epidimobife96-rgb/shengyu-xinshi/docs/README.md

# 项目文档索引

本目录同时保留课程正式资料和早期调试记录。请先确认资料状态，再将其中参数用于当前板卡。

## 课程与设计资料

| 文件 | 用途 | 状态 |
| --- | --- | --- |
| `电子系统课程设计-声语信使-设计任务书.pdf` | 课程要求和测评依据 | 正式资料 |
| `声语信使前期设计报告.docx` | 方案论证和前期设计 | 阶段资料 |
| 咪头、扬声器规格书 | 器件参数查询 | 参考资料 |

## 调试与检查资料

| 文件 | 用途 | 状态 |
| --- | --- | --- |
| `硬件检查记录.md` | 第二版原理图和网表的早期审查 | 历史记录，部分软件结论已过期 |
| `调试记录汇总.md` | 一位数字原型的接收测试 | 历史记录，不代表当前 48 字符协议 |
| `前导码与同步相关代码问题总结报告.docx` | 早期同步问题分析 | 历史专题报告 |

## 当前入口

- 当前固件与操作说明：[`../software/stm32_second_board/README.md`](../software/stm32_second_board/README.md)
- 第二版硬件资料：[`../hardware/syxs_board/README.md`](../hardware/syxs_board/README.md)
- 7 月 13 日起非代码工作日志：[`../logs/工作日志-9组-范嘉毅-24271097.md`](../logs/工作日志-9组-范嘉毅-24271097.md)
