epidimobife96-rgb/shengyu-xinshi/hardware/syxs_board/README.md

# 声语信使板卡

> **资料状态：当前第二版硬件。** `声波传输test2final.epro2` 是当前最新版嘉立创 EDA 专业版工程；原理图、网表及早期导出包继续保留，便于核对和追溯。

- `声波传输test2final.epro2`：**当前最新版**嘉立创 EDA 专业版完整工程，来自云端项目“声波传输test2final”，云端最后更新时间为 `2026-07-19 11:36:08`，包含 2 套原理图和 2 块 PCB。
- `声语信使.pdf`：第二版整板原理图。
- `声语信使网表.net`：第二版整板网表。
- `声语信使第二版_含PCB.epro2`：较早的第二版 EasyEDA Pro 工程包，保留作历史对照。
- `Altium_声语信使第二版_含PCB.zip`：Altium 导出的第二版工程包，包含 `PCB1.pcbdoc`、`PCB2.pcbdoc` 和对应原理图文件。
- `Schematic1_1核心板.schdoc`：第二版核心板 Altium 原理图文件。

最新版工程包 SHA-256：`4159EFEC7A3336F0FE0CCA2CC18DD9F91F495201BFD0BACFA06A15F3F0631176`

## 实物调试记录（截至 2026-07-20）

- 接收反相放大链路的 `R16` 在距离测试中先调整为 `130 kΩ`，后进一步调整至 `270 kΩ`；测量板上实装值后再计算实际增益。
- 第二版测试板为解决启动瞬间输入掉压，将 `C3` 更换为 `10 µF` 后恢复正常开机。
- `C32` 曾在电源排障中暂时拆除；是否恢复 `47 µF` 应以 `5V_IN/5V_SYS` 启动波形和多次冷启动结果为准。
- 第三块板仍需重点复查 VCAP、R34、运放中点偏置以及接收滤波器电阻电容焊点；这些是待验证项，不是已经确认的设计错误。

详细过程见 [`../../logs/工作日志-9组-范嘉毅-24271097.md`](../../logs/工作日志-9组-范嘉毅-24271097.md)。
