epidimobife96-rgb/shengyu-xinshi/software/stm32_first_board_tx/README.md

# 第一版板卡发送端

> **状态：历史测试工程。** 当前答辩主工程位于 [`../stm32_second_board/`](../stm32_second_board/)。本目录用于保留第一版板卡验证过程。

STM32F411 第一版板卡 4-FSK 发送端测试工程。

- PWM 输出：`PA0 / TIM2_CH1`
- 功放静音控制：`PB12`
- 串口调试：`USART2 115200 8N1`
- 工程来源：`D:\stm32\test1_tx`

Keil 工程复用 `software/stm32_receive/Drivers` 下的 HAL/CMSIS 驱动，避免重复提交驱动库。
