epidimobife96-rgb/shengyu-xinshi/software/stm32_receive/README.md

# STM32 早期接收工程与共享驱动

> **状态：历史接收工程，同时承担共享驱动库。** 当前答辩固件位于 [`../stm32_second_board/`](../stm32_second_board/)。

本目录保留早期分立接收端 CubeMX/HAL/Keil 工程。`Drivers/` 中的 STM32F4 HAL/CMSIS 被第二版工程通过相对路径复用，因此整理历史代码时不要删除或移动 `Drivers/`。
