epidimobife96-rgb/shengyu-xinshi/hardware/speaker_filter/README.md

# 喇叭滤波器

发送端功放前滤波器设计资料。

- `喇叭滤波器设计.ms14`：Multisim 设计文件。
- `喇叭滤波器网表.txt`：对应网表导出。
