epidimobife96-rgb/shengyu-xinshi/software/python_tools/README.md

# PC 端辅助工具

> **状态：早期原型辅助工具。** 当前第二版板卡能够独立收发，不依赖本目录脚本运行。

- `voice test.py`：通过电脑声卡播放 4-FSK 测试音，用于早期接收端验证。
