epidimobife96-rgb/shengyu-xinshi/logs/9组-宋嘉恒-24211218.docx

喇叭发声时间：

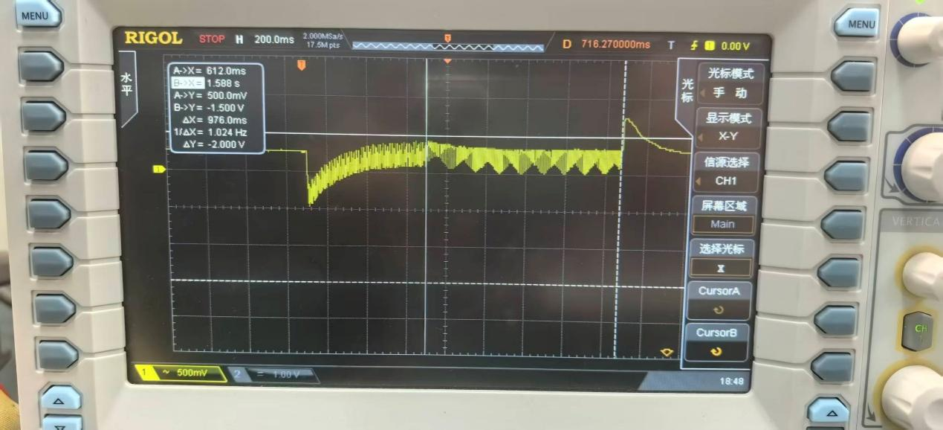
[picture p1: figure]

喇叭放电：

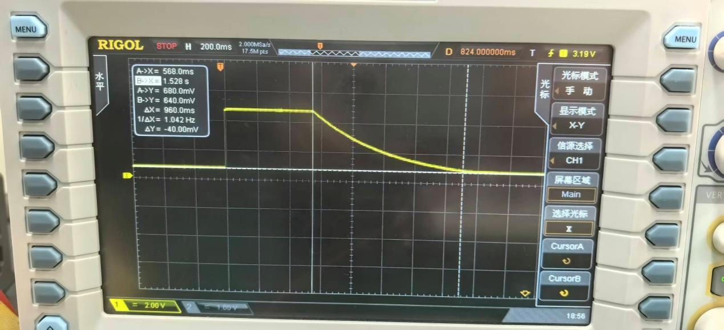
[picture p2: figure]

高频信号频率测量：

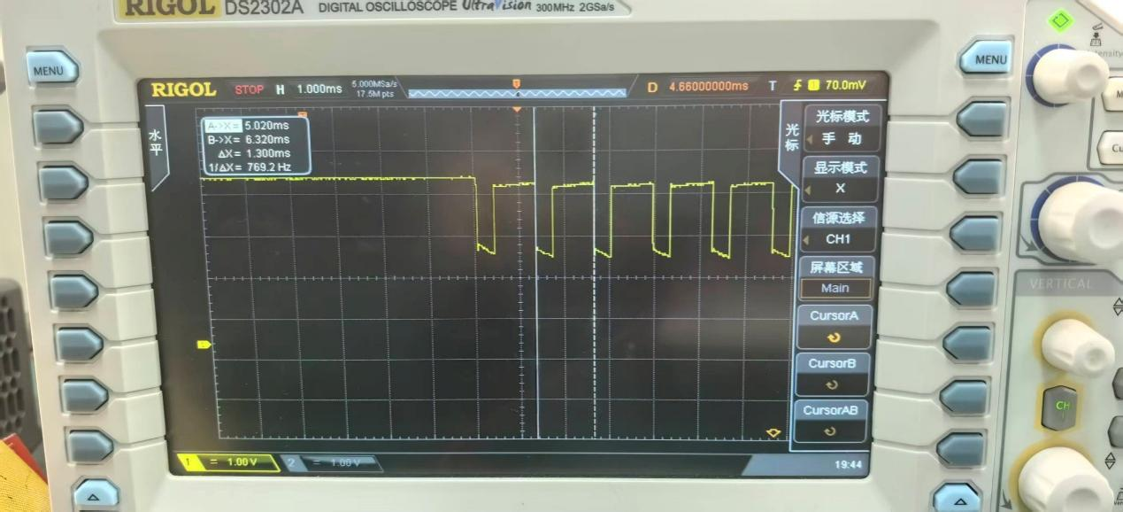
[picture p3: figure]

低频信号频率测量：

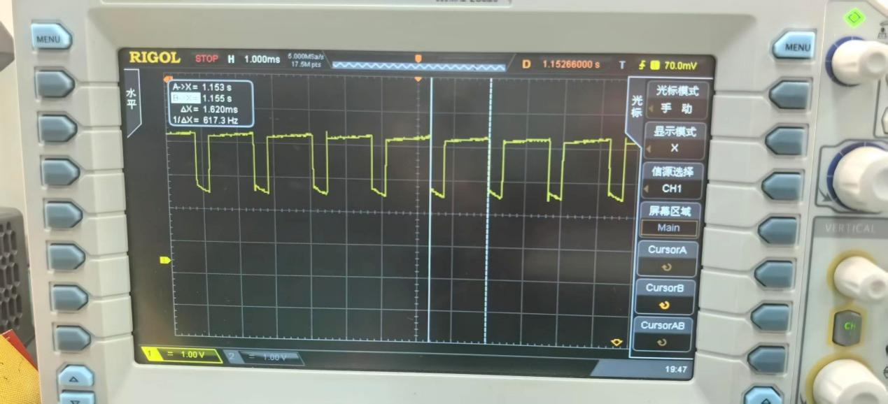
[picture p4: figure]

下降时间：

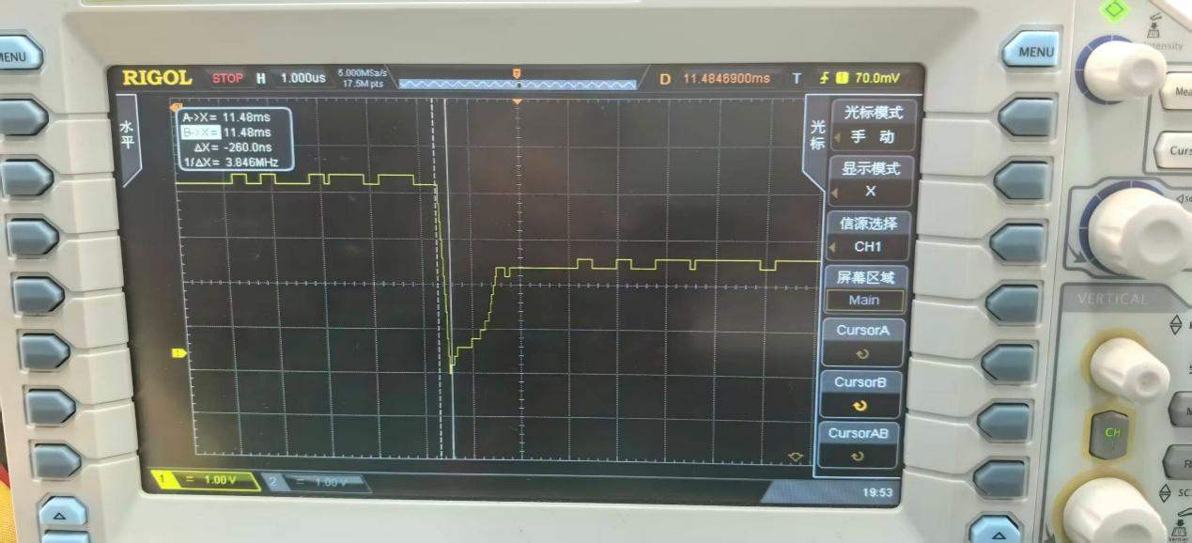
[picture p5: figure]

上升时间：

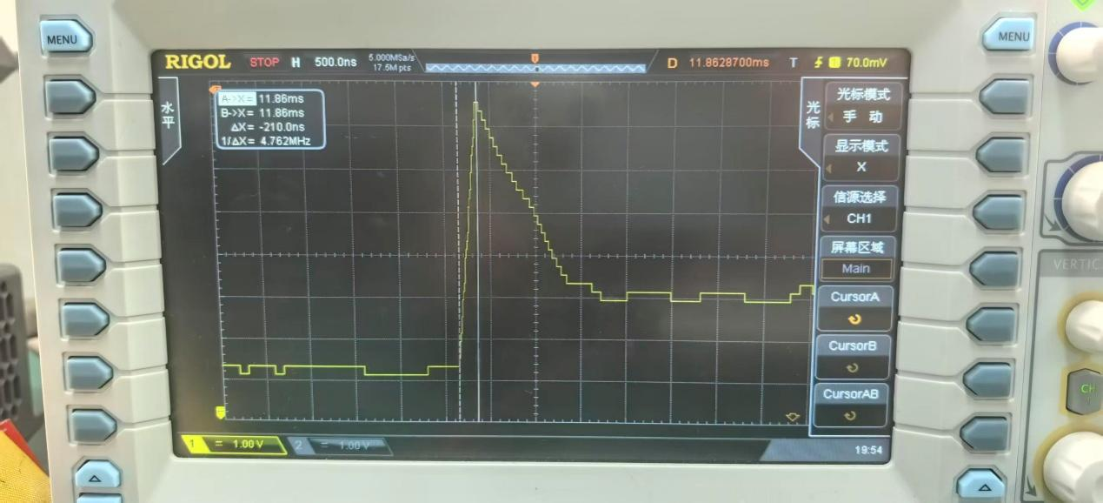
[picture p6: figure]

输出信号频率：

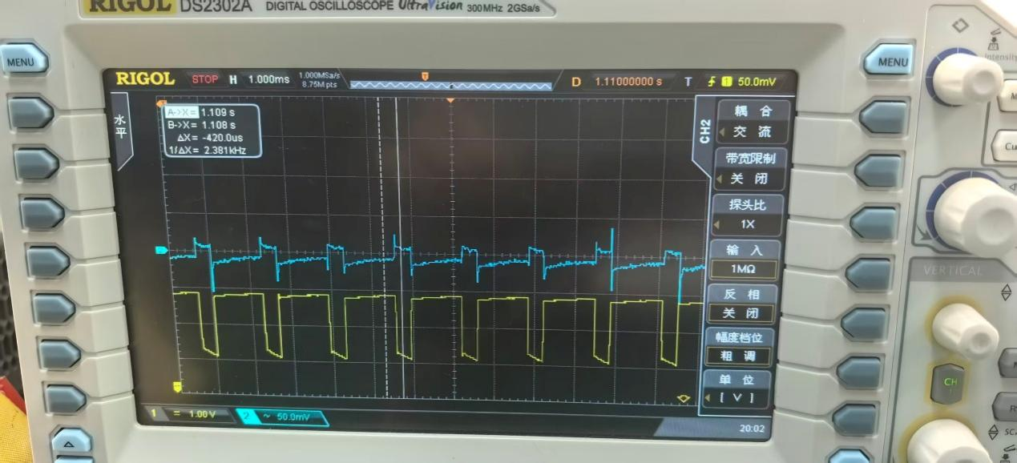
[picture p7: figure]

电源纹波测量：

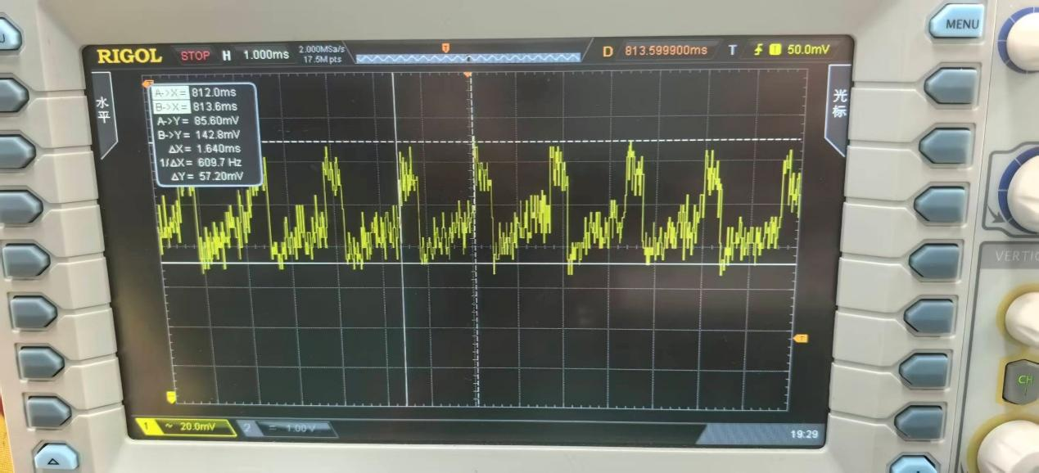
[picture p8: figure]
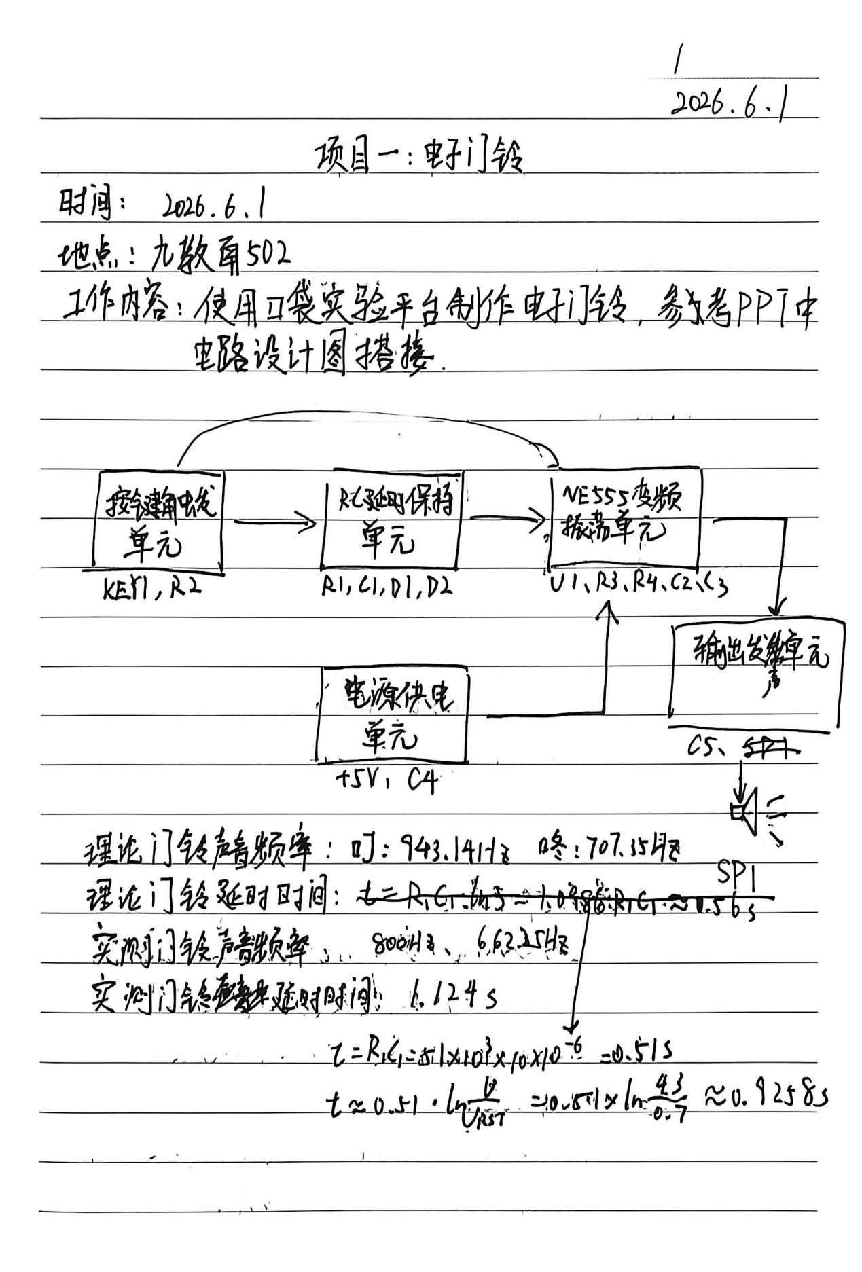
[picture p9: figure]
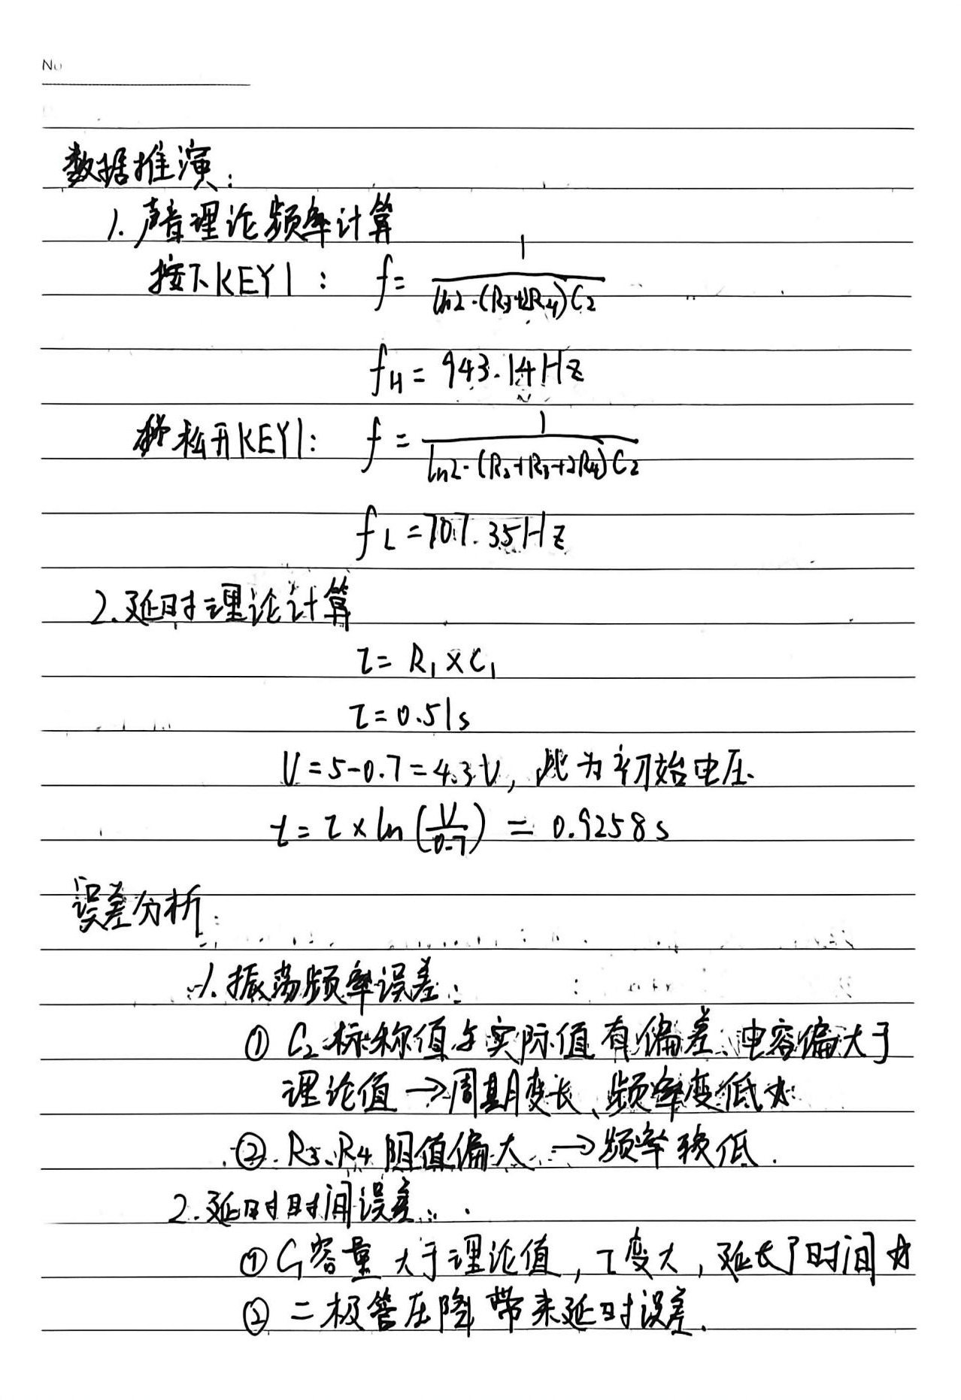
[picture p10: figure]
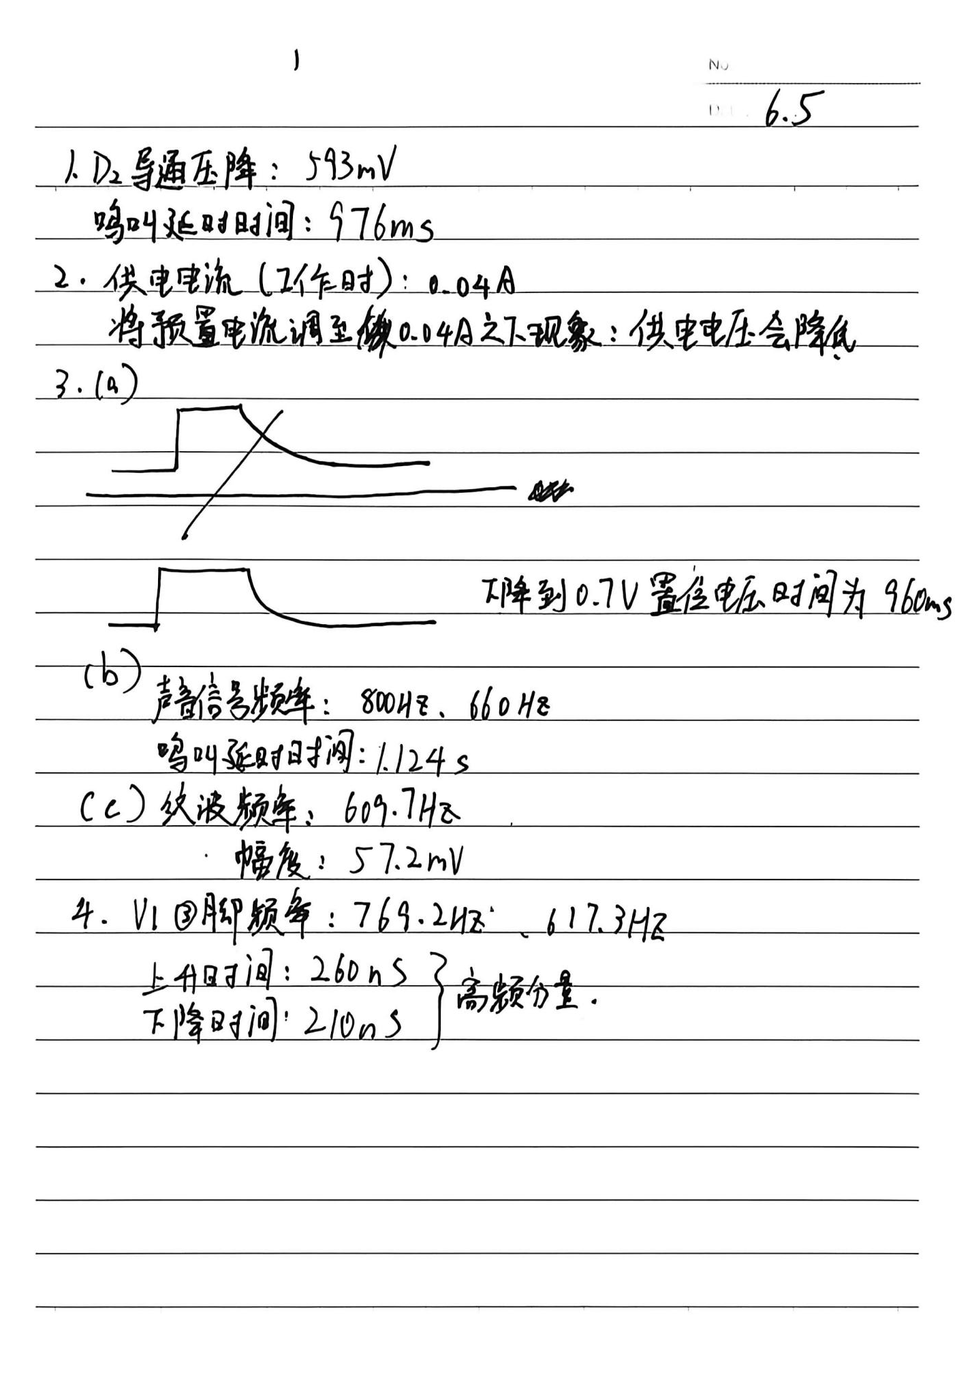
[picture p11: figure]
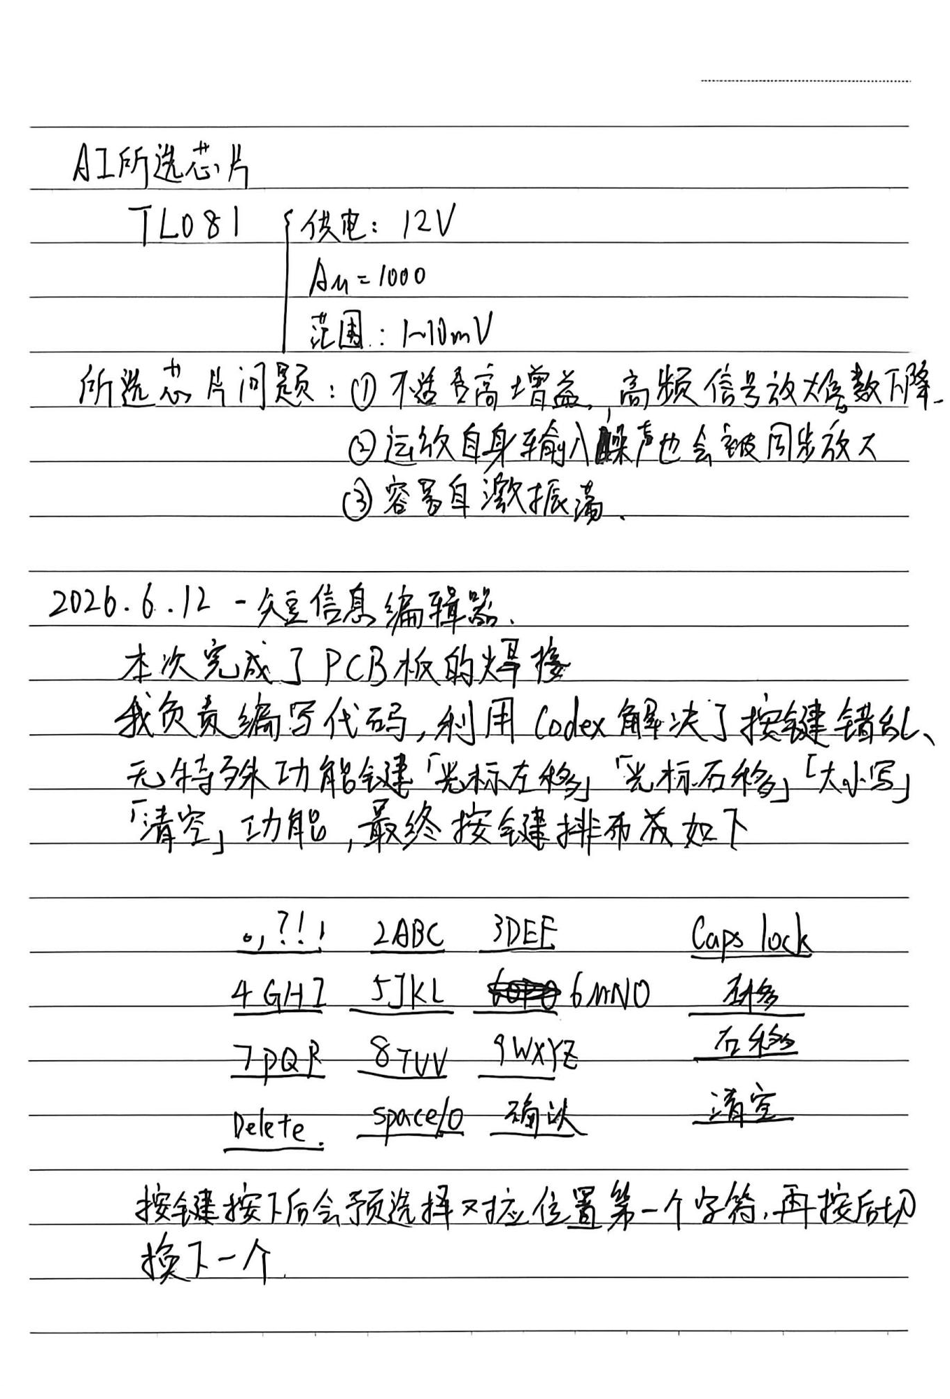
[picture p12: figure]
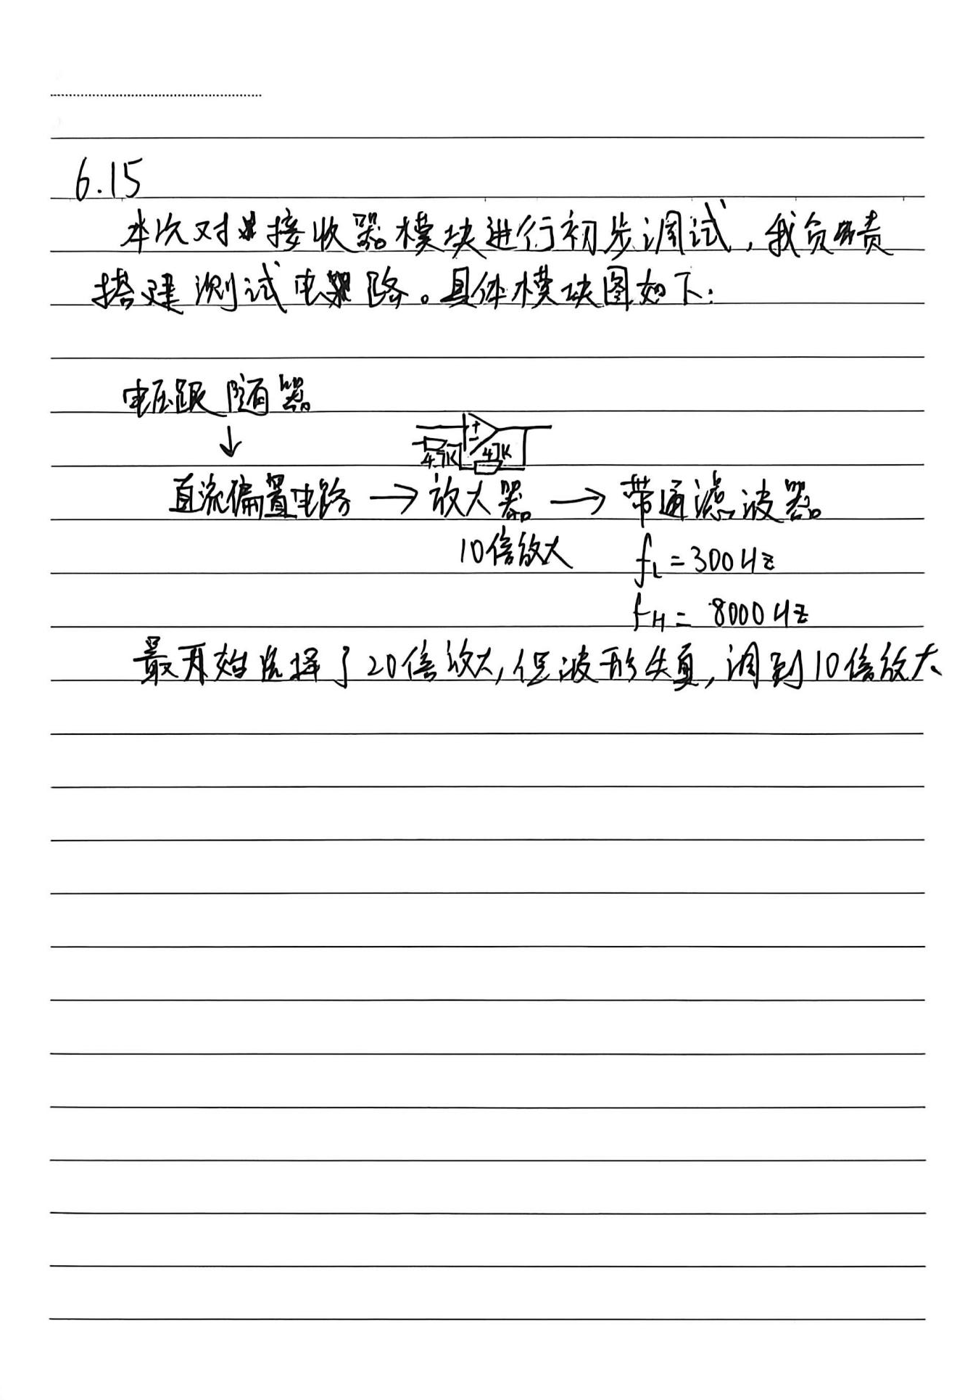
[picture p13: figure]

20260705更新

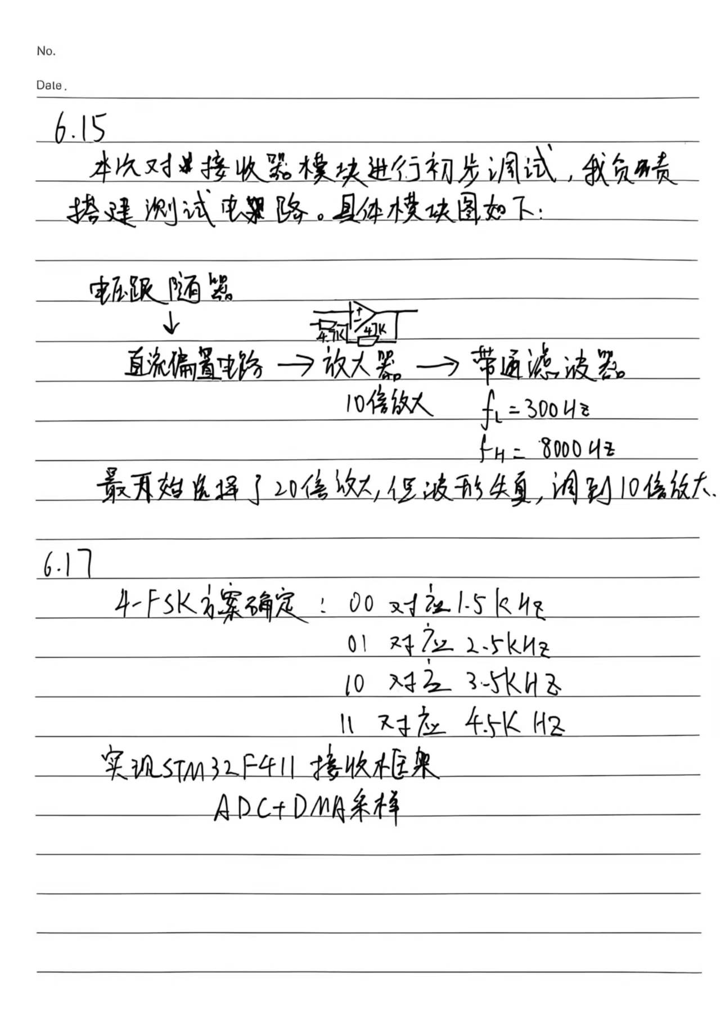
[picture p14: figure]
8bdfec3b620420859883c486c8d4a120
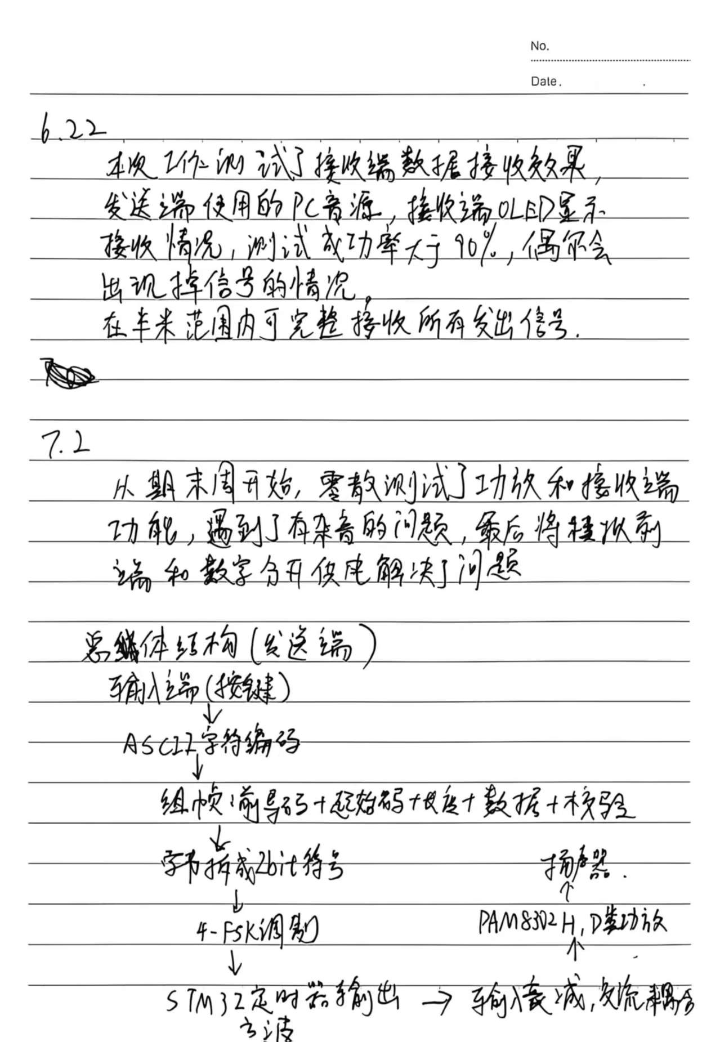
[picture p15: figure]
b882dd6c8d8499bfc34e1299eab81138
