epidimobife96-rgb/shengyu-xinshi/docs/C233956_咪头-麦克风_GMI9745P-32DB_规格书_WJ155228.PDF

GMI9745P 全指向驻积体咪头

详情说明

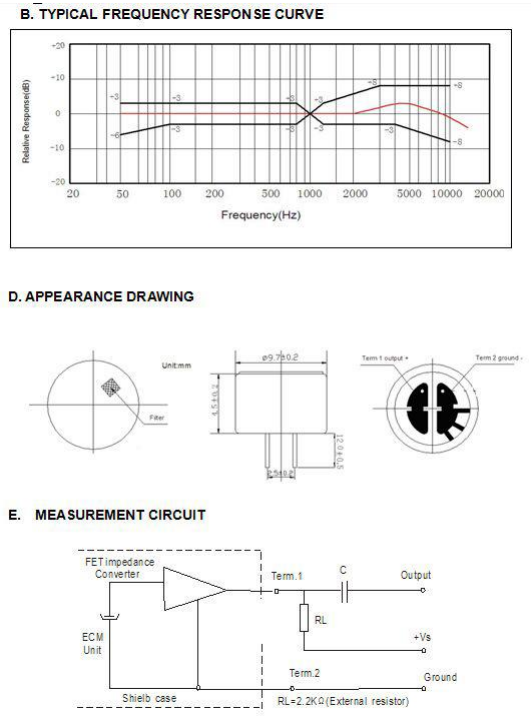
[picture p16: figure]

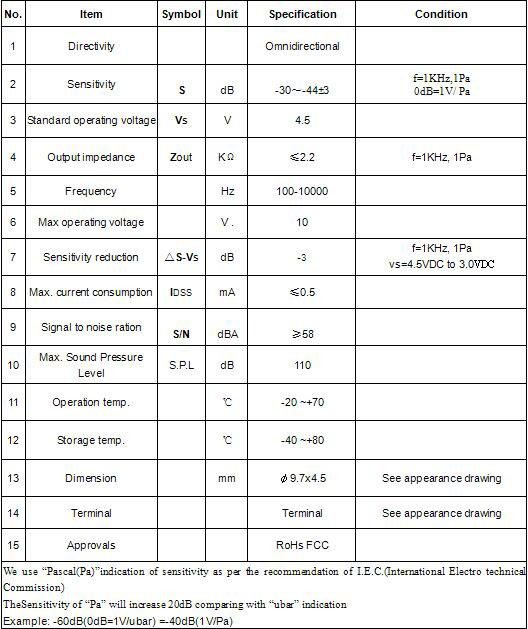
[picture p17: figure]
