epidimobife96-rgb/shengyu-xinshi/CHANGELOG.md

# 版本记录

## v1.0.0-demo - 2026-07-20

答辩演示版本。

- 将第二版板卡三模式收发固件设为当前主工程。
- 提供与源码对应的 `test2.hex`，完整帧时长约 19.941 秒。
- 加入“声语信使”及全体成员姓名、学号的 2 秒开机画面。
- 整理 STANDARD、MULTI-NODE、HIDDEN 三种模式的操作说明。
- 明确第二版硬件资料、实物器件调整和第三块板待复查项。
- 补充嘉立创 EDA 专业版云端项目“声波传输test2final”的最新版完整工程包，并保留早期工程作历史对照。
- 新增 2026 年 7 月 13 日起的非代码工作日志。
- 为 `docs/`、`hardware/`、`logs/`、`software/` 增加目录索引，并标注当前资料与历史资料。

构建结果：`0 Error(s), 3 Warning(s)`；警告均为 STM32 HAL 库未使用参数。

HEX SHA-256：`80D15BDB51B6F944610941480073471BF544B315394B95FF26E95740F8AD2A9D`

## 早期版本

早期提交保留了面包板、黑丸开发板、第一版整板、一位数字协议和 PC 播放测试等过程资料。它们用于说明迭代过程，不作为当前答辩固件入口。
