epidimobife96-rgb/shengyu-xinshi/hardware/syxs_board/声语信使.pdf

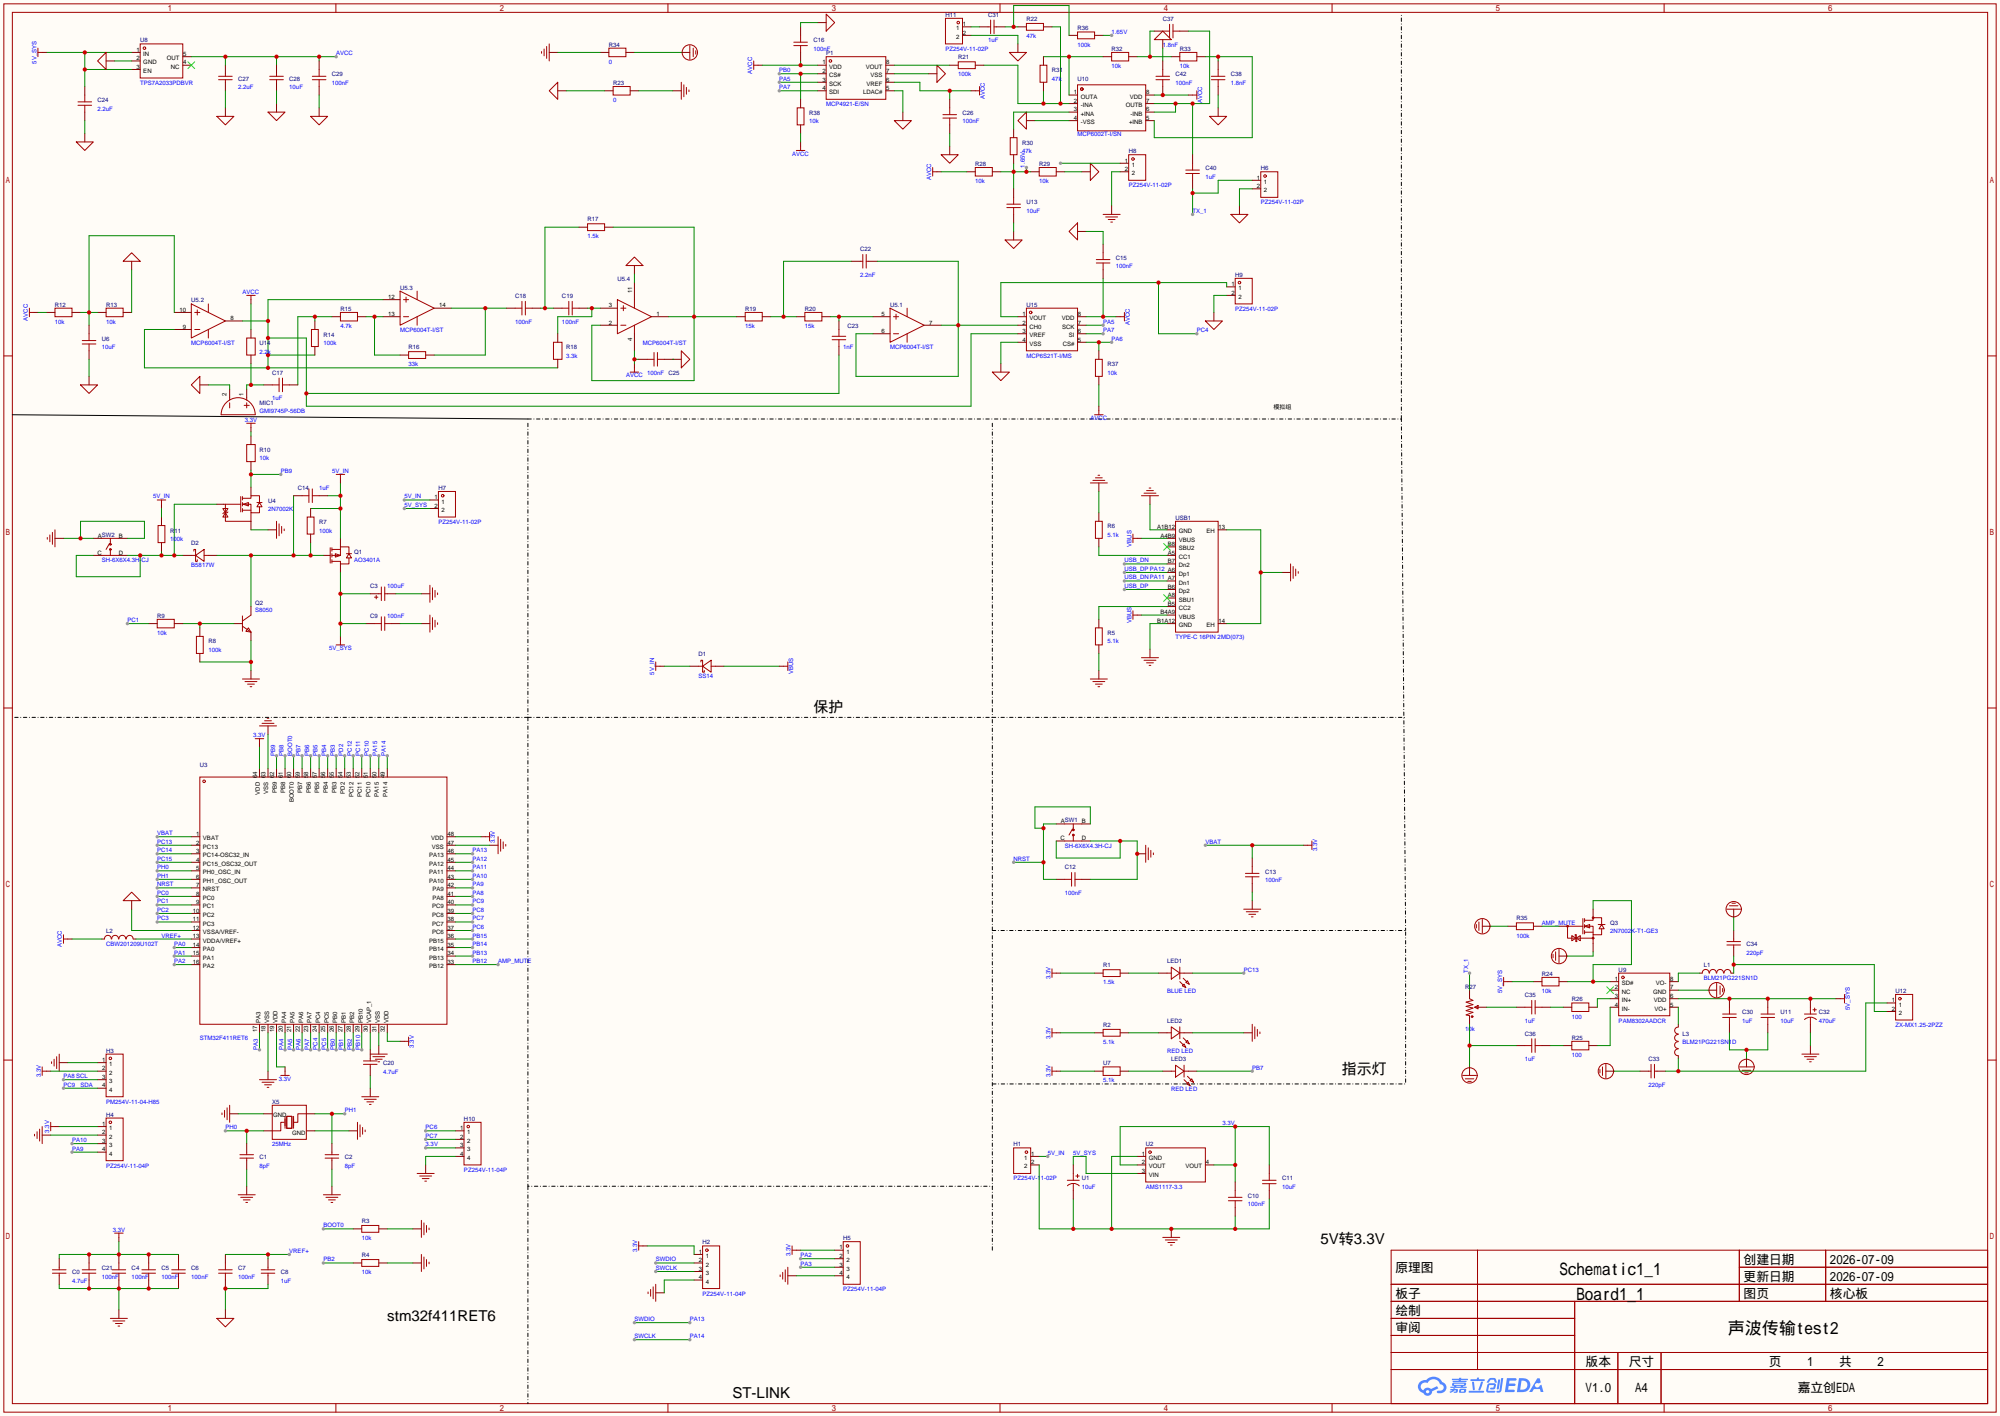
[picture p18: page 1]

原理图 | Schematic1_1 | 创建日期 | 2026-07-09
板子 | Board1_1 | 图页 | 核心板
绘制 | | 声波传输test2
审阅

更新日期 | 2026-07-09

V1.0 | A4 | 嘉立创EDA

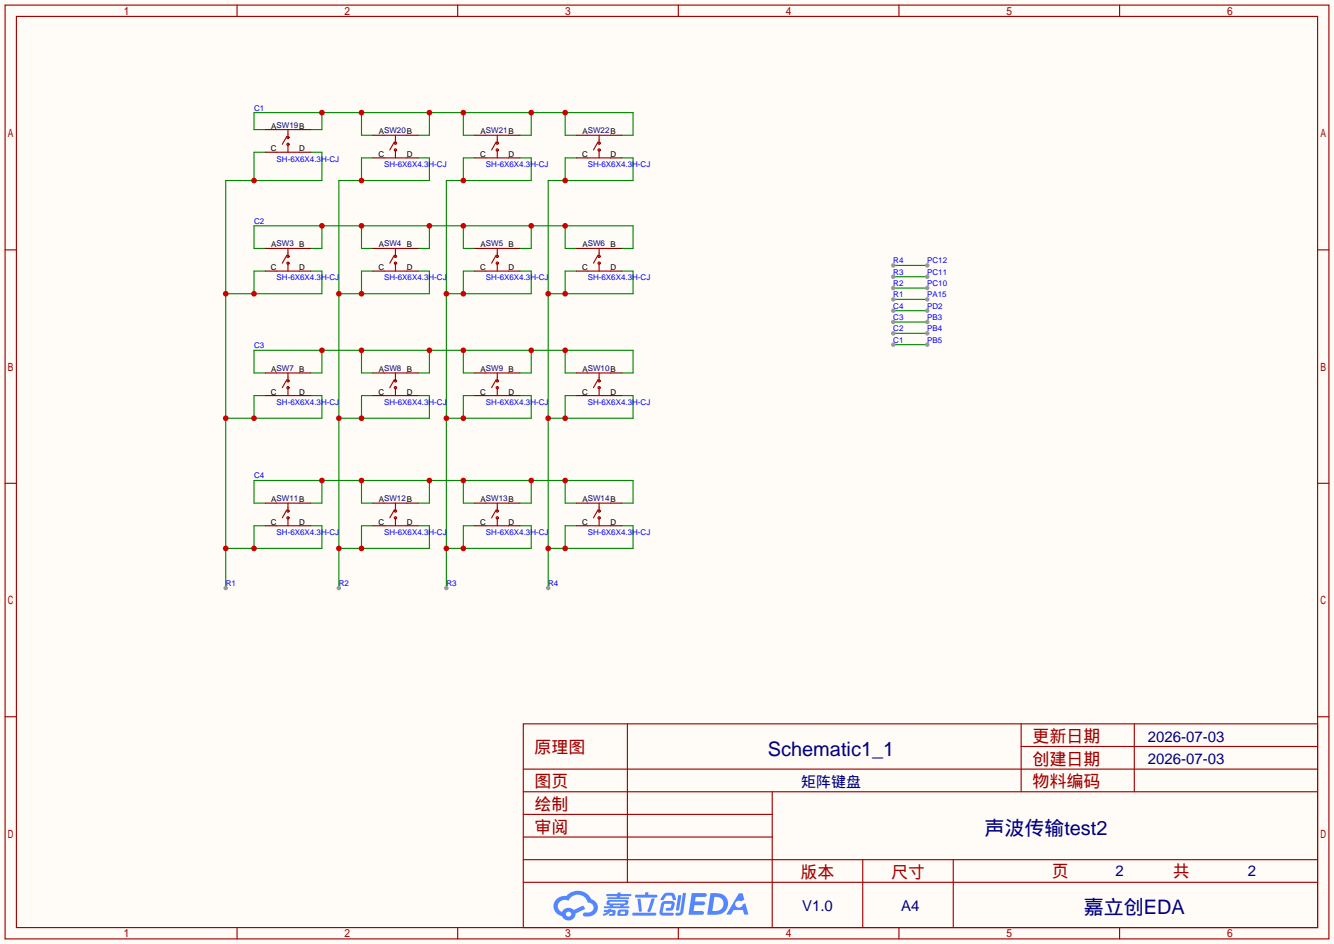
[picture p19: page 2]
