epidimobife96-rgb/shengyu-xinshi/hardware/mcu_board/短信息编辑器.pdf

# 用户按键

保护

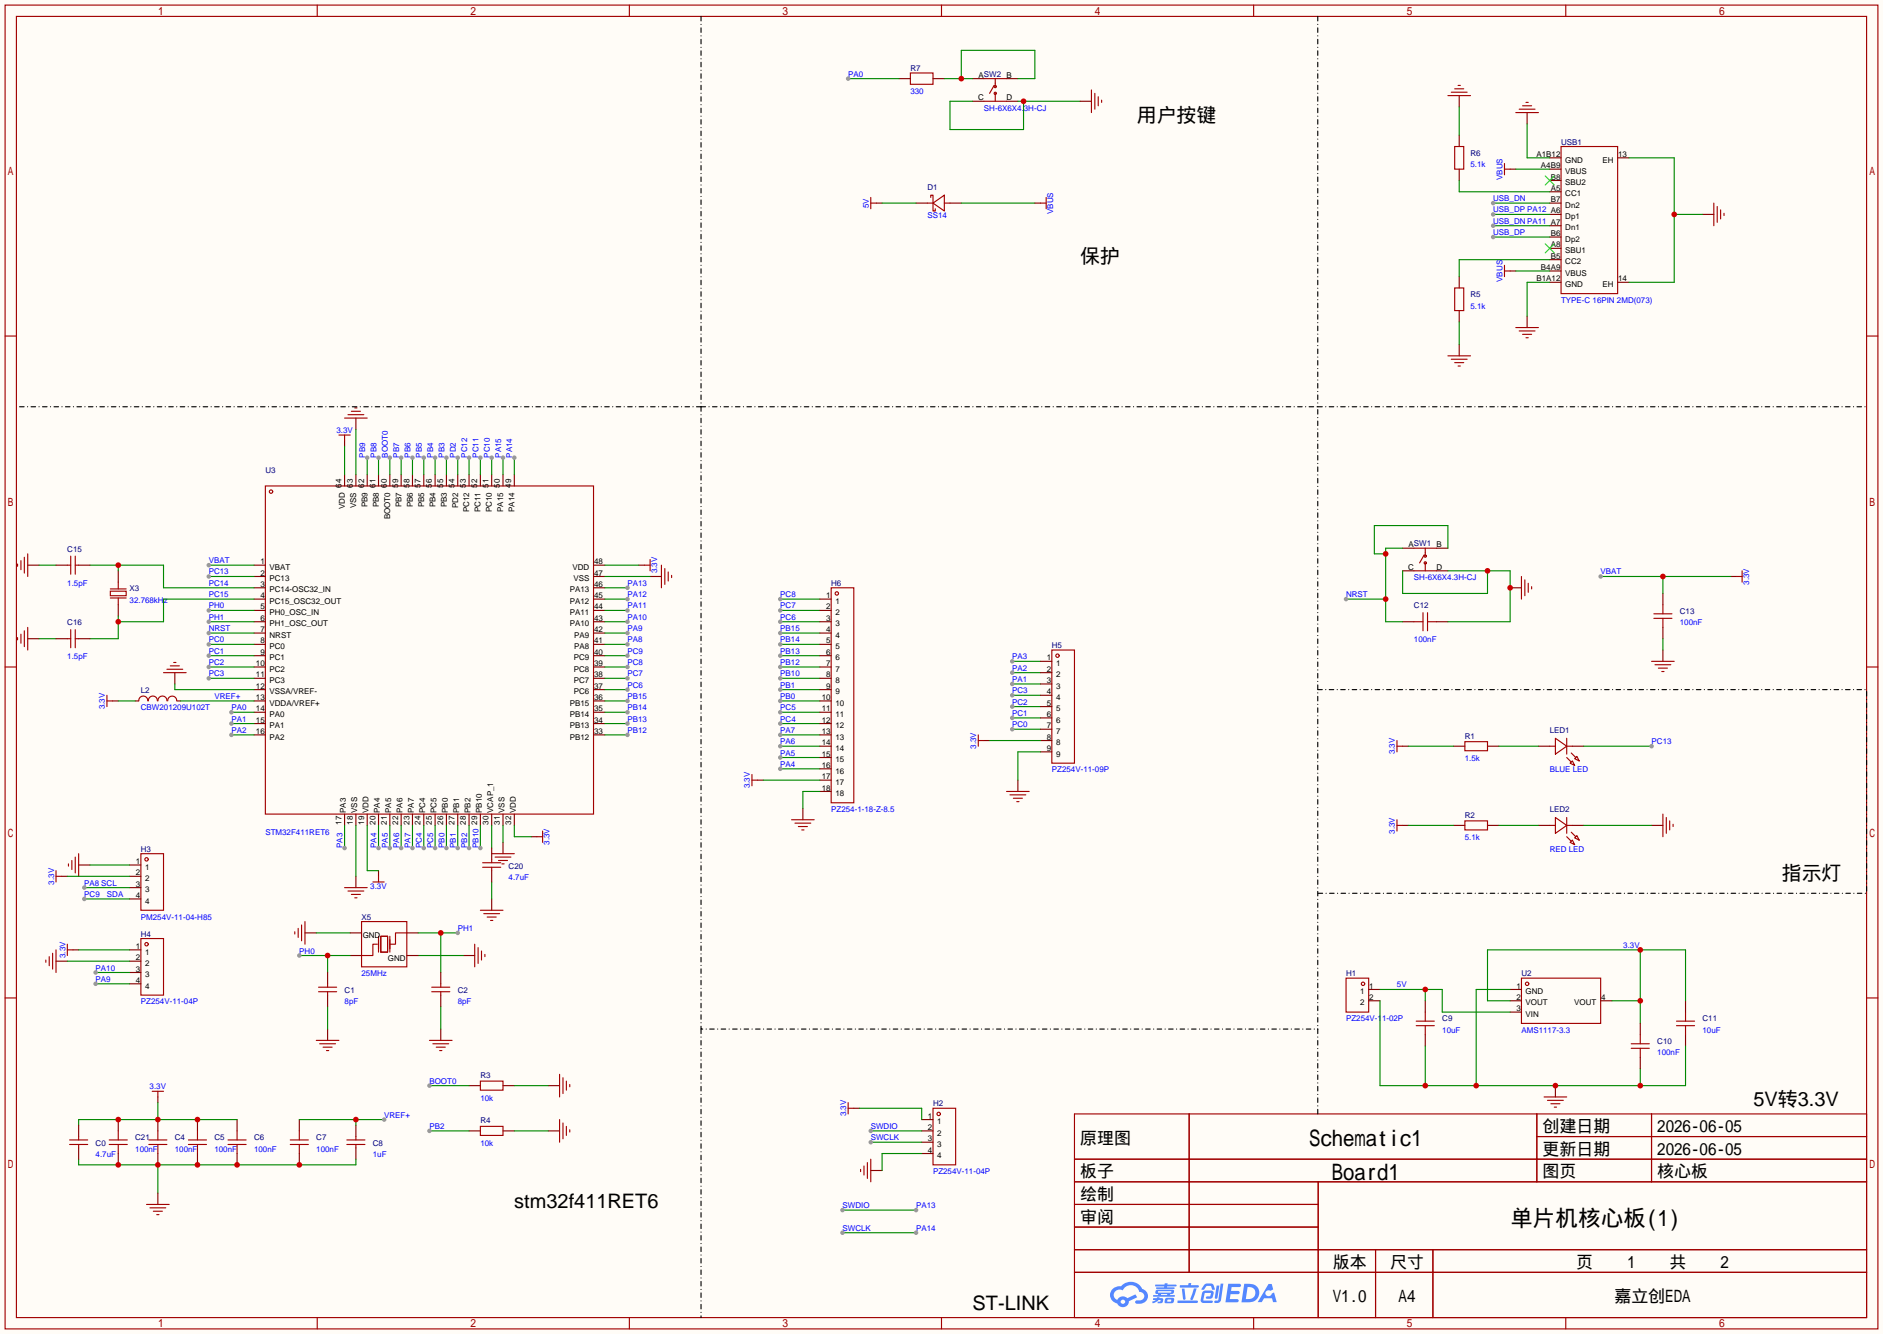
[picture p20: page 1]

原理图 | Schematic1 | 创建日期 | 2026-06-05

更新日期 | 2026-06-05

板子 | Board1 | 图页 | 核心板
绘制 | | 单片机核心板(1)
审阅

V1.0 | A4 | 嘉立创EDA

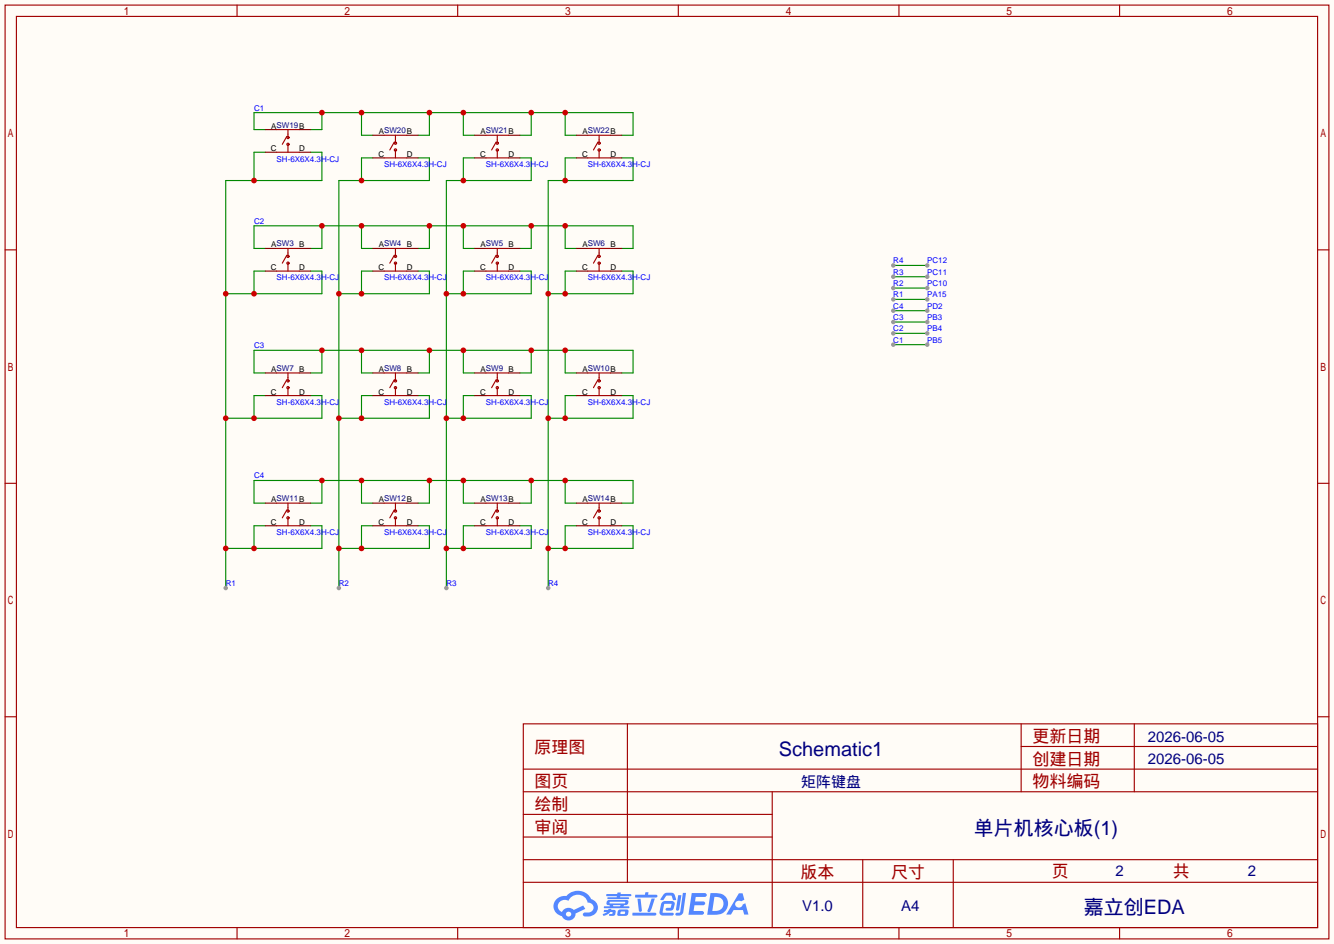
[picture p21: page 2]
