epidimobife96-rgb/shengyu-xinshi/(list of files, drawings)

Other design files:
hardware/filter/滤波器设计.ms14
hardware/speaker_filter/喇叭滤波器设计.ms14
hardware/syxs_board/Schematic1_1核心板.schdoc
