epidimobife96-rgb/shengyu-xinshi/software/stm32_second_board/Core/Src/main.c

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

#include "main.h"

/* USER CODE BEGIN Includes */
#include <stdio.h>
#include <string.h>
#include <math.h>
#if defined(__ARMCC_VERSION)
#include <rt_sys.h>
#endif
/* USER CODE END Includes */

/* USER CODE BEGIN Semihosting */
extern UART_HandleTypeDef huart2;

#if defined(__ARMCC_VERSION) && !defined(__CC_ARM)
__asm(".global __use_no_semihosting\n");
#endif

#if defined(__CC_ARM)
#pragma import(__use_no_semihosting)
#endif

#if defined(__CC_ARM) || defined(__ARMCC_VERSION)
void _ttywrch(int ch)
{
  (void)ch;
}

void _sys_exit(int status)
{
  (void)status;
  while (1)
  {
  }
}

FILEHANDLE _sys_open(const char *name, int openmode)
{
  (void)name;
  (void)openmode;
  return 1;
}

int _sys_close(FILEHANDLE fh)
{
  (void)fh;
  return 0;
}

int _sys_write(FILEHANDLE fh, const unsigned char *buf, unsigned len, int mode)
{
  (void)fh;
  (void)mode;
  HAL_UART_Transmit(&huart2, (uint8_t *)buf, (uint16_t)len, HAL_MAX_DELAY);
  return 0;
}

int _sys_read(FILEHANDLE fh, unsigned char *buf, unsigned len, int mode)
{
  (void)fh;
  (void)buf;
  (void)len;
  (void)mode;
  return 0;
}

int _sys_istty(FILEHANDLE fh)
{
  (void)fh;
  return 1;
}

int _sys_seek(FILEHANDLE fh, long pos)
{
  (void)fh;
  (void)pos;
  return -1;
}

long _sys_flen(FILEHANDLE fh)
{
  (void)fh;
  return -1;
}

int ferror(FILE *f)
{
  (void)f;
  return 0;
}
#endif
/* USER CODE END Semihosting */

/* USER CODE BEGIN PTD */
typedef struct
{
  uint8_t valid;
  uint16_t freq_hz;
  uint8_t bits;
  float max_energy;
  float second_energy;
  float data_energy[4U];
  float adc_mean;
  uint16_t adc_min;
  uint16_t adc_max;
} FSK_DetectResult;

typedef struct
{
  uint16_t fsk_index;
  uint8_t source;
  uint8_t selected_bits;
  float confidence;
  float energy[4U];
} RxDecisionDiagnostic;

typedef enum
{
  MSG_RX_SEARCH = 0,
  MSG_RX_START_0,
  MSG_RX_START_1,
  MSG_RX_RS_SYNC,
  MSG_RX_RS_CODEWORD,
  MSG_RX_END_0,
  MSG_RX_END_1
} MessageRxState;

typedef enum
{
  TX_MODE_IDLE = 0,
  TX_MODE_CALIBRATION,
  TX_MODE_FRAME
} TX_Mode;

typedef enum
{
  APP_MODE_RX = 0,
  APP_MODE_TX
} AppMode;

typedef enum
{
  COMM_MODE_UNSELECTED = 0,
  COMM_MODE_STANDARD,
  COMM_MODE_MULTI_NODE,
  COMM_MODE_HIDDEN
} CommunicationMode;

typedef enum
{
  TX_FRAME_TONE = 0,
  TX_FRAME_GAP
} TX_FramePart;

typedef enum
{
  MESSAGE_PAYLOAD_OK = 0,
  MESSAGE_PAYLOAD_CRC_FAIL,
  MESSAGE_PAYLOAD_DATA_AFTER_PAD,
  MESSAGE_PAYLOAD_INVALID_CODE,
  MESSAGE_PAYLOAD_EMPTY
} MessagePayloadStatus;
/* USER CODE END PTD */

/* USER CODE BEGIN PD */
#define FSK_NORMAL_FS_HZ          16000U
#define FSK_HIDDEN_FS_HZ          20000U
#define FSK_SYMBOL_MS             20U
#define FSK_NORMAL_SYMBOL_SAMPLES ((FSK_NORMAL_FS_HZ * FSK_SYMBOL_MS) / 1000U)
#define FSK_HIDDEN_SYMBOL_SAMPLES ((FSK_HIDDEN_FS_HZ * FSK_SYMBOL_MS) / 1000U)
#define FSK_MAX_SYMBOL_SAMPLES    FSK_HIDDEN_SYMBOL_SAMPLES
#define ADC_DMA_BUFFER_SAMPLES    (FSK_MAX_SYMBOL_SAMPLES * 2U)
#define TIM2_COUNTER_CLOCK_HZ     16000000U

#define FSK_FREQ_COUNT            5U
#define FSK_DATA_FREQ_COUNT       4U
#define FSK_RX_FREQ_00_HZ         1500U
#define FSK_SYNC_FREQ_HZ          2000U
#define FSK_RX_FREQ_01_HZ         2500U
#define FSK_RX_FREQ_10_HZ         3500U
#define FSK_RX_FREQ_11_HZ         4500U
#define FSK_HIGH_FREQ_00_HZ       6400U
#define FSK_HIGH_FREQ_01_HZ       6550U
#define FSK_HIGH_SYNC_FREQ_HZ     6700U
#define FSK_HIGH_FREQ_10_HZ       6850U
#define FSK_HIGH_FREQ_11_HZ       7000U
#define TX_HIGH_PROFILE_AMP       96U
/* Hidden mode uses the restored high-frequency profile. */
#define FSK_HIGH_PROFILE_ENABLE   1U
#define FSK_SYNC_SYMBOL           0x04U
#define FSK_ENERGY_THRESHOLD      5000000.0f
#define FSK_RATIO_THRESHOLD       1.3f
#define FSK_NOISE_MULTIPLIER      3.0f
#define FSK_NOISE_MIN_FLOOR       3000000.0f
#define FSK_SOFT_ENERGY_THRESHOLD 2500000.0f
#define FSK_SOFT_RATIO_THRESHOLD  1.05f
#define FSK_SOFT_NOISE_MULTIPLIER 1.15f
#define END1_SOFT_ACCEPT_MIN_MS    20U
#define END1_SOFT_ACCEPT_MAX_MS    210U

#define UART_IDLE_LOG_MS          1000U
#define OLED_IDLE_UPDATE_MS       1000U
#define OLED_VALID_UPDATE_MS      200U

#define DEBUG_UART_ENABLE         1U
#define FSK_PI                    3.14159265358979323846f
#define PREAMBLE_STABLE_WINDOWS   1U
#define START_STABLE_WINDOWS      2U
#define DIGIT_GAP_INVALID_WINDOWS 1U
#define RX_SAME_SYMBOL_REACCEPT_MS 65U
#define DIGIT_FRAME_TIMEOUT_MS    22000U
#define START_SEQUENCE_TIMEOUT_MS 400U
#define DIGIT_NO_SYMBOL           0xFFU
#define MSG_PREAMBLE_LEN          4U
#define MSG_START_LEN             2U
#define MSG_END_LEN               2U
#define RS_DATA_SYMBOLS           25U
#define RS_PARITY_SYMBOLS         10U
#define RS_CODEWORD_SYMBOLS       (RS_DATA_SYMBOLS + RS_PARITY_SYMBOLS)
#define RS_CORRECTABLE_SYMBOLS    (RS_PARITY_SYMBOLS / 2U)
#define RS_BLOCK_COUNT            2U
#define RS_TOTAL_DATA_SYMBOLS     (RS_DATA_SYMBOLS * RS_BLOCK_COUNT)
#define RS_TOTAL_PARITY_SYMBOLS   (RS_PARITY_SYMBOLS * RS_BLOCK_COUNT)
#define RS_TOTAL_CODEWORD_SYMBOLS (RS_CODEWORD_SYMBOLS * RS_BLOCK_COUNT)
#define RS_TOTAL_CORRECTABLE      (RS_CORRECTABLE_SYMBOLS * RS_BLOCK_COUNT)
#define RS_FSK_SYMBOLS_PER_SYMBOL 3U
#define RS_FIELD_ORDER            63U
#define RS_PRIMITIVE_POLY         0x43U
#define RS_PAD_VALUE              0x3FU
#define MESSAGE_CRC_SYMBOLS       2U
#define MESSAGE_MAX_LEN           (RS_TOTAL_DATA_SYMBOLS - MESSAGE_CRC_SYMBOLS)
#define MESSAGE_CRC12_POLY        0x080FU
#define MESSAGE_CRC12_MASK        0x0FFFU
#define MESSAGE_CODE_INVALID      0xFFU
#define TEXT_TAP_TIMEOUT_MS       800U

#define TX_AUDIO_FS_HZ            32000U
#define TX_PWM_PERIOD             255U
#define TX_PWM_MID                128U
#define TX_SINE_TABLE_SIZE        64U
#define TX_MAX_SINE_AMP           126U
#define TX_DAC_COMMAND_ACTIVE_1X  0x3000U
#define TX_DAC_CODE_SHIFT         4U
#define TX_DAC_MID_CODE           ((uint16_t)TX_PWM_MID << TX_DAC_CODE_SHIFT)
#define RX_PGA_DEFAULT_GAIN_CODE  0x07U  /* MCP6S21 gain code 7 = x32 */
#define RX_PGA_MULTI_GAIN_CODE    0x01U  /* MCP6S21 gain code 1 = x2 */
#define TX_TONE_MS                60U
#define TX_GAP_MS                 9U
#define TX_STEP_MS                (TX_TONE_MS + TX_GAP_MS)
#define TX_REPEAT_COUNT           1U
#define TX_FRAME_SYMBOLS_PER_REPEAT \
  (MSG_PREAMBLE_LEN + MSG_START_LEN + \
   (RS_TOTAL_CODEWORD_SYMBOLS * (RS_FSK_SYMBOLS_PER_SYMBOL + 1U)) + 1U + MSG_END_LEN)
#define TX_FRAME_MAX_SYMBOLS      (TX_FRAME_SYMBOLS_PER_REPEAT * TX_REPEAT_COUNT)
#define TX_FRAME_DURATION_MS      (TX_FRAME_MAX_SYMBOLS * TX_STEP_MS)
#define TX_TONE_SAMPLES           ((TX_AUDIO_FS_HZ * TX_TONE_MS) / 1000U)
#define TX_GAP_SAMPLES            ((TX_AUDIO_FS_HZ * TX_GAP_MS) / 1000U)
#define HALF_DUPLEX_RX_GUARD_MS   120U
#define RS_MARKER_INTERVAL_MS     ((RS_FSK_SYMBOLS_PER_SYMBOL + 1U) * TX_STEP_MS)
#define RS_SLOT_WIDTH_MS          TX_STEP_MS
#define RS_MARKER_ACCEPT_EARLY_MS 40U
#define RS_SLOT_CAPTURE_START_MS  40U
#define RS_SLOT_CAPTURE_END_MS    (RS_MARKER_INTERVAL_MS - 20U)
#define RS_SOFT_CAPTURE_START_MS  60U
#define RS_VOTE_RATIO_CAP         8.0f
#define RX_DIAG_WORST_COUNT       8U
#define RX_DECISION_VOTE          0U
#define RX_DECISION_NEAREST       1U
#define RX_DECISION_SOFT          2U
#define RX_DECISION_ERASURE       3U

#if TX_FRAME_DURATION_MS > 20100U
#error "TX message frame must remain no longer than 20.10 seconds"
#endif

#define CALIBRATION_STAGE_MS             1000U
#define CALIBRATION_PASS_COUNT            2U
#define CALIBRATION_BOUNDARY_MS            300U
#define CALIBRATION_BOUNDARY_STABLE_WINDOWS 5U
#define CALIBRATION_INTERPASS_GAP_MS      2000U
#define CALIBRATION_GAP_DETECT_MS         1200U
#define CALIBRATION_TX_GUARD_MS          300U
#define CALIBRATION_STAGE_SAMPLES        ((TX_AUDIO_FS_HZ * CALIBRATION_STAGE_MS) / 1000U)
#define CALIBRATION_BOUNDARY_SAMPLES     ((TX_AUDIO_FS_HZ * CALIBRATION_BOUNDARY_MS) / 1000U)
#define CALIBRATION_INTERPASS_GAP_SAMPLES ((TX_AUDIO_FS_HZ * CALIBRATION_INTERPASS_GAP_MS) / 1000U)
#define CALIBRATION_TX_GUARD_SAMPLES     ((TX_AUDIO_FS_HZ * CALIBRATION_TX_GUARD_MS) / 1000U)
#define CALIBRATION_STABLE_WINDOWS       5U
#define CALIBRATION_ENERGY_WINDOWS       12U
#define CALIBRATION_LOST_WINDOWS_MAX     3U
#define CALIBRATION_PROGRESS_TIMEOUT_MS  2500U
#define CALIBRATION_SCALE_MIN            0.005f
#define RX_PGA_ADC_LOW_PEAK              350U
#define RX_PGA_ADC_HIGH_PEAK             1650U
#define RX_PGA_ADC_CLIP_MARGIN            128U
#define RX_PGA_AGC_SETTLE_MS               60U
#define RX_PGA_AGC_HIGH_WINDOWS             4U
#define RX_PGA_AGC_CLIP_WINDOWS             3U
#define RX_PGA_AGC_LOW_WINDOWS              5U
#define RX_PGA_AGC_TONE_RATIO              1.8f
#define PREAMBLE_RECOVERY_ENERGY_MIN     5000000.0f
#define PREAMBLE_FRAME_SCALE_MIN_CORR     0.50f
#define PREAMBLE_FRAME_SCALE_MAX_CORR     2.00f
#define PREAMBLE_FRAME_MAX_4500_TO_3500   2.50f
#define PREAMBLE_RECOVERY_01_END_MS       70U
#define PREAMBLE_RECOVERY_10_START_MS     50U
#define PREAMBLE_RECOVERY_10_END_MS      140U
#define PREAMBLE_RECOVERY_11_START_MS    120U
#define PREAMBLE_RECOVERY_11_END_MS      210U
#define PREAMBLE_RECOVERY_START0_START_MS 190U
#define PREAMBLE_RECOVERY_START0_END_MS  255U
#define PREAMBLE_RECOVERY_START1_START_MS 260U
#define PREAMBLE_RECOVERY_START1_END_MS  330U
#define PREAMBLE_RECOVERY_MARKER_MIN_MS  300U
#define PREAMBLE_RECOVERY_MARKER_MAX_MS  400U

#define KEYPAD_ROWS               4U
#define KEYPAD_COLS               4U
#define KEYPAD_SCAN_MS            20U
#define KEYPAD_DEBOUNCE_SCANS     2U
#define KEYPAD_LONG_PRESS_MS      800U
#define KEY_NONE                  0U

#define OLED_I2C_ADDR_3C          (0x3CU << 1)
#define OLED_I2C_ADDR_3D          (0x3DU << 1)
#define OLED_WIDTH                128U
#define OLED_HEIGHT               64U
#define OLED_PAGES                (OLED_HEIGHT / 8U)

#define MESSAGE_STORE_VISIBLE_COUNT 5U
#define MESSAGE_STORE_FLASH_START   0x08060000UL
#define MESSAGE_STORE_FLASH_END     0x08080000UL
#define MESSAGE_STORE_MAGIC         0x3147534DUL
#define MESSAGE_STORE_COMMIT        0xA55AC33CUL
#define MESSAGE_STORE_LENGTH_MASK   0x000000FFUL
#define MESSAGE_STORE_SOURCE_SHIFT  8U
#define MESSAGE_STORE_DEST_SHIFT    10U
#define MESSAGE_STORE_ROUTE_MASK    0x00000F00UL
#define RX_COMPLETE_LED_ON_MS       3000U
/* USER CODE END PD */

ADC_HandleTypeDef hadc1;
DMA_HandleTypeDef hdma_adc1;
I2C_HandleTypeDef hi2c3;
SPI_HandleTypeDef hspi1;
TIM_HandleTypeDef htim2;
TIM_HandleTypeDef htim3;
UART_HandleTypeDef huart2;

/* USER CODE BEGIN PV */
typedef struct
{
  uint32_t magic;
  uint32_t sequence;
  uint32_t length;
  uint8_t text[MESSAGE_MAX_LEN];
  uint32_t hash;
  uint32_t commit;
} MessageStoreRecord;

typedef struct
{
  uint32_t sequence;
  uint8_t len;
  uint8_t source;
  uint8_t destination;
  char text[MESSAGE_MAX_LEN + 1U];
} StoredMessage;

static uint16_t adc_dma_buf[ADC_DMA_BUFFER_SAMPLES];
static volatile uint8_t symbol_ready = 0U;
static volatile uint16_t symbol_start_index = 0U;
static uint32_t fsk_sample_rate_hz = FSK_NORMAL_FS_HZ;
static uint16_t fsk_symbol_samples = FSK_NORMAL_SYMBOL_SAMPLES;

static const uint16_t fsk_normal_freqs_hz[FSK_FREQ_COUNT] = {
  FSK_RX_FREQ_00_HZ,
  FSK_RX_FREQ_01_HZ,
  FSK_RX_FREQ_10_HZ,
  FSK_RX_FREQ_11_HZ,
  FSK_SYNC_FREQ_HZ
};
#if FSK_HIGH_PROFILE_ENABLE != 0U
static const uint16_t fsk_high_freqs_hz[FSK_FREQ_COUNT] = {
  FSK_HIGH_FREQ_00_HZ,
  FSK_HIGH_FREQ_01_HZ,
  FSK_HIGH_FREQ_10_HZ,
  FSK_HIGH_FREQ_11_HZ,
  FSK_HIGH_SYNC_FREQ_HZ
};
#endif
static uint16_t fsk_tx_freqs_hz[FSK_FREQ_COUNT] = {
  FSK_RX_FREQ_00_HZ,
  FSK_RX_FREQ_01_HZ,
  FSK_RX_FREQ_10_HZ,
  FSK_RX_FREQ_11_HZ,
  FSK_SYNC_FREQ_HZ
};
static uint16_t fsk_rx_freqs_hz[FSK_FREQ_COUNT];
#if FSK_HIGH_PROFILE_ENABLE != 0U
static uint8_t fsk_high_profile_enabled = 0U;
#endif
static const uint8_t fsk_bits[FSK_FREQ_COUNT] = {0x00U, 0x01U, 0x02U, 0x03U, FSK_SYNC_SYMBOL};
static const uint8_t msg_preamble[MSG_PREAMBLE_LEN] = {0x00U, 0x01U, 0x02U, 0x03U};
static const uint8_t msg_end[MSG_END_LEN] = {0x02U, 0x03U};
static float fsk_goertzel_coeffs[FSK_FREQ_COUNT];
static float fsk_energy_scale[FSK_FREQ_COUNT];
static float calibration_energy_scale[FSK_DATA_FREQ_COUNT];

static float calibration_energy[FSK_DATA_FREQ_COUNT];
static float calibration_energy_sum = 0.0f;
static uint8_t calibration_energy_windows = 0U;
static uint8_t calibration_lost_windows = 0U;
static uint8_t calibration_stage = 0U;
static uint8_t calibration_stable_windows = 0U;
static uint8_t calibration_capture_active = 0U;
static uint8_t calibration_complete = 0U;
static uint8_t calibration_failed = 0U;
static uint32_t calibration_progress_tick = 0U;
static uint8_t calibration_pass = 0U;
static uint8_t calibration_coarse_activity = 0U;
static uint8_t calibration_boundary_windows = 0U;
static uint32_t calibration_coarse_last_signal_tick = 0U;
static uint16_t calibration_adc_min_seen = 0xFFFFU;
static uint16_t calibration_adc_max_seen = 0U;
static uint16_t calibration_adc_mean_last = 2048U;
static uint32_t rx_pga_agc_last_adjust_tick = 0U;
static uint8_t rx_pga_agc_high_windows = 0U;
static uint8_t rx_pga_agc_clip_windows = 0U;
static uint8_t rx_pga_agc_low_windows = 0U;
static const uint8_t rx_pga_gain_values[8U] = {1U, 2U, 4U, 5U, 8U, 10U, 16U, 32U};
static uint8_t rx_pga_gain_code = RX_PGA_DEFAULT_GAIN_CODE;

static uint16_t oled_i2c_addr = OLED_I2C_ADDR_3C;
static uint8_t oled_ready = 0U;
static float fsk_noise_floor[FSK_FREQ_COUNT] = {
  FSK_NOISE_MIN_FLOOR,
  FSK_NOISE_MIN_FLOOR,
  FSK_NOISE_MIN_FLOOR,
  FSK_NOISE_MIN_FLOOR,
  FSK_NOISE_MIN_FLOOR
};

static uint8_t digit_candidate_bits = DIGIT_NO_SYMBOL;
static uint8_t digit_candidate_count = 0U;
static uint8_t digit_invalid_count = 0U;
static uint8_t digit_run_active = 0U;
static uint8_t digit_run_bits = DIGIT_NO_SYMBOL;
static uint32_t digit_last_accept_ms = 0U;
static MessageRxState msg_rx_state = MSG_RX_SEARCH;
static uint8_t msg_preamble_index = 0U;
static uint32_t msg_start_entry_tick = 0U;
static float msg_preamble_energy[FSK_DATA_FREQ_COUNT];
static float msg_preamble_raw_top1[FSK_DATA_FREQ_COUNT];
static float msg_preamble_raw_top2[FSK_DATA_FREQ_COUNT];
static uint8_t msg_preamble_raw_count[FSK_DATA_FREQ_COUNT];
static uint32_t msg_preamble_raw_last_tick[FSK_DATA_FREQ_COUNT];
static uint8_t msg_preamble_capture_active = 0U;
static uint8_t msg_preamble_capture_stage = 0U;
static uint8_t msg_preamble_recovery_active = 0U;
static uint32_t msg_preamble_recovery_tick = 0U;
static float msg_preamble_recovery_energy[FSK_DATA_FREQ_COUNT];
static float msg_preamble_recovery_start_energy[MSG_START_LEN];
static uint8_t msg_preamble_recovery_start_bits[MSG_START_LEN];
static uint8_t local_node_id = 0U;
static uint8_t tx_destination_id = 0U;
static uint8_t msg_rx_source_id = 0U;
static uint8_t msg_rx_destination_id = 0U;
static uint8_t msg_rs_symbol_index = 0U;
static uint8_t msg_rs_fsk_index = 0U;
static uint8_t msg_rs_symbol = 0U;
static uint8_t msg_rs_codeword[RS_TOTAL_CODEWORD_SYMBOLS];
static uint8_t msg_rs_codeword_erased[RS_TOTAL_CODEWORD_SYMBOLS];
static float msg_rs_codeword_reliability[RS_TOTAL_CODEWORD_SYMBOLS];
static uint8_t msg_rs_current_erased = 0U;
static float msg_rs_current_reliability = RS_VOTE_RATIO_CAP;
static uint8_t msg_rs_erasure_count = 0U;
static uint8_t msg_soft_fallback_count = 0U;
static uint8_t msg_vote_override_count = 0U;
static uint32_t msg_marker_tick = 0U;
static uint8_t msg_capture_bits[RS_FSK_SYMBOLS_PER_SYMBOL];
static uint8_t msg_capture_valid[RS_FSK_SYMBOLS_PER_SYMBOL];
static uint8_t msg_capture_distance[RS_FSK_SYMBOLS_PER_SYMBOL];
static float msg_capture_scores[RS_FSK_SYMBOLS_PER_SYMBOL][4];
static float msg_capture_best_ratio[RS_FSK_SYMBOLS_PER_SYMBOL][FSK_DATA_FREQ_COUNT];
static float msg_capture_best_energy[RS_FSK_SYMBOLS_PER_SYMBOL][FSK_DATA_FREQ_COUNT][FSK_DATA_FREQ_COUNT];
static uint8_t msg_soft_bits[RS_FSK_SYMBOLS_PER_SYMBOL];
static uint8_t msg_soft_valid[RS_FSK_SYMBOLS_PER_SYMBOL];
static float msg_soft_score[RS_FSK_SYMBOLS_PER_SYMBOL];
static float msg_soft_ratio[RS_FSK_SYMBOLS_PER_SYMBOL];
static float msg_soft_energy[RS_FSK_SYMBOLS_PER_SYMBOL][FSK_DATA_FREQ_COUNT];
static RxDecisionDiagnostic msg_worst_decisions[RX_DIAG_WORST_COUNT];
static uint8_t msg_worst_decision_count = 0U;
static uint8_t msg_low_confidence_count = 0U;
static uint32_t msg_frame_tick = 0U;
static char rx_message[MESSAGE_MAX_LEN + 1U];
static uint8_t rx_message_len = 0U;
static uint8_t rx_message_valid = 0U;
static uint8_t rx_rs_corrected = 0U;
static uint8_t rx_message_source_id = 0U;
static uint8_t rx_message_destination_id = 0U;
static uint32_t rx_display_seq = 0U;
static uint32_t uart_symbol_seq = 0U;

static StoredMessage message_store_cache[MESSAGE_STORE_VISIBLE_COUNT];
static uint8_t message_store_count = 0U;
static uint8_t message_store_view_index = 0U;
static uint32_t message_store_next_sequence = 1U;
static uint32_t message_store_write_address = MESSAGE_STORE_FLASH_START;
static uint8_t message_store_pending = 0U;
static uint8_t message_store_pending_len = 0U;
static uint8_t message_store_pending_source = 0U;
static uint8_t message_store_pending_destination = 0U;
static char message_store_pending_text[MESSAGE_MAX_LEN + 1U];
static uint8_t message_store_last_save_failed = 0U;

static uint8_t rx_complete_led_active = 0U;
static uint32_t rx_complete_led_off_tick = 0U;

static uint8_t rs_gf_exp[RS_FIELD_ORDER * 2U];
static uint8_t rs_gf_log[RS_FIELD_ORDER + 1U];
static uint8_t rs_generator[RS_PARITY_SYMBOLS + 1U];

static const uint8_t tx_sine_table[TX_SINE_TABLE_SIZE] = {
  128, 140, 152, 165, 176, 188, 198, 208,
  218, 226, 234, 240, 245, 250, 253, 255,
  255, 255, 253, 250, 245, 240, 234, 226,
  218, 208, 198, 188, 176, 165, 152, 140,
  128, 115, 103,  90,  79,  67,  57,  47,
   37,  29,  21,  15,  10,   5,   2,   0,
    0,   0,   2,   5,  10,  15,  21,  29,
   37,  47,  57,  67,  79,  90, 103, 115
};
#if FSK_HIGH_PROFILE_ENABLE != 0U
static const uint8_t tx_normal_fsk_amp[FSK_FREQ_COUNT] = {
  30U,
  72U,
  TX_MAX_SINE_AMP,
  TX_MAX_SINE_AMP,
  60U
};
static const uint8_t tx_high_fsk_amp[FSK_FREQ_COUNT] = {
  TX_HIGH_PROFILE_AMP,
  TX_HIGH_PROFILE_AMP,
  TX_HIGH_PROFILE_AMP,
  TX_HIGH_PROFILE_AMP,
  TX_HIGH_PROFILE_AMP
};
#endif
static uint8_t tx_fsk_amp[FSK_FREQ_COUNT] = {
  30U,
  72U,
  TX_MAX_SINE_AMP,
  TX_MAX_SINE_AMP,
  60U
};
static const uint8_t tx_preamble_symbols[MSG_PREAMBLE_LEN] = {0x00U, 0x01U, 0x02U, 0x03U};
static const uint8_t tx_end_symbols[MSG_END_LEN] = {0x02U, 0x03U};

static volatile TX_Mode tx_mode = TX_MODE_IDLE;
static AppMode app_mode = APP_MODE_RX;
static CommunicationMode communication_mode = COMM_MODE_UNSELECTED;
static volatile TX_FramePart tx_frame_part = TX_FRAME_TONE;
static volatile uint32_t tx_phase = 0U;
static volatile uint32_t tx_phase_inc = 0U;
static volatile uint32_t tx_part_sample_count = 0U;
static volatile uint8_t tx_current_amp = 50U;
static volatile uint8_t tx_current_bits = 0U;
static volatile uint16_t tx_frame_index = 0U;
static volatile uint16_t tx_frame_len = 0U;
static volatile uint8_t tx_done_pending = 0U;
static volatile uint8_t tx_done_is_calibration = 0U;
static volatile uint8_t tx_calibration_stage = 0U;
static volatile uint8_t tx_calibration_pass = 0U;
static volatile uint8_t tx_calibration_boundary_active = 0U;
static volatile uint32_t tx_calibration_stage_sample_count = 0U;
static volatile uint8_t tx_calibration_sent = 0U;
static uint8_t tx_frame_symbols[TX_FRAME_MAX_SYMBOLS];
static uint8_t tx_last_valid = 0U;
static char tx_last_message[MESSAGE_MAX_LEN + 1U];
static uint8_t tx_last_len = 0U;
static uint8_t tx_display_sending = 0U;
static volatile uint8_t rx_sampling_active = 0U;
static uint8_t rx_resume_pending = 0U;
static uint32_t rx_resume_tick = 0U;

static char tx_text[MESSAGE_MAX_LEN + 1U];
static uint8_t tx_text_len = 0U;
static uint8_t tx_cursor_pos = 0U;
static uint8_t pending_active = 0U;
static char pending_key = 0;
static uint8_t pending_index = 0U;
static uint32_t pending_last_tick = 0U;

static uint8_t keypad_last_raw = KEY_NONE;
static uint8_t keypad_stable_key = KEY_NONE;
static uint8_t keypad_debounce_count = 0U;
static uint32_t keypad_last_scan_ms = 0U;
static uint32_t keypad_press_start_ms = 0U;
static uint8_t keypad_defer_short_press = 0U;
static uint8_t keypad_long_press_handled = 0U;

static GPIO_TypeDef *const keypad_row_ports[KEYPAD_ROWS] = {GPIOB, GPIOB, GPIOB, GPIOD};
static const uint16_t keypad_row_pins[KEYPAD_ROWS] = {GPIO_PIN_5, GPIO_PIN_4, GPIO_PIN_3, GPIO_PIN_2};
static GPIO_TypeDef *const keypad_col_ports[KEYPAD_COLS] = {GPIOA, GPIOC, GPIOC, GPIOC};
static const uint16_t keypad_col_pins[KEYPAD_COLS] = {GPIO_PIN_15, GPIO_PIN_10, GPIO_PIN_11, GPIO_PIN_12};
static const uint8_t keypad_map[KEYPAD_ROWS][KEYPAD_COLS] = {
  {'1', '2', '3', 'A'},
  {'4', '5', '6', 'B'},
  {'7', '8', '9', 'C'},
  {'*', '0', '#', 'D'}
};
/* USER CODE END PV */

void SystemClock_Config(void);
static void MX_GPIO_Init(void);
static void MX_DMA_Init(void);
static void MX_ADC1_Init(void);
static void MX_I2C3_Init(void);
static void MX_SPI1_Init(void);
static void MX_TIM2_Init(void);
static void MX_TIM3_Init(void);
static void MX_USART2_UART_Init(void);
/* USER CODE BEGIN PFP */
static void FSK_Init(void);
#if FSK_HIGH_PROFILE_ENABLE != 0U
static void FSK_ApplyProfile(uint8_t high_profile);
#endif
static void FSK_UpdateGoertzelCoefficient(uint8_t index);
static float FSK_WindowMean(const uint16_t *samples, uint16_t len);
static float Goertzel_EnergyWithMean(const uint16_t *samples, uint16_t len, float coeff, float mean);
static FSK_DetectResult FSK_DetectSymbol(const uint16_t *samples, uint16_t len);
static void FSK_ProcessSymbol(const uint16_t *samples);
static void Calibration_ResetProgress(void);
static void Calibration_StartVerificationPass(uint32_t now);
static void Calibration_Apply(void);
static void Calibration_ProcessBlock(const uint16_t *samples,
                                     const FSK_DetectResult *result,
                                     uint32_t now);
static const char *FSK_BitsToString(uint8_t bits);
static void MessageRx_Process(const FSK_DetectResult *result, uint32_t now);
static void MessageRx_AcceptSymbol(const FSK_DetectResult *result, uint32_t now);
static void MessageRx_ResetPreambleCapture(void);
static void MessageRx_AddPreambleRawWindow(uint8_t index,
                                           const FSK_DetectResult *result,
                                           uint32_t now);
static void MessageRx_CapturePreambleHardWindow(const FSK_DetectResult *result,
                                                 uint32_t now);
static void MessageRx_RestoreCalibrationEnergyScale(void);
static void MessageRx_ApplyPreambleFrameScale(void);
static void MessageRx_CaptureTimedPreamble(const FSK_DetectResult *result, uint32_t now);
static uint8_t MessageRx_TryTimedPreambleRecovery(uint32_t now);
static uint8_t MessageRx_DataWindowPosition(uint32_t now, uint8_t *slot,
                                             uint8_t *distance);
static uint8_t MessageRx_CaptureDataWindow(const FSK_DetectResult *result, uint32_t now);
static uint8_t MessageRx_SelectSoftDataCandidate(const FSK_DetectResult *result,
                                                  uint8_t *bits, float *max_energy,
                                                  float *second_energy, float *confidence);
static void MessageRx_CaptureSoftDataWindow(const FSK_DetectResult *result, uint32_t now);
static uint8_t MessageRx_TrySoftEnd1(const FSK_DetectResult *result, uint32_t now);
static void MessageRx_AppendRsBits(uint8_t decoded_bits, uint8_t erased,
                                   float confidence);
static void MessageRx_RecordDecision(uint16_t fsk_index, uint8_t source,
                                     uint8_t selected_bits, float confidence,
                                     const float *energy);
static void MessageRx_PrintDecisionDiagnostics(void);
static void MessageRx_ClearCapture(void);
static void MessageRx_FinalizeCapture(void);
static void MessageRx_ResetFrame(void);
static const char *MessageRx_StateName(MessageRxState state);
static void MessageRx_PrintSymbol(const FSK_DetectResult *result, uint32_t now);
static uint8_t Message_WhiteningMask(uint16_t fsk_symbol_index);
static uint8_t Node_SourceBitsFromId(uint8_t node_id);
static uint8_t Node_IdFromSourceBits(uint8_t bits);
static const char *Node_DestinationLabel(uint8_t destination);
static void Node_SetLocalId(uint8_t node_id);
static void Node_CycleDestination(void);
static uint8_t Message_CharToCode(char ch);
static char Message_CodeToChar(uint8_t code);
static uint16_t Message_Crc12Symbols(const uint8_t *symbols, uint8_t count);
static uint16_t Message_Crc12Addressed(uint8_t source, uint8_t destination,
                                      const uint8_t *symbols, uint8_t count);
static uint8_t Message_CrcSelfTest(void);
static MessagePayloadStatus Message_ValidateRsPayload(const uint8_t *codewords,
                                                       uint8_t source,
                                                       uint8_t destination,
                                                       char *text,
                                                       uint8_t *text_len,
                                                       uint16_t *received_crc,
                                                       uint16_t *calculated_crc,
                                                       uint8_t *failure_index,
                                                       uint8_t *failure_code);
static uint32_t MessageStore_HashRecord(const MessageStoreRecord *record);
static uint8_t MessageStore_RecordLength(const MessageStoreRecord *record);
static uint8_t MessageStore_RecordSource(const MessageStoreRecord *record);
static uint8_t MessageStore_RecordDestination(const MessageStoreRecord *record);
static uint8_t MessageStore_RecordIsErased(uint32_t address);
static uint8_t MessageStore_RecordValid(const MessageStoreRecord *record);
static void MessageStore_CacheAppend(uint32_t sequence, const char *text, uint8_t len,
                                     uint8_t source, uint8_t destination);
static void MessageStore_BuildRecord(MessageStoreRecord *record, uint32_t sequence,
                                     const char *text, uint8_t len,
                                     uint8_t source, uint8_t destination);
static uint8_t MessageStore_ProgramRecordUnlocked(uint32_t address,
                                                  const MessageStoreRecord *record);
static uint8_t MessageStore_CompactUnlocked(void);
static void MessageStore_Init(void);
static uint8_t MessageStore_Save(const char *text, uint8_t len,
                                 uint8_t source, uint8_t destination);
static void MessageStore_Task(void);
static void MessageStore_HandleRxKey(char key);
static void RS_Init(void);
static uint8_t RS_GfMul(uint8_t a, uint8_t b);
static uint8_t RS_GfDiv(uint8_t a, uint8_t b);
static uint8_t RS_PolyEvalAscending(const uint8_t *poly, uint8_t degree, uint8_t x);
static void RS_CalculateSyndromes(const uint8_t *codeword, uint8_t *syndromes);
static void RS_Encode(const uint8_t *data, uint8_t *codeword);
static int8_t RS_Decode(uint8_t *codeword, const uint8_t *erasure_positions,
                        uint8_t erasure_count, uint8_t *corrected_count);
static int8_t RS_DecodeAdaptive(uint8_t *codeword,
                                const uint8_t *erased_flags,
                                const float *reliability,
                                uint8_t *corrected_count,
                                uint8_t *used_erasure_count,
                                uint8_t *adaptive_erasure_count);
static int8_t RS_DecodeAdaptiveAttempt(const uint8_t *received,
                                       const uint8_t *erased_flags,
                                       const float *reliability,
                                       uint8_t adaptive_erasure_count,
                                       uint8_t *decoded,
                                       uint8_t *corrected_count,
                                       uint8_t *used_erasure_count);
static uint8_t RS_SelfTest(void);
static uint8_t OLED_Init(void);
static void OLED_Clear(void);
static void OLED_ClearLine(uint8_t page);
static void OLED_WriteCommand(uint8_t command);
static void OLED_WriteData(const uint8_t *data, uint16_t len);
static void OLED_SetCursor(uint8_t col, uint8_t page);
static void OLED_PrintAt(uint8_t col, uint8_t page, const char *text);
static void OLED_PrintLine(uint8_t page, const char *text);
static void OLED_PrintChar(char ch);
static const uint8_t *OLED_Font5x7(char ch);
static void OLED_ShowStartupScreen(void);
static void OLED_PrintDetected(const FSK_DetectResult *result);
static void OLED_PrintMode(void);
static void OLED_PrintTextRows(const char *text, uint8_t len);
static void OLED_PrintRxStatus(void);
static void OLED_PrintTxStatus(void);
static void TX_StartCalibration(void);
static void TX_StartMessage(void);
static void TX_Stop(void);
static void TX_AudioTick(void);
static void TX_LoadFrameSymbol(uint16_t index);
static void TX_LoadCalibrationTone(uint8_t stage);
static void TX_LoadCalibrationBoundaryTone(void);
static void TX_BuildMessageFrame(void);
static uint32_t TX_PhaseIncFromFreq(uint16_t freq_hz);
static uint8_t TX_ScaledSineSample(void);
static void SPI1_Write16(GPIO_TypeDef *cs_port, uint16_t cs_pin, uint16_t word);
static void DAC_Write12(uint16_t code);
static void DAC_WriteSample8(uint8_t sample);
static void PGA_SetGain(uint8_t gain_code);
static uint8_t PGA_IsCalibrationToneQualified(const FSK_DetectResult *result);
static uint8_t PGA_AutoGainControl(const FSK_DetectResult *result, uint32_t now);
static uint8_t PGA_ManualAdjust(int8_t direction);
static const char *PGA_AdcQuality(void);
static void TX_UI_Task(void);
static uint8_t RX_StartSampling(void);
static void RX_StopSampling(void);
static void RX_ResetDetector(void);
static void HalfDuplex_Task(void);
static void App_ToggleMode(void);
static void CommunicationMode_Select(CommunicationMode mode);
static void Editor_Task(void);
static void Editor_ProcessKey(char key);
static const char *Editor_KeyGroup(char key);
static uint8_t Editor_KeyGroupLen(const char *group);
static char Editor_PendingChar(void);
static void Editor_ConfirmPending(void);
static void Editor_ClearPending(void);
static void Editor_Insert(char ch);
static void Editor_Delete(void);
static void Keypad_Task(void);
static uint8_t Keypad_ScanRaw(void);
static void Keypad_HandlePress(uint8_t key);
static void Keypad_HandleLongPress(uint8_t key);
static void StatusLed_Update(void);
static void StatusLed_NotifyRxComplete(void);
static void PowerKill_EarlyKeepAlive(void);
static void PowerInt_Task(void);
static void App_PowerOff(void);
static void OLED_RetryInitTask(void);
/* USER CODE END PFP */

/* USER CODE BEGIN 0 */
static void PowerKill_EarlyKeepAlive(void)
{
  /* Keep LTC2950 KILL high as soon as possible, before HAL/system init. */
  RCC->AHB1ENR |= RCC_AHB1ENR_GPIOCEN;
  __DSB();

  GPIOC->BSRR = POWER_KILL_Pin;
  GPIOC->MODER = (GPIOC->MODER & ~(3UL << (1U * 2U))) | (1UL << (1U * 2U));
  GPIOC->OTYPER &= ~POWER_KILL_Pin;
  GPIOC->OSPEEDR &= ~(3UL << (1U * 2U));
  GPIOC->PUPDR &= ~(3UL << (1U * 2U));
  GPIOC->BSRR = POWER_KILL_Pin;
}

static void PowerInt_Task(void)
{
  static uint8_t poweroff_started = 0U;

  if ((poweroff_started == 0U) &&
      (HAL_GPIO_ReadPin(POWER_INT_GPIO_Port, POWER_INT_Pin) == POWER_INT_ASSERTED))
  {
    poweroff_started = 1U;
    App_PowerOff();
  }
}

static void App_PowerOff(void)
{
  printf("power INT# asserted: stopping, PC1/KILL low\r\n");

  TX_Stop();
  HAL_GPIO_WritePin(AMP_MUTE_GPIO_Port, AMP_MUTE_Pin, AMP_MUTE_ON);
  HAL_GPIO_WritePin(BOARD_LED_GPIO_Port, BOARD_LED_Pin, BOARD_LED_OFF);

  OLED_WriteCommand(0xAEU);

  HAL_GPIO_WritePin(POWER_KILL_GPIO_Port, POWER_KILL_Pin, POWER_KILL_POWER_OFF);

  while (1)
  {
    HAL_GPIO_WritePin(POWER_KILL_GPIO_Port, POWER_KILL_Pin, POWER_KILL_POWER_OFF);
  }
}

static void OLED_RetryInitTask(void)
{
  static uint32_t last_try_ms = 0U;
  uint32_t now = HAL_GetTick();

  if (oled_ready != 0U)
  {
    return;
  }

  if ((now - last_try_ms) < 500U)
  {
    return;
  }
  last_try_ms = now;

  if (OLED_Init() != 0U)
  {
    OLED_PrintMode();
  }
}

static void FSK_Init(void)
{
  Calibration_ResetProgress();
}

#if FSK_HIGH_PROFILE_ENABLE != 0U
static void FSK_ApplyProfile(uint8_t high_profile)
{
  const uint16_t *profile_freqs;
  const uint8_t *profile_amps;
  uint32_t tim2_period;

  fsk_high_profile_enabled = (high_profile != 0U) ? 1U : 0U;
  profile_freqs = (fsk_high_profile_enabled != 0U) ? fsk_high_freqs_hz : fsk_normal_freqs_hz;
  profile_amps = (fsk_high_profile_enabled != 0U) ? tx_high_fsk_amp : tx_normal_fsk_amp;
  fsk_sample_rate_hz = (fsk_high_profile_enabled != 0U) ? FSK_HIDDEN_FS_HZ : FSK_NORMAL_FS_HZ;
  fsk_symbol_samples = (fsk_high_profile_enabled != 0U) ?
                       FSK_HIDDEN_SYMBOL_SAMPLES : FSK_NORMAL_SYMBOL_SAMPLES;

  /* Mode selection happens before RX starts, so TIM2 and DMA can be sized as
     one complete 20 ms detector window per half-buffer. */
  tim2_period = TIM2_COUNTER_CLOCK_HZ / fsk_sample_rate_hz;
  htim2.Init.Period = tim2_period - 1U;
  __HAL_TIM_SET_AUTORELOAD(&htim2, htim2.Init.Period);
  __HAL_TIM_SET_COUNTER(&htim2, 0U);
  htim2.Instance->EGR = TIM_EGR_UG;
  __HAL_TIM_CLEAR_FLAG(&htim2, TIM_FLAG_UPDATE);

  for (uint8_t i = 0U; i < FSK_FREQ_COUNT; i++)
  {
    fsk_tx_freqs_hz[i] = profile_freqs[i];
    tx_fsk_amp[i] = profile_amps[i];
  }

  printf("FSK profile selected: %s, data=%u/%u/%u/%uHz sync=%uHz amp=%u/%u/%u/%u/%u ADC=%luHz/%u samples\r\n",
         (fsk_high_profile_enabled != 0U) ? "HIGH" : "NORMAL",
         fsk_tx_freqs_hz[0], fsk_tx_freqs_hz[1], fsk_tx_freqs_hz[2], fsk_tx_freqs_hz[3],
         fsk_tx_freqs_hz[FSK_SYNC_SYMBOL],
         tx_fsk_amp[0], tx_fsk_amp[1], tx_fsk_amp[2], tx_fsk_amp[3],
         tx_fsk_amp[FSK_SYNC_SYMBOL],
         (unsigned long)fsk_sample_rate_hz, fsk_symbol_samples);
}
#endif

static void FSK_UpdateGoertzelCoefficient(uint8_t index)
{
  if (index >= FSK_FREQ_COUNT)
  {
    return;
  }

  fsk_goertzel_coeffs[index] =
      2.0f * cosf((2.0f * FSK_PI * (float)fsk_rx_freqs_hz[index]) /
                  (float)fsk_sample_rate_hz);
}

static void Calibration_ResetProgress(void)
{
  calibration_energy_sum = 0.0f;
  calibration_energy_windows = 0U;
  calibration_lost_windows = 0U;
  calibration_stage = 0U;
  calibration_stable_windows = 0U;
  calibration_capture_active = 0U;
  calibration_complete = (communication_mode == COMM_MODE_MULTI_NODE) ? 1U : 0U;
  calibration_failed = 0U;
  calibration_progress_tick = HAL_GetTick();
  calibration_pass = 0U;
  calibration_coarse_activity = 0U;
  calibration_boundary_windows = 0U;
  calibration_coarse_last_signal_tick = 0U;
  calibration_adc_min_seen = 0xFFFFU;
  calibration_adc_max_seen = 0U;
  calibration_adc_mean_last = 2048U;
  rx_pga_agc_last_adjust_tick = 0U;
  rx_pga_agc_high_windows = 0U;
  rx_pga_agc_clip_windows = 0U;
  rx_pga_agc_low_windows = 0U;
  rx_pga_gain_code = (communication_mode == COMM_MODE_MULTI_NODE) ?
                     RX_PGA_MULTI_GAIN_CODE : RX_PGA_DEFAULT_GAIN_CODE;
  PGA_SetGain(rx_pga_gain_code);
  memset(calibration_energy, 0, sizeof(calibration_energy));
  MessageRx_ResetPreambleCapture();

  for (uint8_t i = 0U; i < FSK_FREQ_COUNT; i++)
  {
    fsk_rx_freqs_hz[i] = fsk_tx_freqs_hz[i];
    fsk_energy_scale[i] = 1.0f;
    if (i < FSK_DATA_FREQ_COUNT)
    {
      calibration_energy_scale[i] = 1.0f;
    }
    fsk_noise_floor[i] = FSK_NOISE_MIN_FLOOR;
    FSK_UpdateGoertzelCoefficient(i);
  }
}

static void Calibration_StartVerificationPass(uint32_t now)
{
  calibration_pass = 1U;
  calibration_energy_sum = 0.0f;
  calibration_energy_windows = 0U;
  calibration_lost_windows = 0U;
  calibration_stage = 0U;
  calibration_stable_windows = 0U;
  calibration_capture_active = 0U;
  calibration_progress_tick = now;
  calibration_coarse_activity = 0U;
  calibration_boundary_windows = 0U;
  calibration_coarse_last_signal_tick = 0U;
  calibration_adc_min_seen = 0xFFFFU;
  calibration_adc_max_seen = 0U;
  calibration_adc_mean_last = 2048U;
  rx_pga_agc_high_windows = 0U;
  rx_pga_agc_clip_windows = 0U;
  rx_pga_agc_low_windows = 0U;
  memset(calibration_energy, 0, sizeof(calibration_energy));
  for (uint8_t i = 0U; i < FSK_FREQ_COUNT; i++)
  {
    fsk_noise_floor[i] = FSK_NOISE_MIN_FLOOR;
  }
  RX_ResetDetector();
  printf("calibration pass 1/2 AGC up/down complete: pass 2/2 verify with automatic down-only, PGA=x%u\r\n",
         rx_pga_gain_values[rx_pga_gain_code]);
  OLED_PrintRxStatus();
}

static float FSK_WindowMean(const uint16_t *samples, uint16_t len)
{
  uint32_t sum = 0U;

  for (uint16_t i = 0U; i < len; i++)
  {
    sum += samples[i];
  }

  return (float)sum / (float)len;
}

static float Goertzel_EnergyWithMean(const uint16_t *samples, uint16_t len, float coeff, float mean)
{
  float s0 = 0.0f;
  float s1 = 0.0f;
  float s2 = 0.0f;

  for (uint16_t i = 0U; i < len; i++)
  {
    float x = (float)samples[i] - mean;
    s0 = x + coeff * s1 - s2;
    s2 = s1;
    s1 = s0;
  }

  return (s1 * s1) + (s2 * s2) - (coeff * s1 * s2);
}

static void Calibration_Apply(void)
{
  float reference_energy = calibration_energy[0];

  if ((calibration_adc_min_seen <= RX_PGA_ADC_CLIP_MARGIN) ||
      (calibration_adc_max_seen >= (4095U - RX_PGA_ADC_CLIP_MARGIN)))
  {
    calibration_capture_active = 0U;
    calibration_complete = 0U;
    calibration_failed = 1U;
    printf("calibration failed: pass 2 ADC CLIP at PGA x%u min=%u max=%u; retry farther away or reduce analog gain\r\n",
           rx_pga_gain_values[rx_pga_gain_code],
           calibration_adc_min_seen, calibration_adc_max_seen);
    OLED_PrintRxStatus();
    return;
  }

  for (uint8_t i = 1U; i < FSK_DATA_FREQ_COUNT; i++)
  {
    if (calibration_energy[i] < reference_energy)
    {
      reference_energy = calibration_energy[i];
    }
  }
  if (reference_energy <= 0.0f)
  {
    printf("calibration apply failed: invalid reference energy\r\n");
    Calibration_ResetProgress();
    return;
  }

  for (uint8_t i = 0U; i < FSK_DATA_FREQ_COUNT; i++)
  {
    float scale = reference_energy / calibration_energy[i];

    if (scale < CALIBRATION_SCALE_MIN)
    {
      scale = CALIBRATION_SCALE_MIN;
    }

    fsk_rx_freqs_hz[i] = fsk_tx_freqs_hz[i];
    fsk_energy_scale[i] = scale;
    calibration_energy_scale[i] = scale;
    fsk_noise_floor[i] = FSK_NOISE_MIN_FLOOR;
    FSK_UpdateGoertzelCoefficient(i);
  }

  fsk_rx_freqs_hz[FSK_DATA_FREQ_COUNT] = fsk_tx_freqs_hz[FSK_DATA_FREQ_COUNT];
  fsk_energy_scale[FSK_DATA_FREQ_COUNT] = 1.0f;
  fsk_noise_floor[FSK_DATA_FREQ_COUNT] = FSK_NOISE_MIN_FLOOR;
  FSK_UpdateGoertzelCoefficient(FSK_DATA_FREQ_COUNT);
  calibration_failed = 0U;
  calibration_complete = 1U;
  RX_ResetDetector();

  printf("calibration complete: pass 2/2 verified, MCP6S21 x%u, fixed-frequency Goertzel reference=min_mean\r\n",
         rx_pga_gain_values[rx_pga_gain_code]);
  for (uint8_t i = 0U; i < FSK_DATA_FREQ_COUNT; i++)
  {
    printf("cal %s: G=%uHz meanE/1e6=%u scale=%lu.%03lu\r\n",
           FSK_BitsToString(i),
           fsk_rx_freqs_hz[i],
           (unsigned int)(calibration_energy[i] / 1000000.0f),
           (unsigned long)((uint32_t)(fsk_energy_scale[i] * 1000.0f) / 1000U),
           (unsigned long)((uint32_t)(fsk_energy_scale[i] * 1000.0f) % 1000U));
  }
  OLED_PrintRxStatus();
}

static void Calibration_ProcessBlock(const uint16_t *samples,
                                     const FSK_DetectResult *result,
                                     uint32_t now)
{
  uint8_t calibration_tone_qualified;

  (void)samples;

  if ((communication_mode != COMM_MODE_STANDARD) &&
      (communication_mode != COMM_MODE_HIDDEN))
  {
    return;
  }

  if ((calibration_complete != 0U) || (calibration_failed != 0U))
  {
    return;
  }

  calibration_tone_qualified = PGA_IsCalibrationToneQualified(result);
  if (PGA_AutoGainControl(result, now) != 0U)
  {
    return;
  }
  if ((calibration_tone_qualified != 0U) &&
      (result->adc_min > RX_PGA_ADC_CLIP_MARGIN) &&
      (result->adc_max < (4095U - RX_PGA_ADC_CLIP_MARGIN)))
  {
    calibration_adc_mean_last = (uint16_t)result->adc_mean;
    if (result->adc_min < calibration_adc_min_seen)
    {
      calibration_adc_min_seen = result->adc_min;
    }
    if (result->adc_max > calibration_adc_max_seen)
    {
      calibration_adc_max_seen = result->adc_max;
    }
  }

  if (calibration_pass == 0U)
  {
    if ((result->valid != 0U) && (result->bits == FSK_SYNC_SYMBOL))
    {
      if (calibration_boundary_windows < CALIBRATION_BOUNDARY_STABLE_WINDOWS)
      {
        calibration_boundary_windows++;
      }
      if (calibration_boundary_windows >= CALIBRATION_BOUNDARY_STABLE_WINDOWS)
      {
        printf("calibration interpass boundary: 2000Hz SYNC accepted after %u windows\r\n",
               CALIBRATION_BOUNDARY_STABLE_WINDOWS);
        Calibration_StartVerificationPass(now);
      }
      return;
    }

    calibration_boundary_windows = 0U;
    if ((result->valid != 0U) && (result->bits < FSK_DATA_FREQ_COUNT))
    {
      calibration_coarse_activity = 1U;
      calibration_coarse_last_signal_tick = now;
    }
    else if ((calibration_coarse_activity != 0U) &&
             ((now - calibration_coarse_last_signal_tick) >= CALIBRATION_GAP_DETECT_MS))
    {
      Calibration_StartVerificationPass(now);
    }
    return;
  }

  if ((calibration_stage > 0U) &&
      ((now - calibration_progress_tick) > CALIBRATION_PROGRESS_TIMEOUT_MS))
  {
    printf("calibration timeout after %u/4 tones, restart at 00\r\n", calibration_stage);
    Calibration_ResetProgress();
  }

  if (calibration_capture_active != 0U)
  {
    if ((result->valid == 0U) || (result->bits != calibration_stage))
    {
      if (calibration_lost_windows < 255U)
      {
        calibration_lost_windows++;
      }
      if (calibration_lost_windows >= CALIBRATION_LOST_WINDOWS_MAX)
      {
        calibration_capture_active = 0U;
        calibration_energy_sum = 0.0f;
        calibration_energy_windows = 0U;
        calibration_lost_windows = 0U;
        calibration_stable_windows = 0U;
        printf("calibration G tone %u lost, retry current tone\r\n",
               calibration_stage + 1U);
      }
      return;
    }

    calibration_lost_windows = 0U;
    calibration_energy_sum += result->data_energy[calibration_stage];
    calibration_energy_windows++;

    if (calibration_energy_windows >= CALIBRATION_ENERGY_WINDOWS)
    {
      calibration_capture_active = 0U;
      calibration_stable_windows = 0U;
      calibration_energy[calibration_stage] =
          calibration_energy_sum / (float)calibration_energy_windows;
      printf("calibration G %s: freq=%uHz windows=%u meanE/1e6=%u\r\n",
             FSK_BitsToString(calibration_stage),
             fsk_tx_freqs_hz[calibration_stage],
             calibration_energy_windows,
             (unsigned int)(calibration_energy[calibration_stage] / 1000000.0f));
      calibration_energy_sum = 0.0f;
      calibration_energy_windows = 0U;
      calibration_lost_windows = 0U;
      calibration_stage++;
      calibration_progress_tick = now;
      if (calibration_stage >= FSK_DATA_FREQ_COUNT)
      {
        Calibration_Apply();
      }
    }
    return;
  }

  if ((result->valid != 0U) && (result->bits == calibration_stage))
  {
    if (calibration_stable_windows < CALIBRATION_STABLE_WINDOWS)
    {
      calibration_stable_windows++;
    }
    if (calibration_stable_windows >= CALIBRATION_STABLE_WINDOWS)
    {
      calibration_capture_active = 1U;
      calibration_energy_sum = 0.0f;
      calibration_energy_windows = 0U;
      calibration_lost_windows = 0U;
      calibration_stable_windows = 0U;
      printf("calibration G capture %s: freq=%uHz windows=%u\r\n",
             FSK_BitsToString(calibration_stage),
             fsk_tx_freqs_hz[calibration_stage], CALIBRATION_ENERGY_WINDOWS);
    }
  }
  else
  {
    calibration_stable_windows = 0U;
  }
}

static FSK_DetectResult FSK_DetectSymbol(const uint16_t *samples, uint16_t len)
{
  FSK_DetectResult result = {0};
  float energies[FSK_FREQ_COUNT];
  float mean = FSK_WindowMean(samples, len);
  uint16_t adc_min = 0xFFFFU;
  uint16_t adc_max = 0U;
  uint8_t max_index = 0U;
  uint8_t second_index = 1U;

  for (uint16_t i = 0U; i < len; i++)
  {
    if (samples[i] < adc_min)
    {
      adc_min = samples[i];
    }
    if (samples[i] > adc_max)
    {
      adc_max = samples[i];
    }
  }

  for (uint8_t i = 0U; i < FSK_FREQ_COUNT; i++)
  {
    energies[i] = Goertzel_EnergyWithMean(samples, len, fsk_goertzel_coeffs[i], mean) *
                  fsk_energy_scale[i];
  }
  for (uint8_t i = 0U; i < FSK_DATA_FREQ_COUNT; i++)
  {
    result.data_energy[i] = energies[i];
  }

  if (energies[second_index] > energies[max_index])
  {
    max_index = 1U;
    second_index = 0U;
  }

  for (uint8_t i = 2U; i < FSK_FREQ_COUNT; i++)
  {
    if (energies[i] > energies[max_index])
    {
      second_index = max_index;
      max_index = i;
    }
    else if (energies[i] > energies[second_index])
    {
      second_index = i;
    }
  }

  result.freq_hz = fsk_rx_freqs_hz[max_index];
  result.bits = fsk_bits[max_index];
  result.max_energy = energies[max_index];
  result.second_energy = energies[second_index];
  result.adc_mean = mean;
  result.adc_min = adc_min;
  result.adc_max = adc_max;

  for (uint8_t i = 0U; i < FSK_FREQ_COUNT; i++)
  {
    float floor = fsk_noise_floor[i];

    if (energies[i] > floor)
    {
      floor = (0.995f * floor) + (0.005f * energies[i]);
    }
    else
    {
      floor = (0.95f * floor) + (0.05f * energies[i]);
    }

    if (floor < FSK_NOISE_MIN_FLOOR)
    {
      floor = FSK_NOISE_MIN_FLOOR;
    }

    fsk_noise_floor[i] = floor;
  }

  if ((result.max_energy > FSK_ENERGY_THRESHOLD) &&
      (result.max_energy > (result.second_energy * FSK_RATIO_THRESHOLD)) &&
      (result.max_energy > (fsk_noise_floor[max_index] * FSK_NOISE_MULTIPLIER)))
  {
    result.valid = 1U;
  }

  return result;
}

static void FSK_ProcessSymbol(const uint16_t *samples)
{
  FSK_DetectResult result = FSK_DetectSymbol(samples, fsk_symbol_samples);
  static uint32_t last_idle_log = 0U;
  static uint32_t last_oled_rx_seq = 0U;
  uint32_t now = HAL_GetTick();

  if (calibration_complete == 0U)
  {
    Calibration_ProcessBlock(samples, &result, now);
  }
  else
  {
    MessageRx_Process(&result, now);
  }

#if DEBUG_UART_ENABLE
  if ((result.valid == 0U) && ((now - last_idle_log) >= UART_IDLE_LOG_MS))
  {
    last_idle_log = now;
    printf("idle: PGA=x%u, Emax=%u, E2=%u, ADC mean=%u min=%u max=%u\r\n",
           rx_pga_gain_values[rx_pga_gain_code],
           (unsigned int)result.max_energy,
           (unsigned int)result.second_energy,
           (unsigned int)result.adc_mean,
           result.adc_min,
           result.adc_max);
  }
#endif

  if (rx_display_seq != last_oled_rx_seq)
  {
    last_oled_rx_seq = rx_display_seq;
    OLED_PrintDetected(&result);
  }
}

static const char *FSK_BitsToString(uint8_t bits)
{
  if (bits == DIGIT_NO_SYMBOL)
  {
    return "--";
  }
  if (bits == FSK_SYNC_SYMBOL)
  {
    return "SYNC";
  }
  if (bits < 4U)
  {
    static const char *bit_text[4] = {"00", "01", "10", "11"};
    return bit_text[bits];
  }
  return "?";
}

static const char *MessageRx_StateName(MessageRxState state)
{
  switch (state)
  {
    case MSG_RX_SEARCH:
      return "SEARCH";
    case MSG_RX_START_0:
      return "START0";
    case MSG_RX_START_1:
      return "START1";
    case MSG_RX_RS_SYNC:
      return "RS_SYNC";
    case MSG_RX_RS_CODEWORD:
      return "RS_DATA";
    case MSG_RX_END_0:
      return "END0";
    case MSG_RX_END_1:
      return "END1";
    default:
      return "UNKNOWN";
  }
}

static void MessageRx_PrintSymbol(const FSK_DetectResult *result, uint32_t now)
{
  uint32_t ratio_x100 = 99999U;

  if (result->second_energy > 1.0f)
  {
    ratio_x100 = (uint32_t)((result->max_energy * 100.0f) / result->second_energy);
  }

  uart_symbol_seq++;
  printf("symbol #%lu: t=%lums state=%s, %uHz -> %s, Emax=%u, E2=%u, R=%lu.%02lu, N=%u, ADC mean=%u min=%u max=%u\r\n",
         (unsigned long)uart_symbol_seq,
         (unsigned long)now,
         MessageRx_StateName(msg_rx_state),
         result->freq_hz,
         FSK_BitsToString(result->bits),
         (unsigned int)result->max_energy,
         (unsigned int)result->second_energy,
         (unsigned long)(ratio_x100 / 100U),
         (unsigned long)(ratio_x100 % 100U),
         (unsigned int)fsk_noise_floor[result->bits],
         (unsigned int)result->adc_mean,
         result->adc_min,
         result->adc_max);
}

static void MessageRx_Process(const FSK_DetectResult *result, uint32_t now)
{
  uint8_t required_windows;

  if (msg_rx_state == MSG_RX_SEARCH)
  {
    MessageRx_CaptureTimedPreamble(result, now);
  }
  MessageRx_CapturePreambleHardWindow(result, now);

  if ((msg_rx_state != MSG_RX_SEARCH) && ((now - msg_frame_tick) > DIGIT_FRAME_TIMEOUT_MS))
  {
    printf("rx timeout\r\n");
    MessageRx_ResetFrame();
  }

  if (((msg_rx_state == MSG_RX_START_0) || (msg_rx_state == MSG_RX_START_1)) &&
      (msg_start_entry_tick != 0U) &&
      ((now - msg_start_entry_tick) > START_SEQUENCE_TIMEOUT_MS))
  {
    printf("rx start sequence timeout\r\n");
    MessageRx_ResetFrame();
  }

  if (msg_rx_state == MSG_RX_RS_CODEWORD)
  {
    if (result->valid == 0U)
    {
      MessageRx_CaptureSoftDataWindow(result, now);
    }
    else if (result->bits == FSK_SYNC_SYMBOL)
    {
      uint32_t marker_delta = now - msg_marker_tick;

      if (marker_delta >= (RS_MARKER_INTERVAL_MS - RS_MARKER_ACCEPT_EARLY_MS))
      {
        MessageRx_AcceptSymbol(result, now);
      }
      else
      {
        MessageRx_CaptureSoftDataWindow(result, now);
      }
    }
    else
    {
      msg_frame_tick = now;
      if (MessageRx_CaptureDataWindow(result, now) != 0U)
      {
        MessageRx_PrintSymbol(result, now);
      }
    }
    return;
  }

  if (result->valid == 0U)
  {
    if ((msg_rx_state == MSG_RX_END_1) && (MessageRx_TrySoftEnd1(result, now) != 0U))
    {
      return;
    }
    if (digit_invalid_count < 255U)
    {
      digit_invalid_count++;
    }

    if (digit_invalid_count >= DIGIT_GAP_INVALID_WINDOWS)
    {
      digit_candidate_bits = DIGIT_NO_SYMBOL;
      digit_candidate_count = 0U;
      digit_run_active = 0U;
    }

    return;
  }

  digit_invalid_count = 0U;

  if (digit_candidate_bits == result->bits)
  {
    if (digit_candidate_count < 255U)
    {
      digit_candidate_count++;
    }
  }
  else
  {
    digit_candidate_bits = result->bits;
    digit_candidate_count = 1U;
  }

  if (msg_rx_state == MSG_RX_SEARCH)
  {
    /* A 60 ms PREAMBLE tone spans only three 20 ms detector windows.  Requiring
       two consecutive hard decisions occasionally drops a whole PREAMBLE tone
       when one of those windows straddles a tone/gap transition.  The complete
       00/01/10/11 order plus the two START tones still validates frame entry. */
    required_windows = PREAMBLE_STABLE_WINDOWS;
  }
  else if ((msg_rx_state == MSG_RX_START_0) ||
           (msg_rx_state == MSG_RX_START_1))
  {
    required_windows = START_STABLE_WINDOWS;
  }
  else
  {
    required_windows = 1U;
  }
  if (digit_candidate_count < required_windows)
  {
    return;
  }

  if ((digit_run_active != 0U) &&
      (digit_run_bits == result->bits) &&
      ((now - digit_last_accept_ms) < RX_SAME_SYMBOL_REACCEPT_MS))
  {
    return;
  }

  digit_run_active = 1U;
  digit_run_bits = result->bits;
  digit_last_accept_ms = now;
  MessageRx_AcceptSymbol(result, now);
}

static void MessageRx_ResetPreambleCapture(void)
{
  memset(msg_preamble_raw_top1, 0, sizeof(msg_preamble_raw_top1));
  memset(msg_preamble_raw_top2, 0, sizeof(msg_preamble_raw_top2));
  memset(msg_preamble_raw_count, 0, sizeof(msg_preamble_raw_count));
  memset(msg_preamble_raw_last_tick, 0, sizeof(msg_preamble_raw_last_tick));
  msg_preamble_capture_active = 0U;
  msg_preamble_capture_stage = 0U;
}

static void MessageRx_AddPreambleRawWindow(uint8_t index,
                                           const FSK_DetectResult *result,
                                           uint32_t now)
{
  float raw_energy;

  if ((index >= FSK_DATA_FREQ_COUNT) || (fsk_energy_scale[index] <= 0.0f))
  {
    return;
  }
  if ((msg_preamble_raw_count[index] != 0U) &&
      (msg_preamble_raw_last_tick[index] == now))
  {
    return;
  }

  raw_energy = result->data_energy[index] / fsk_energy_scale[index];
  if (raw_energy <= 0.0f)
  {
    return;
  }

  if (raw_energy >= msg_preamble_raw_top1[index])
  {
    msg_preamble_raw_top2[index] = msg_preamble_raw_top1[index];
    msg_preamble_raw_top1[index] = raw_energy;
  }
  else if (raw_energy > msg_preamble_raw_top2[index])
  {
    msg_preamble_raw_top2[index] = raw_energy;
  }
  if (msg_preamble_raw_count[index] < 255U)
  {
    msg_preamble_raw_count[index]++;
  }
  msg_preamble_raw_last_tick[index] = now;
}

static void MessageRx_CapturePreambleHardWindow(const FSK_DetectResult *result,
                                                 uint32_t now)
{
  if ((msg_preamble_capture_active != 0U) &&
      (msg_preamble_capture_stage < FSK_DATA_FREQ_COUNT) &&
      (result->valid != 0U) &&
      (result->bits == msg_preamble_capture_stage))
  {
    MessageRx_AddPreambleRawWindow(msg_preamble_capture_stage, result, now);
  }
}

static void MessageRx_RestoreCalibrationEnergyScale(void)
{
  if (calibration_complete == 0U)
  {
    return;
  }

  for (uint8_t i = 0U; i < FSK_DATA_FREQ_COUNT; i++)
  {
    fsk_energy_scale[i] = calibration_energy_scale[i];
    fsk_noise_floor[i] = FSK_NOISE_MIN_FLOOR;
  }
  fsk_energy_scale[FSK_DATA_FREQ_COUNT] = 1.0f;
  fsk_noise_floor[FSK_DATA_FREQ_COUNT] = FSK_NOISE_MIN_FLOOR;
}

static void MessageRx_ApplyPreambleFrameScale(void)
{
  float frame_energy[FSK_DATA_FREQ_COUNT];
  float correction[FSK_DATA_FREQ_COUNT];
  float applied_scale[FSK_DATA_FREQ_COUNT];
  uint8_t energy_windows_used[FSK_DATA_FREQ_COUNT];
  uint8_t single_window_fallbacks = 0U;
  float pair_01;
  float pair_23;
  float reference_energy;
  float max_applied_scale = 0.0f;

  MessageRx_RestoreCalibrationEnergyScale();
  for (uint8_t i = 0U; i < FSK_DATA_FREQ_COUNT; i++)
  {
    if (msg_preamble_raw_count[i] == 0U)
    {
      printf("preamble frame scale skipped: %s has no hard window\r\n",
             FSK_BitsToString(i));
      return;
    }

    /* Capture stores raw (unscaled) Goertzel energy.  Prefer the mean of the
       two strongest windows.  A 60+10 ms PREAMBLE can occasionally provide
       only one hard-valid 20 ms window for 00; using that already-qualified
       window is safer than discarding all four frame measurements and falling
       back to a highly unequal startup calibration.  The existing energy,
       square-root correction and ratio guards still bound this fallback. */
    if (msg_preamble_raw_count[i] >= 2U)
    {
      frame_energy[i] =
          0.5f * (msg_preamble_raw_top1[i] + msg_preamble_raw_top2[i]) *
          calibration_energy_scale[i];
      energy_windows_used[i] = 2U;
    }
    else
    {
      frame_energy[i] = msg_preamble_raw_top1[i] * calibration_energy_scale[i];
      energy_windows_used[i] = 1U;
      single_window_fallbacks++;
    }
    if (frame_energy[i] < PREAMBLE_RECOVERY_ENERGY_MIN)
    {
      printf("preamble frame scale skipped: weak %s E/1e6=%u captured=%u used=%u\r\n",
             FSK_BitsToString(i),
             (unsigned int)(frame_energy[i] / 1000000.0f),
             (unsigned int)msg_preamble_raw_count[i],
             (unsigned int)energy_windows_used[i]);
      return;
    }
  }

  /* Correct only half of the measured imbalance (square root), then clamp
     each bin relative to the startup calibration.  The top-two mean avoids
     making the decision from one 20 ms window that may land on tone attack or
     inter-symbol ringing. */
  pair_01 = sqrtf(frame_energy[0] * frame_energy[1]);
  pair_23 = sqrtf(frame_energy[2] * frame_energy[3]);
  reference_energy = sqrtf(pair_01 * pair_23);
  if (reference_energy <= 0.0f)
  {
    printf("preamble frame scale skipped: invalid reference\r\n");
    return;
  }

  for (uint8_t i = 0U; i < FSK_DATA_FREQ_COUNT; i++)
  {
    correction[i] = sqrtf(reference_energy / frame_energy[i]);
    if (correction[i] < PREAMBLE_FRAME_SCALE_MIN_CORR)
    {
      correction[i] = PREAMBLE_FRAME_SCALE_MIN_CORR;
    }
    else if (correction[i] > PREAMBLE_FRAME_SCALE_MAX_CORR)
    {
      correction[i] = PREAMBLE_FRAME_SCALE_MAX_CORR;
    }

    applied_scale[i] = calibration_energy_scale[i] * correction[i];
  }

  /* This acoustic path can make a weak 4500 Hz PREAMBLE sample boost the
     4500 Hz bin enough to absorb following 3500 Hz symbols.  Successful
     captures stayed below about 1.8x while failed captures were 4x..13x, so
     keep the frame-local 4500/3500 ratio inside a conservative 2.5x guard. */
  if (applied_scale[3] > (applied_scale[2] * PREAMBLE_FRAME_MAX_4500_TO_3500))
  {
    uint32_t ratio_x1000 =
        (uint32_t)((applied_scale[3] * 1000.0f) / applied_scale[2]);

    applied_scale[3] = applied_scale[2] * PREAMBLE_FRAME_MAX_4500_TO_3500;
    printf("preamble 4500/3500 guard: ratio=%lu.%03lu capped=2.500\r\n",
           (unsigned long)(ratio_x1000 / 1000U),
           (unsigned long)(ratio_x1000 % 1000U));
  }

  for (uint8_t i = 0U; i < FSK_DATA_FREQ_COUNT; i++)
  {
    if (applied_scale[i] > max_applied_scale)
    {
      max_applied_scale = applied_scale[i];
    }
  }
  if (max_applied_scale <= 0.0f)
  {
    printf("preamble frame scale skipped: invalid applied scale\r\n");
    return;
  }

  printf("preamble frame scale: top2 mean + qualified top1 fallback, bounded sqrt, current frame only; top1=%u\r\n",
         (unsigned int)single_window_fallbacks);
  for (uint8_t i = 0U; i < FSK_DATA_FREQ_COUNT; i++)
  {
    uint32_t base_x1000 = (uint32_t)(calibration_energy_scale[i] * 1000.0f);
    uint32_t correction_x1000 = (uint32_t)(correction[i] * 1000.0f);
    uint32_t frame_x1000;

    applied_scale[i] /= max_applied_scale;
    if (applied_scale[i] < CALIBRATION_SCALE_MIN)
    {
      applied_scale[i] = CALIBRATION_SCALE_MIN;
    }
    fsk_energy_scale[i] = applied_scale[i];
    fsk_noise_floor[i] = FSK_NOISE_MIN_FLOOR;
    frame_x1000 = (uint32_t)(applied_scale[i] * 1000.0f);
    printf("frame %s: E/1e6=%u captured=%u used=%u base=%lu.%03lu corr=%lu.%03lu scale=%lu.%03lu\r\n",
           FSK_BitsToString(i),
           (unsigned int)(frame_energy[i] / 1000000.0f),
           (unsigned int)msg_preamble_raw_count[i],
           (unsigned int)energy_windows_used[i],
           (unsigned long)(base_x1000 / 1000U),
           (unsigned long)(base_x1000 % 1000U),
           (unsigned long)(correction_x1000 / 1000U),
           (unsigned long)(correction_x1000 % 1000U),
           (unsigned long)(frame_x1000 / 1000U),
           (unsigned long)(frame_x1000 % 1000U));
  }
}

static void MessageRx_CaptureTimedPreamble(const FSK_DetectResult *result, uint32_t now)
{
  uint32_t delta;

  if (msg_preamble_recovery_active == 0U)
  {
    return;
  }

  delta = now - msg_preamble_recovery_tick;
  if (delta > PREAMBLE_RECOVERY_MARKER_MAX_MS)
  {
    msg_preamble_recovery_active = 0U;
    return;
  }

  if (delta <= PREAMBLE_RECOVERY_01_END_MS)
  {
    MessageRx_AddPreambleRawWindow(1U, result, now);
  }

  if ((delta >= PREAMBLE_RECOVERY_10_START_MS) &&
      (delta <= PREAMBLE_RECOVERY_10_END_MS) &&
      (result->data_energy[2] > msg_preamble_recovery_energy[2]))
  {
    msg_preamble_recovery_energy[2] = result->data_energy[2];
  }
  if ((delta >= PREAMBLE_RECOVERY_10_START_MS) &&
      (delta <= PREAMBLE_RECOVERY_10_END_MS))
  {
    MessageRx_AddPreambleRawWindow(2U, result, now);
  }
  if ((delta >= PREAMBLE_RECOVERY_11_START_MS) &&
      (delta <= PREAMBLE_RECOVERY_11_END_MS) &&
      (result->data_energy[3] > msg_preamble_recovery_energy[3]))
  {
    msg_preamble_recovery_energy[3] = result->data_energy[3];
  }
  if ((delta >= PREAMBLE_RECOVERY_11_START_MS) &&
      (delta <= PREAMBLE_RECOVERY_11_END_MS))
  {
    MessageRx_AddPreambleRawWindow(3U, result, now);
  }
  if ((delta >= PREAMBLE_RECOVERY_START0_START_MS) &&
      (delta <= PREAMBLE_RECOVERY_START0_END_MS))
  {
    for (uint8_t bits = 0U; bits < 3U; bits++)
    {
      if (result->data_energy[bits] > msg_preamble_recovery_start_energy[0])
      {
        msg_preamble_recovery_start_energy[0] = result->data_energy[bits];
        msg_preamble_recovery_start_bits[0] = bits;
      }
    }
  }
  if ((delta >= PREAMBLE_RECOVERY_START1_START_MS) &&
      (delta <= PREAMBLE_RECOVERY_START1_END_MS))
  {
    for (uint8_t bits = 0U; bits < FSK_DATA_FREQ_COUNT; bits++)
    {
      if (result->data_energy[bits] > msg_preamble_recovery_start_energy[1])
      {
        msg_preamble_recovery_start_energy[1] = result->data_energy[bits];
        msg_preamble_recovery_start_bits[1] = bits;
      }
    }
  }
}

static uint8_t MessageRx_TryTimedPreambleRecovery(uint32_t now)
{
  uint32_t delta;

  if (msg_preamble_recovery_active == 0U)
  {
    return 0U;
  }

  delta = now - msg_preamble_recovery_tick;
  if ((delta < PREAMBLE_RECOVERY_MARKER_MIN_MS) ||
      (delta > PREAMBLE_RECOVERY_MARKER_MAX_MS))
  {
    return 0U;
  }

  for (uint8_t i = 0U; i < FSK_DATA_FREQ_COUNT; i++)
  {
    if (msg_preamble_recovery_energy[i] < PREAMBLE_RECOVERY_ENERGY_MIN)
    {
      printf("timed preamble recovery rejected: delta=%lums weak=%s E/1e6=%u\r\n",
             (unsigned long)delta, FSK_BitsToString(i),
             (unsigned int)(msg_preamble_recovery_energy[i] / 1000000.0f));
      msg_preamble_recovery_active = 0U;
      return 0U;
    }
  }
  for (uint8_t i = 0U; i < MSG_START_LEN; i++)
  {
    if (msg_preamble_recovery_start_energy[i] < PREAMBLE_RECOVERY_ENERGY_MIN)
    {
      printf("timed preamble recovery rejected: delta=%lums weak=start%u E/1e6=%u\r\n",
             (unsigned long)delta, i,
             (unsigned int)(msg_preamble_recovery_start_energy[i] / 1000000.0f));
      msg_preamble_recovery_active = 0U;
      return 0U;
    }
  }

  msg_rx_source_id = Node_IdFromSourceBits(msg_preamble_recovery_start_bits[0]);
  msg_rx_destination_id = msg_preamble_recovery_start_bits[1];
  if (msg_rx_source_id == 0U)
  {
    printf("timed preamble recovery rejected: invalid source bits=%s\r\n",
           FSK_BitsToString(msg_preamble_recovery_start_bits[0]));
    msg_preamble_recovery_active = 0U;
    return 0U;
  }

  memcpy(msg_preamble_energy, msg_preamble_recovery_energy, sizeof(msg_preamble_energy));
  if (msg_rx_destination_id == 0U)
  {
    printf("rx timed preamble recovery: N%u->ALL, marker delta=%lums\r\n",
           msg_rx_source_id, (unsigned long)delta);
  }
  else
  {
    printf("rx timed preamble recovery: N%u->N%u, marker delta=%lums\r\n",
           msg_rx_source_id, msg_rx_destination_id, (unsigned long)delta);
  }
  msg_preamble_capture_active = 0U;
  MessageRx_ApplyPreambleFrameScale();
  msg_preamble_recovery_active = 0U;
  msg_preamble_index = 0U;
  msg_rs_symbol_index = 0U;
  msg_rs_fsk_index = 0U;
  msg_rs_symbol = 0U;
  msg_rs_current_erased = 0U;
  msg_rs_current_reliability = RS_VOTE_RATIO_CAP;
  msg_rs_erasure_count = 0U;
  msg_soft_fallback_count = 0U;
  msg_low_confidence_count = 0U;
  msg_vote_override_count = 0U;
  msg_worst_decision_count = 0U;
  memset(msg_worst_decisions, 0, sizeof(msg_worst_decisions));
  msg_marker_tick = now;
  MessageRx_ClearCapture();
  memset(msg_rs_codeword, 0, sizeof(msg_rs_codeword));
  memset(msg_rs_codeword_erased, 0, sizeof(msg_rs_codeword_erased));
  memset(msg_rs_codeword_reliability, 0, sizeof(msg_rs_codeword_reliability));
  msg_rx_state = MSG_RX_RS_CODEWORD;
  printf("rx start recovered by timed training; receiving %ux marker-framed RS(%u,%u) blocks\r\n",
         RS_BLOCK_COUNT, RS_CODEWORD_SYMBOLS, RS_DATA_SYMBOLS);
  printf("rx marker open: RS symbol 1/%u\r\n", RS_TOTAL_CODEWORD_SYMBOLS);
  return 1U;
}

static uint8_t MessageRx_DataWindowPosition(uint32_t now, uint8_t *slot,
                                             uint8_t *distance)
{
  uint32_t delta = now - msg_marker_tick;
  uint32_t target;

  if ((slot == NULL) || (distance == NULL) ||
      (delta < RS_SLOT_CAPTURE_START_MS) ||
      (delta >= RS_SLOT_CAPTURE_END_MS))
  {
    return 0U;
  }

  if (delta < (2U * RS_SLOT_WIDTH_MS))
  {
    *slot = 0U;
  }
  else if (delta < ((3U * RS_SLOT_WIDTH_MS) - (FSK_SYMBOL_MS / 2U)))
  {
    *slot = 1U;
  }
  else
  {
    *slot = 2U;
  }

  target = (uint32_t)(*slot + 1U) * RS_SLOT_WIDTH_MS;
  *distance = (uint8_t)((delta > target) ? (delta - target) : (target - delta));
  return 1U;
}

static uint8_t MessageRx_CaptureDataWindow(const FSK_DetectResult *result, uint32_t now)
{
  uint8_t slot;
  uint8_t distance;
  float vote_ratio;
  uint8_t nearest_updated = 0U;

  if ((result->bits >= FSK_DATA_FREQ_COUNT) ||
      (MessageRx_DataWindowPosition(now, &slot, &distance) == 0U))
  {
    return 0U;
  }

  /*
   * msg_marker_tick is the first accepted 20 ms marker window, not the
   * physical marker start.  A 70 ms step shifts by half a detector window
   * on alternate tones, so the capture ranges are 40..139, 140..199 and
   * 200..259 ms.  This keeps the first valid third-tone window out of slot 1.
   */
  vote_ratio = (result->second_energy > 1.0f) ?
               (result->max_energy / result->second_energy) : RS_VOTE_RATIO_CAP;
  if (vote_ratio > RS_VOTE_RATIO_CAP)
  {
    vote_ratio = RS_VOTE_RATIO_CAP;
  }

  msg_capture_scores[slot][result->bits] += vote_ratio;
  if (vote_ratio > msg_capture_best_ratio[slot][result->bits])
  {
    msg_capture_best_ratio[slot][result->bits] = vote_ratio;
    memcpy(msg_capture_best_energy[slot][result->bits], result->data_energy,
           sizeof(msg_capture_best_energy[slot][result->bits]));
  }
  if ((msg_capture_valid[slot] == 0U) || (distance < msg_capture_distance[slot]))
  {
    msg_capture_bits[slot] = result->bits;
    msg_capture_valid[slot] = 1U;
    msg_capture_distance[slot] = distance;
    nearest_updated = 1U;
  }

  return nearest_updated;
}

static uint8_t MessageRx_SelectSoftDataCandidate(const FSK_DetectResult *result,
                                                  uint8_t *bits, float *max_energy,
                                                  float *second_energy, float *confidence)
{
  uint8_t max_index = 0U;
  uint8_t second_index = 1U;
  float ratio;
  float noise_ratio;

  if ((result == NULL) || (bits == NULL) || (max_energy == NULL) ||
      (second_energy == NULL) || (confidence == NULL))
  {
    return 0U;
  }

  if (result->data_energy[second_index] > result->data_energy[max_index])
  {
    max_index = 1U;
    second_index = 0U;
  }
  for (uint8_t i = 2U; i < FSK_DATA_FREQ_COUNT; i++)
  {
    if (result->data_energy[i] > result->data_energy[max_index])
    {
      second_index = max_index;
      max_index = i;
    }
    else if (result->data_energy[i] > result->data_energy[second_index])
    {
      second_index = i;
    }
  }

  *bits = max_index;
  *max_energy = result->data_energy[max_index];
  *second_energy = result->data_energy[second_index];
  if ((*max_energy < FSK_SOFT_ENERGY_THRESHOLD) ||
      (*max_energy < (*second_energy * FSK_SOFT_RATIO_THRESHOLD)) ||
      (*max_energy < (fsk_noise_floor[max_index] * FSK_SOFT_NOISE_MULTIPLIER)))
  {
    return 0U;
  }

  ratio = (*second_energy > 1.0f) ? (*max_energy / *second_energy) : RS_VOTE_RATIO_CAP;
  noise_ratio = *max_energy / fsk_noise_floor[max_index];
  if (ratio > RS_VOTE_RATIO_CAP)
  {
    ratio = RS_VOTE_RATIO_CAP;
  }
  if (noise_ratio > RS_VOTE_RATIO_CAP)
  {
    noise_ratio = RS_VOTE_RATIO_CAP;
  }
  *confidence = ratio * noise_ratio;
  return 1U;
}

static void MessageRx_CaptureSoftDataWindow(const FSK_DetectResult *result, uint32_t now)
{
  uint32_t delta = now - msg_marker_tick;
  uint8_t slot;
  uint8_t distance;
  uint8_t candidate_bits;
  float candidate_energy;
  float second_energy;
  float confidence;
  float time_weight;
  float score;

  if ((delta < RS_SOFT_CAPTURE_START_MS) ||
      (MessageRx_DataWindowPosition(now, &slot, &distance) == 0U))
  {
    return;
  }
  if (MessageRx_SelectSoftDataCandidate(result, &candidate_bits, &candidate_energy,
                                        &second_energy, &confidence) == 0U)
  {
    return;
  }

  time_weight = 1.0f / (1.0f + ((float)distance / (float)FSK_SYMBOL_MS));
  score = confidence * time_weight;

  if ((msg_soft_valid[slot] == 0U) || (score > msg_soft_score[slot]))
  {
    msg_soft_bits[slot] = candidate_bits;
    msg_soft_valid[slot] = 1U;
    msg_soft_score[slot] = score;
    msg_soft_ratio[slot] = (second_energy > 1.0f) ?
                           (candidate_energy / second_energy) : RS_VOTE_RATIO_CAP;
    if (msg_soft_ratio[slot] > RS_VOTE_RATIO_CAP)
    {
      msg_soft_ratio[slot] = RS_VOTE_RATIO_CAP;
    }
    memcpy(msg_soft_energy[slot], result->data_energy,
           sizeof(msg_soft_energy[slot]));
  }
}

static uint8_t MessageRx_TrySoftEnd1(const FSK_DetectResult *result, uint32_t now)
{
  uint32_t delta = now - msg_frame_tick;
  uint8_t candidate_bits;
  float candidate_energy;
  float second_energy;
  float confidence;
  FSK_DetectResult soft_result;

  if ((delta < END1_SOFT_ACCEPT_MIN_MS) || (delta > END1_SOFT_ACCEPT_MAX_MS) ||
      (MessageRx_SelectSoftDataCandidate(result, &candidate_bits, &candidate_energy,
                                         &second_energy, &confidence) == 0U) ||
      (candidate_bits != msg_end[1]))
  {
    return 0U;
  }

  soft_result = *result;
  soft_result.valid = 1U;
  soft_result.bits = candidate_bits;
  soft_result.freq_hz = fsk_rx_freqs_hz[candidate_bits];
  soft_result.max_energy = candidate_energy;
  soft_result.second_energy = second_energy;
  printf("rx end1 soft accept: delta=%lums confidence=%u\r\n",
         (unsigned long)delta, (unsigned int)(confidence * 100.0f));
  MessageRx_AcceptSymbol(&soft_result, now);
  return 1U;
}

static void MessageRx_AppendRsBits(uint8_t decoded_bits, uint8_t erased,
                                   float confidence)
{
  if (msg_rs_fsk_index == 0U)
  {
    msg_rs_current_reliability = RS_VOTE_RATIO_CAP;
  }
  if (erased != 0U)
  {
    msg_rs_current_erased = 1U;
    confidence = 0.0f;
  }
  if (confidence < msg_rs_current_reliability)
  {
    msg_rs_current_reliability = confidence;
  }

  msg_rs_symbol = (uint8_t)((msg_rs_symbol << 2U) | (decoded_bits & 0x03U));
  msg_rs_fsk_index++;
  if (msg_rs_fsk_index < RS_FSK_SYMBOLS_PER_SYMBOL)
  {
    return;
  }

  {
    uint8_t wire_index = msg_rs_symbol_index;
    uint8_t block = (uint8_t)(wire_index % RS_BLOCK_COUNT);
    uint8_t block_index = (uint8_t)(wire_index / RS_BLOCK_COUNT);
    uint16_t codeword_index = (uint16_t)(block * RS_CODEWORD_SYMBOLS) + block_index;

    msg_rs_codeword[codeword_index] = msg_rs_symbol;
    msg_rs_codeword_erased[codeword_index] = msg_rs_current_erased;
    msg_rs_codeword_reliability[codeword_index] = msg_rs_current_reliability;
    msg_rs_symbol_index++;
  }
  if (msg_rs_current_erased != 0U)
  {
    msg_rs_erasure_count++;
    printf("rx rs wire %u/%u B%u S%u: 0x%02X [slot erasure]\r\n",
           msg_rs_symbol_index, RS_TOTAL_CODEWORD_SYMBOLS,
           ((msg_rs_symbol_index - 1U) % RS_BLOCK_COUNT) + 1U,
           ((msg_rs_symbol_index - 1U) / RS_BLOCK_COUNT) + 1U,
           msg_rs_symbol);
  }
  else
  {
    printf("rx rs wire %u/%u B%u S%u: 0x%02X\r\n",
           msg_rs_symbol_index, RS_TOTAL_CODEWORD_SYMBOLS,
           ((msg_rs_symbol_index - 1U) % RS_BLOCK_COUNT) + 1U,
           ((msg_rs_symbol_index - 1U) / RS_BLOCK_COUNT) + 1U,
           msg_rs_symbol);
  }

  msg_rs_symbol = 0U;
  msg_rs_fsk_index = 0U;
  msg_rs_current_erased = 0U;
  msg_rs_current_reliability = RS_VOTE_RATIO_CAP;
}

static void MessageRx_RecordDecision(uint16_t fsk_index, uint8_t source,
                                     uint8_t selected_bits, float confidence,
                                     const float *energy)
{
  uint8_t target;

  if ((source != RX_DECISION_ERASURE) &&
      (confidence < FSK_RATIO_THRESHOLD))
  {
    msg_low_confidence_count++;
  }

  if (msg_worst_decision_count < RX_DIAG_WORST_COUNT)
  {
    target = msg_worst_decision_count;
    msg_worst_decision_count++;
  }
  else
  {
    target = 0U;
    for (uint8_t i = 1U; i < RX_DIAG_WORST_COUNT; i++)
    {
      if (msg_worst_decisions[i].confidence >
          msg_worst_decisions[target].confidence)
      {
        target = i;
      }
    }
    if (confidence >= msg_worst_decisions[target].confidence)
    {
      return;
    }
  }

  msg_worst_decisions[target].fsk_index = fsk_index;
  msg_worst_decisions[target].source = source;
  msg_worst_decisions[target].selected_bits = selected_bits;
  msg_worst_decisions[target].confidence = confidence;
  if (energy != NULL)
  {
    memcpy(msg_worst_decisions[target].energy, energy,
           sizeof(msg_worst_decisions[target].energy));
  }
  else
  {
    memset(msg_worst_decisions[target].energy, 0,
           sizeof(msg_worst_decisions[target].energy));
  }
}

static void MessageRx_PrintDecisionDiagnostics(void)
{
  uint8_t printed[RX_DIAG_WORST_COUNT] = {0};

  printf("rx weak decisions: lowest %u of %u data slots\r\n",
         msg_worst_decision_count,
         RS_TOTAL_CODEWORD_SYMBOLS * RS_FSK_SYMBOLS_PER_SYMBOL);
  for (uint8_t rank = 0U; rank < msg_worst_decision_count; rank++)
  {
    uint8_t selected = 0xFFU;
    const RxDecisionDiagnostic *diag;
    const char *source_name;
    uint16_t wire_index;
    uint8_t decoded_bits;

    for (uint8_t i = 0U; i < msg_worst_decision_count; i++)
    {
      if ((printed[i] == 0U) &&
          ((selected == 0xFFU) ||
           (msg_worst_decisions[i].confidence <
            msg_worst_decisions[selected].confidence)))
      {
        selected = i;
      }
    }
    if (selected == 0xFFU)
    {
      break;
    }
    printed[selected] = 1U;
    diag = &msg_worst_decisions[selected];
    wire_index = (uint16_t)(diag->fsk_index / RS_FSK_SYMBOLS_PER_SYMBOL);
    decoded_bits = (uint8_t)((diag->selected_bits ^
                              Message_WhiteningMask(diag->fsk_index)) & 0x03U);

    switch (diag->source)
    {
      case RX_DECISION_VOTE: source_name = "vote"; break;
      case RX_DECISION_NEAREST: source_name = "nearest"; break;
      case RX_DECISION_SOFT: source_name = "soft"; break;
      default: source_name = "erasure"; break;
    }

    if (diag->source == RX_DECISION_ERASURE)
    {
      printf("rx weak B%u S%u slot%u src=%s ratio=0\r\n",
             (wire_index % RS_BLOCK_COUNT) + 1U,
             (wire_index / RS_BLOCK_COUNT) + 1U,
             (diag->fsk_index % RS_FSK_SYMBOLS_PER_SYMBOL) + 1U,
             source_name);
    }
    else
    {
      printf("rx weak B%u S%u slot%u src=%s tone=%s data=%s ratio_x100=%u E/1e6=%u/%u/%u/%u\r\n",
             (wire_index % RS_BLOCK_COUNT) + 1U,
             (wire_index / RS_BLOCK_COUNT) + 1U,
             (diag->fsk_index % RS_FSK_SYMBOLS_PER_SYMBOL) + 1U,
             source_name, FSK_BitsToString(diag->selected_bits),
             FSK_BitsToString(decoded_bits),
             (unsigned int)(diag->confidence * 100.0f),
             (unsigned int)(diag->energy[0] / 1000000.0f),
             (unsigned int)(diag->energy[1] / 1000000.0f),
             (unsigned int)(diag->energy[2] / 1000000.0f),
             (unsigned int)(diag->energy[3] / 1000000.0f));
    }
  }
}

static void MessageRx_ClearCapture(void)
{
  memset(msg_capture_bits, 0, sizeof(msg_capture_bits));
  memset(msg_capture_valid, 0, sizeof(msg_capture_valid));
  memset(msg_capture_distance, 0xFF, sizeof(msg_capture_distance));
  memset(msg_capture_scores, 0, sizeof(msg_capture_scores));
  memset(msg_capture_best_ratio, 0, sizeof(msg_capture_best_ratio));
  memset(msg_capture_best_energy, 0, sizeof(msg_capture_best_energy));
  memset(msg_soft_bits, 0, sizeof(msg_soft_bits));
  memset(msg_soft_valid, 0, sizeof(msg_soft_valid));
  memset(msg_soft_score, 0, sizeof(msg_soft_score));
  memset(msg_soft_ratio, 0, sizeof(msg_soft_ratio));
  memset(msg_soft_energy, 0, sizeof(msg_soft_energy));
}

static void MessageRx_FinalizeCapture(void)
{
  uint8_t rs_index = msg_rs_symbol_index;

  for (uint8_t slot = 0U; slot < RS_FSK_SYMBOLS_PER_SYMBOL; slot++)
  {
    uint16_t fsk_index = ((uint16_t)rs_index * RS_FSK_SYMBOLS_PER_SYMBOL) + slot;
    uint8_t voted_bits = 0U;
    float voted_score = msg_capture_scores[slot][0];
    float second_score = 0.0f;

    for (uint8_t candidate = 1U; candidate < 4U; candidate++)
    {
      float score = msg_capture_scores[slot][candidate];

      if (score > voted_score)
      {
        second_score = voted_score;
        voted_score = score;
        voted_bits = candidate;
      }
      else if (score > second_score)
      {
        second_score = score;
      }
    }

    if (voted_score > second_score)
    {
      float confidence = (second_score > 0.0f) ?
                         (voted_score / second_score) : RS_VOTE_RATIO_CAP;

      if (confidence > RS_VOTE_RATIO_CAP)
      {
        confidence = RS_VOTE_RATIO_CAP;
      }
      if ((msg_capture_valid[slot] == 0U) || (voted_bits != msg_capture_bits[slot]))
      {
        msg_vote_override_count++;
      }
      uint8_t decoded_bits = (uint8_t)((voted_bits ^
                                        Message_WhiteningMask(fsk_index)) & 0x03U);
      MessageRx_RecordDecision(fsk_index, RX_DECISION_VOTE, voted_bits,
                               confidence,
                               msg_capture_best_energy[slot][voted_bits]);
      MessageRx_AppendRsBits(decoded_bits, 0U, confidence);
    }
    else if (msg_capture_valid[slot] != 0U)
    {
      uint8_t decoded_bits = (uint8_t)((msg_capture_bits[slot] ^
                                        Message_WhiteningMask(fsk_index)) & 0x03U);
      MessageRx_RecordDecision(fsk_index, RX_DECISION_NEAREST,
                               msg_capture_bits[slot],
                               msg_capture_best_ratio[slot][msg_capture_bits[slot]],
                               msg_capture_best_energy[slot][msg_capture_bits[slot]]);
      MessageRx_AppendRsBits(decoded_bits, 0U,
                             msg_capture_best_ratio[slot][msg_capture_bits[slot]]);
    }
    else if (msg_soft_valid[slot] != 0U)
    {
      uint8_t decoded_bits = (uint8_t)((msg_soft_bits[slot] ^
                                        Message_WhiteningMask(fsk_index)) & 0x03U);
      msg_soft_fallback_count++;
      MessageRx_RecordDecision(fsk_index, RX_DECISION_SOFT,
                               msg_soft_bits[slot], msg_soft_ratio[slot],
                               msg_soft_energy[slot]);
      MessageRx_AppendRsBits(decoded_bits, 0U, msg_soft_ratio[slot]);
    }
    else
    {
      MessageRx_RecordDecision(fsk_index, RX_DECISION_ERASURE, 0U, 0.0f, NULL);
      MessageRx_AppendRsBits(0U, 1U, 0.0f);
    }
  }

  MessageRx_ClearCapture();
  if (msg_rs_symbol_index >= RS_TOTAL_CODEWORD_SYMBOLS)
  {
    printf("rx RS codeword complete, slot erasures=%u, soft_fallbacks=%u, low_confidence=%u, vote_overrides=%u\r\n",
           msg_rs_erasure_count, msg_soft_fallback_count,
           msg_low_confidence_count, msg_vote_override_count);
  }
}

static void MessageRx_AcceptSymbol(const FSK_DetectResult *result, uint32_t now)
{
  uint8_t bits = result->bits;

  msg_frame_tick = now;
  MessageRx_PrintSymbol(result, now);

  switch (msg_rx_state)
  {
    case MSG_RX_SEARCH:
      if ((bits == FSK_SYNC_SYMBOL) && (MessageRx_TryTimedPreambleRecovery(now) != 0U))
      {
        break;
      }
      if (bits == msg_preamble[msg_preamble_index])
      {
        if (msg_preamble_index == 0U)
        {
          memset(msg_preamble_energy, 0, sizeof(msg_preamble_energy));
          MessageRx_ResetPreambleCapture();
          msg_preamble_capture_active = 1U;
          msg_preamble_capture_stage = 0U;
        }
        else
        {
          msg_preamble_capture_active = 1U;
          msg_preamble_capture_stage = msg_preamble_index;
        }
        MessageRx_AddPreambleRawWindow(msg_preamble_index, result, now);

        if ((msg_preamble_index == 1U) && (bits == msg_preamble[1]))
        {
          memset(msg_preamble_recovery_energy, 0, sizeof(msg_preamble_recovery_energy));
          memset(msg_preamble_recovery_start_energy, 0,
                 sizeof(msg_preamble_recovery_start_energy));
          memset(msg_preamble_recovery_start_bits, 0,
                 sizeof(msg_preamble_recovery_start_bits));
          msg_preamble_recovery_energy[0] = msg_preamble_energy[0];
          msg_preamble_recovery_energy[1] = result->data_energy[1];
          msg_preamble_recovery_tick = now;
          msg_preamble_recovery_active = 1U;
        }
        msg_preamble_energy[msg_preamble_index] = result->max_energy;
        msg_preamble_index++;

        if (msg_preamble_index >= MSG_PREAMBLE_LEN)
        {
          msg_preamble_index = 0U;
          msg_preamble_recovery_active = 0U;
          /* Multi-node mode has no startup calibration.  Apply the four-tone
             PREAMBLE normalization before decoding source/destination, or a
             weak address frequency can be missed and RS data can be consumed
             as the address.  Keep this scale for the remainder of the frame. */
          msg_preamble_capture_active = 0U;
          MessageRx_ApplyPreambleFrameScale();
          msg_start_entry_tick = now;
          msg_rx_state = MSG_RX_START_0;
          printf("rx preamble ok\r\n");
        }
      }
      else
      {
        memset(msg_preamble_energy, 0, sizeof(msg_preamble_energy));
        if (bits == msg_preamble[0])
        {
          if (msg_preamble_recovery_active == 0U)
          {
            MessageRx_ResetPreambleCapture();
            msg_preamble_capture_active = 1U;
            msg_preamble_capture_stage = 0U;
            MessageRx_AddPreambleRawWindow(0U, result, now);
          }
          msg_preamble_energy[0] = result->max_energy;
          msg_preamble_index = 1U;
        }
        else
        {
          if (msg_preamble_recovery_active == 0U)
          {
            MessageRx_ResetPreambleCapture();
          }
          msg_preamble_index = 0U;
        }
      }
      break;

    case MSG_RX_START_0:
      if (bits < 3U)
      {
        msg_rx_source_id = Node_IdFromSourceBits(bits);
        msg_preamble_capture_active = 0U;
        msg_rx_state = MSG_RX_START_1;
        printf("rx address source: bits=%s -> N%u\r\n",
               FSK_BitsToString(bits), msg_rx_source_id);
      }
      else if ((bits == msg_preamble[MSG_PREAMBLE_LEN - 1U]) ||
               (bits == FSK_SYNC_SYMBOL))
      {
        /* A strong 4500 Hz PREAMBLE tail can survive into the first START
           window.  Source IDs deliberately use only 00/01/10, so 11 remains
           available as an unambiguous transition guard. */
        printf("rx start0 transition ignored: got=%s\r\n",
               FSK_BitsToString(bits));
      }
      else
      {
        printf("rx source address fail: got=%s\r\n", FSK_BitsToString(bits));
        MessageRx_ResetFrame();
      }
      break;

    case MSG_RX_START_1:
      if (bits < 4U)
      {
        msg_rx_destination_id = bits;
        msg_rs_symbol_index = 0U;
        msg_rs_fsk_index = 0U;
        msg_rs_symbol = 0U;
        msg_rs_current_erased = 0U;
        msg_rs_current_reliability = RS_VOTE_RATIO_CAP;
        msg_rs_erasure_count = 0U;
        msg_soft_fallback_count = 0U;
        msg_low_confidence_count = 0U;
        msg_vote_override_count = 0U;
        msg_worst_decision_count = 0U;
        memset(msg_worst_decisions, 0, sizeof(msg_worst_decisions));
        msg_marker_tick = 0U;
        msg_start_entry_tick = 0U;
        MessageRx_ClearCapture();
        memset(msg_rs_codeword, 0, sizeof(msg_rs_codeword));
        memset(msg_rs_codeword_erased, 0, sizeof(msg_rs_codeword_erased));
        memset(msg_rs_codeword_reliability, 0, sizeof(msg_rs_codeword_reliability));
        msg_rx_state = MSG_RX_RS_SYNC;
        if (msg_rx_destination_id == 0U)
        {
          printf("rx route: N%u->ALL, receiving %ux marker-framed RS(%u,%u) blocks\r\n",
                 msg_rx_source_id, RS_BLOCK_COUNT, RS_CODEWORD_SYMBOLS,
                 RS_DATA_SYMBOLS);
        }
        else
        {
          printf("rx route: N%u->N%u, receiving %ux marker-framed RS(%u,%u) blocks\r\n",
                 msg_rx_source_id, msg_rx_destination_id, RS_BLOCK_COUNT,
                 RS_CODEWORD_SYMBOLS, RS_DATA_SYMBOLS);
        }
      }
      else if (bits == FSK_SYNC_SYMBOL)
      {
        printf("rx destination transition marker ignored\r\n");
      }
      else
      {
        printf("rx destination address fail: got=%s\r\n", FSK_BitsToString(bits));
        MessageRx_ResetFrame();
      }
      break;

    case MSG_RX_RS_SYNC:
      if (bits == FSK_SYNC_SYMBOL)
      {
        msg_marker_tick = now;
        MessageRx_ClearCapture();
        msg_rx_state = MSG_RX_RS_CODEWORD;
        printf("rx marker open: RS symbol %u/%u\r\n",
               msg_rs_symbol_index + 1U, RS_TOTAL_CODEWORD_SYMBOLS);
      }
      break;

    case MSG_RX_RS_CODEWORD:
      if (bits == FSK_SYNC_SYMBOL)
      {
        uint32_t marker_delta = now - msg_marker_tick;
        uint32_t marker_intervals = (marker_delta + (RS_MARKER_INTERVAL_MS / 2U)) /
                                    RS_MARKER_INTERVAL_MS;
        uint32_t missing_markers;

        if (marker_delta < (RS_MARKER_INTERVAL_MS - RS_MARKER_ACCEPT_EARLY_MS))
        {
          printf("rx early marker ignored: delta=%lums\r\n", (unsigned long)marker_delta);
          break;
        }

        if (marker_intervals == 0U)
        {
          marker_intervals = 1U;
        }
        missing_markers = marker_intervals - 1U;

        MessageRx_FinalizeCapture();
        while ((missing_markers > 0U) && (msg_rs_symbol_index < RS_TOTAL_CODEWORD_SYMBOLS))
        {
          printf("rx marker missing: erase RS symbol %u\r\n", msg_rs_symbol_index + 1U);
          MessageRx_ClearCapture();
          MessageRx_FinalizeCapture();
          missing_markers--;
        }

        if (msg_rs_symbol_index >= RS_TOTAL_CODEWORD_SYMBOLS)
        {
          msg_rx_state = MSG_RX_END_0;
          printf("rx closing marker ok\r\n");
        }
        else
        {
          msg_marker_tick = now;
          MessageRx_ClearCapture();
          msg_rx_state = MSG_RX_RS_CODEWORD;
          printf("rx marker open: RS symbol %u/%u\r\n",
                 msg_rs_symbol_index + 1U, RS_TOTAL_CODEWORD_SYMBOLS);
        }
      }
      else
      {
        (void)MessageRx_CaptureDataWindow(result, now);
      }
      break;

    case MSG_RX_END_0:
      if (bits == FSK_SYNC_SYMBOL)
      {
        printf("rx closing marker ok\r\n");
      }
      else if (bits == msg_end[0])
      {
        msg_rx_state = MSG_RX_END_1;
      }
      else
      {
        printf("rx end0 fail\r\n");
        MessageRx_ResetFrame();
      }
      break;

    case MSG_RX_END_1:
      if (bits == FSK_SYNC_SYMBOL)
      {
        printf("rx end1 transition marker ignored\r\n");
        break;
      }
      else if (bits == msg_end[1])
      {
        uint8_t received_codewords[RS_TOTAL_CODEWORD_SYMBOLS];
        uint8_t candidate0[RS_CODEWORD_SYMBOLS];
        uint8_t candidate1[RS_CODEWORD_SYMBOLS];
        uint8_t selected_corrected[RS_BLOCK_COUNT] = {0};
        uint8_t selected_erasures[RS_BLOCK_COUNT] = {0};
        uint8_t selected_adaptive[RS_BLOCK_COUNT] = {0};
        uint8_t selected = 0U;
        uint8_t rs_pair_seen = 0U;
        uint8_t crc_failure_seen = 0U;
        uint8_t format_failure_seen = 0U;
        uint8_t failure_index = 0U;
        uint8_t failure_code = 0U;
        uint8_t saved_failure_index = 0U;
        uint8_t saved_failure_code = 0U;
        uint16_t received_crc = 0U;
        uint16_t calculated_crc = 0U;
        uint16_t saved_received_crc = 0U;
        uint16_t saved_calculated_crc = 0U;
        MessagePayloadStatus payload_status = MESSAGE_PAYLOAD_CRC_FAIL;
        MessagePayloadStatus saved_format_status = MESSAGE_PAYLOAD_OK;

        printf("rx end ok\r\n");
        memcpy(received_codewords, msg_rs_codeword,
               sizeof(received_codewords));

        /* Search in increasing total added erasures.  A syndrome-valid pair
           is accepted only if its CRC and payload structure both pass. */
        for (uint8_t total_add = 0U;
             (total_add <= (RS_PARITY_SYMBOLS * RS_BLOCK_COUNT)) &&
             (selected == 0U);
             total_add++)
        {
          for (uint8_t add0 = 0U;
               (add0 <= RS_PARITY_SYMBOLS) && (add0 <= total_add);
               add0++)
          {
            uint8_t add1 = (uint8_t)(total_add - add0);
            uint8_t corrected0 = 0U;
            uint8_t corrected1 = 0U;
            uint8_t erasures0 = 0U;
            uint8_t erasures1 = 0U;

            if (add1 > RS_PARITY_SYMBOLS)
            {
              continue;
            }
            if (RS_DecodeAdaptiveAttempt(&received_codewords[0],
                                         &msg_rs_codeword_erased[0],
                                         &msg_rs_codeword_reliability[0],
                                         add0, candidate0, &corrected0,
                                         &erasures0) < 0)
            {
              continue;
            }
            if (RS_DecodeAdaptiveAttempt(
                    &received_codewords[RS_CODEWORD_SYMBOLS],
                    &msg_rs_codeword_erased[RS_CODEWORD_SYMBOLS],
                    &msg_rs_codeword_reliability[RS_CODEWORD_SYMBOLS],
                    add1, candidate1, &corrected1, &erasures1) < 0)
            {
              continue;
            }

            rs_pair_seen = 1U;
            memcpy(&msg_rs_codeword[0], candidate0, RS_CODEWORD_SYMBOLS);
            memcpy(&msg_rs_codeword[RS_CODEWORD_SYMBOLS], candidate1,
                   RS_CODEWORD_SYMBOLS);
            payload_status = Message_ValidateRsPayload(
                msg_rs_codeword, msg_rx_source_id, msg_rx_destination_id,
                rx_message, &rx_message_len,
                &received_crc, &calculated_crc, &failure_index,
                &failure_code);
            if (payload_status == MESSAGE_PAYLOAD_OK)
            {
              selected_corrected[0] = corrected0;
              selected_corrected[1] = corrected1;
              selected_erasures[0] = erasures0;
              selected_erasures[1] = erasures1;
              selected_adaptive[0] = add0;
              selected_adaptive[1] = add1;
              selected = 1U;
              break;
            }
            if (payload_status == MESSAGE_PAYLOAD_CRC_FAIL)
            {
              crc_failure_seen = 1U;
              saved_received_crc = received_crc;
              saved_calculated_crc = calculated_crc;
            }
            else
            {
              format_failure_seen = 1U;
              saved_format_status = payload_status;
              saved_failure_index = failure_index;
              saved_failure_code = failure_code;
            }
          }
        }

        if (selected != 0U)
        {
          uint8_t total_corrected =
              (uint8_t)(selected_corrected[0] + selected_corrected[1]);
          uint8_t total_decode_erasures =
              (uint8_t)(selected_erasures[0] + selected_erasures[1]);
          uint8_t total_adaptive_erasures =
              (uint8_t)(selected_adaptive[0] + selected_adaptive[1]);

          for (uint8_t block = 0U; block < RS_BLOCK_COUNT; block++)
          {
            printf("rs block %u/%u ok: erasures=%u (GMD +%u) corrected_total=%u capacity=2e+s<=%u\r\n",
                   block + 1U, RS_BLOCK_COUNT, selected_erasures[block],
                   selected_adaptive[block], selected_corrected[block],
                   RS_PARITY_SYMBOLS);
          }
          printf("CRC12 ok: route=N%u->%s received=calculated=0x%03X\r\n",
                 msg_rx_source_id,
                 Node_DestinationLabel(msg_rx_destination_id), received_crc);
          printf("rs decode ok: corrected_locations=%u, slot_erasures=%u, decode_erasures=%u (GMD +%u), rule=2e+s<=%u/block\r\n",
                 total_corrected, msg_rs_erasure_count, total_decode_erasures,
                 total_adaptive_erasures, RS_PARITY_SYMBOLS);
          if (local_node_id == 0U)
          {
            printf("message ignored: local node ID unset; press RX key 1/2/3\r\n");
          }
          else if ((msg_rx_destination_id != 0U) &&
                   (msg_rx_destination_id != local_node_id))
          {
            printf("message ignored: addressed to N%u, local=N%u\r\n",
                   msg_rx_destination_id, local_node_id);
          }
          else
          {
            rx_message_valid = 1U;
            rx_message_source_id = msg_rx_source_id;
            rx_message_destination_id = msg_rx_destination_id;
            rx_rs_corrected = total_corrected;
            memcpy(message_store_pending_text, rx_message, rx_message_len + 1U);
            message_store_pending_len = rx_message_len;
            message_store_pending_source = msg_rx_source_id;
            message_store_pending_destination = msg_rx_destination_id;
            message_store_pending = 1U;
            message_store_last_save_failed = 0U;
            StatusLed_NotifyRxComplete();
            printf("message_ok: N%u->%s len=%u text=\"%s\"\r\n",
                   msg_rx_source_id,
                   Node_DestinationLabel(msg_rx_destination_id),
                   rx_message_len, rx_message);
          }
        }
        else if (rs_pair_seen == 0U)
        {
          printf("rs decode fail: no block pair satisfied 2e+s<=%u\r\n",
                 RS_PARITY_SYMBOLS);
          MessageRx_PrintDecisionDiagnostics();
        }
        else
        {
          if (crc_failure_seen != 0U)
          {
            printf("message CRC12 fail: no GMD candidate matched, last received=0x%03X calculated=0x%03X\r\n",
                   saved_received_crc, saved_calculated_crc);
          }
          if (format_failure_seen != 0U)
          {
            if (saved_format_status == MESSAGE_PAYLOAD_DATA_AFTER_PAD)
            {
              printf("rx payload format fail: data 0x%02X after padding at %u\r\n",
                     saved_failure_code, saved_failure_index);
            }
            else if (saved_format_status == MESSAGE_PAYLOAD_INVALID_CODE)
            {
              printf("rx payload format fail: invalid code %u at %u\r\n",
                     saved_failure_code, saved_failure_index);
            }
            else
            {
              printf("rx payload format fail: empty message\r\n");
            }
          }
          printf("message fail: all syndrome-valid GMD candidates rejected by CRC/payload\r\n");
          MessageRx_PrintDecisionDiagnostics();
        }
      }
      else if (bits == msg_end[0])
      {
        printf("rx end1 repeated end0 ignored\r\n");
        break;
      }
      else
      {
        printf("rx end1 fail\r\n");
      }
      MessageRx_ResetFrame();
      break;

    default:
      MessageRx_ResetFrame();
      break;
  }
}

static void MessageRx_ResetFrame(void)
{
  MessageRx_RestoreCalibrationEnergyScale();
  msg_rx_state = MSG_RX_SEARCH;
  msg_preamble_index = 0U;
  msg_start_entry_tick = 0U;
  memset(msg_preamble_energy, 0, sizeof(msg_preamble_energy));
  MessageRx_ResetPreambleCapture();
  msg_preamble_recovery_active = 0U;
  msg_preamble_recovery_tick = 0U;
  memset(msg_preamble_recovery_energy, 0, sizeof(msg_preamble_recovery_energy));
  memset(msg_preamble_recovery_start_energy, 0,
         sizeof(msg_preamble_recovery_start_energy));
  memset(msg_preamble_recovery_start_bits, 0,
         sizeof(msg_preamble_recovery_start_bits));
  msg_rx_source_id = 0U;
  msg_rx_destination_id = 0U;
  msg_rs_symbol_index = 0U;
  msg_rs_fsk_index = 0U;
  msg_rs_symbol = 0U;
  msg_rs_current_erased = 0U;
  msg_rs_current_reliability = RS_VOTE_RATIO_CAP;
  msg_rs_erasure_count = 0U;
  msg_soft_fallback_count = 0U;
  msg_low_confidence_count = 0U;
  msg_vote_override_count = 0U;
  msg_worst_decision_count = 0U;
  memset(msg_worst_decisions, 0, sizeof(msg_worst_decisions));
  msg_marker_tick = 0U;
  MessageRx_ClearCapture();
  memset(msg_rs_codeword, 0, sizeof(msg_rs_codeword));
  memset(msg_rs_codeword_erased, 0, sizeof(msg_rs_codeword_erased));
  memset(msg_rs_codeword_reliability, 0, sizeof(msg_rs_codeword_reliability));
  msg_frame_tick = 0U;
}

static uint8_t Message_WhiteningMask(uint16_t fsk_symbol_index)
{
  static const uint8_t mask_cycle[4] = {0x00U, 0x01U, 0x02U, 0x03U};
  return mask_cycle[fsk_symbol_index & 0x03U];
}

static uint8_t Node_SourceBitsFromId(uint8_t node_id)
{
  return ((node_id >= 1U) && (node_id <= 3U)) ?
         (uint8_t)(node_id - 1U) : 0x03U;
}

static uint8_t Node_IdFromSourceBits(uint8_t bits)
{
  return (bits < 3U) ? (uint8_t)(bits + 1U) : 0U;
}

static const char *Node_DestinationLabel(uint8_t destination)
{
  static const char *labels[4U] = {"ALL", "N1", "N2", "N3"};
  return (destination < 4U) ? labels[destination] : "?";
}

static void Node_SetLocalId(uint8_t node_id)
{
  if ((node_id < 1U) || (node_id > 3U))
  {
    return;
  }
  local_node_id = node_id;
  if (tx_destination_id == local_node_id)
  {
    tx_destination_id = 0U;
  }
  printf("node configured: local=N%u, destination=%s; RX keys 1/2/3=set local, D=cycle destination\r\n",
         local_node_id, Node_DestinationLabel(tx_destination_id));
  OLED_PrintRxStatus();
}

static void Node_CycleDestination(void)
{
  do
  {
    tx_destination_id = (uint8_t)((tx_destination_id + 1U) & 0x03U);
  }
  while ((local_node_id != 0U) && (tx_destination_id == local_node_id));

  if (tx_destination_id == 0U)
  {
    printf("destination: ALL (broadcast)\r\n");
  }
  else
  {
    printf("destination: N%u\r\n", tx_destination_id);
  }
  OLED_PrintRxStatus();
}

static uint8_t Message_CharToCode(char ch)
{
  if ((ch >= '0') && (ch <= '9'))
  {
    return (uint8_t)(ch - '0');
  }
  if ((ch >= 'A') && (ch <= 'Z'))
  {
    return (uint8_t)(10U + (uint8_t)(ch - 'A'));
  }

  switch (ch)
  {
    case ' ': return 36U;
    case '.': return 37U;
    case ',': return 38U;
    case '?': return 39U;
    case '!': return 40U;
    default: return MESSAGE_CODE_INVALID;
  }
}

static char Message_CodeToChar(uint8_t code)
{
  if (code <= 9U)
  {
    return (char)('0' + code);
  }
  if (code <= 35U)
  {
    return (char)('A' + (code - 10U));
  }

  switch (code)
  {
    case 36U: return ' ';
    case 37U: return '.';
    case 38U: return ',';
    case 39U: return '?';
    case 40U: return '!';
    default: return 0;
  }
}

/* CRC-12/3GPP polynomial x^12+x^11+x^3+x^2+x+1 (0x80F),
   initialized to zero and fed MSB-first over each 6-bit payload symbol. */
static uint16_t Message_Crc12Symbols(const uint8_t *symbols, uint8_t count)
{
  uint16_t crc = 0U;

  for (uint8_t i = 0U; i < count; i++)
  {
    uint8_t symbol = (uint8_t)(symbols[i] & RS_FIELD_ORDER);

    for (uint8_t mask = 0x20U; mask != 0U; mask >>= 1U)
    {
      uint8_t feedback = (uint8_t)(((crc >> 11U) ^
                                    ((symbol & mask) != 0U ? 1U : 0U)) & 1U);
      crc = (uint16_t)((crc << 1U) & MESSAGE_CRC12_MASK);
      if (feedback != 0U)
      {
        crc ^= MESSAGE_CRC12_POLY;
      }
    }
  }
  return (uint16_t)(crc & MESSAGE_CRC12_MASK);
}

static uint16_t Message_Crc12Addressed(uint8_t source, uint8_t destination,
                                      const uint8_t *symbols, uint8_t count)
{
  uint8_t addressed_symbols[MESSAGE_MAX_LEN + 2U];

  addressed_symbols[0] = (uint8_t)(source & 0x03U);
  addressed_symbols[1] = (uint8_t)(destination & 0x03U);
  memcpy(&addressed_symbols[2], symbols, count);
  return Message_Crc12Symbols(addressed_symbols, (uint8_t)(count + 2U));
}

static uint8_t Message_CrcSelfTest(void)
{
  uint8_t symbols[MESSAGE_MAX_LEN];

  for (uint8_t i = 0U; i < MESSAGE_MAX_LEN; i++)
  {
    symbols[i] = i;
  }
  return ((Message_Crc12Symbols(symbols, MESSAGE_MAX_LEN) == 0x0708U) &&
          (Message_Crc12Addressed(1U, 2U, symbols, MESSAGE_MAX_LEN) == 0x0780U)) ?
         1U : 0U;
}

static MessagePayloadStatus Message_ValidateRsPayload(const uint8_t *codewords,
                                                       uint8_t source,
                                                       uint8_t destination,
                                                       char *text,
                                                       uint8_t *text_len,
                                                       uint16_t *received_crc,
                                                       uint16_t *calculated_crc,
                                                       uint8_t *failure_index,
                                                       uint8_t *failure_code)
{
  uint8_t data[RS_TOTAL_DATA_SYMBOLS];
  uint8_t pad_seen = 0U;

  *text_len = 0U;
  *failure_index = 0U;
  *failure_code = 0U;
  for (uint8_t i = 0U; i < RS_TOTAL_DATA_SYMBOLS; i++)
  {
    uint8_t block = (uint8_t)(i / RS_DATA_SYMBOLS);
    uint8_t block_index = (uint8_t)(i % RS_DATA_SYMBOLS);
    data[i] = codewords[(block * RS_CODEWORD_SYMBOLS) + block_index];
  }

  *calculated_crc = Message_Crc12Addressed(source, destination,
                                           data, MESSAGE_MAX_LEN);
  *received_crc = (uint16_t)(((uint16_t)data[MESSAGE_MAX_LEN] << 6U) |
                             data[MESSAGE_MAX_LEN + 1U]);
  if (*received_crc != *calculated_crc)
  {
    text[0] = '\0';
    return MESSAGE_PAYLOAD_CRC_FAIL;
  }

  for (uint8_t i = 0U; i < MESSAGE_MAX_LEN; i++)
  {
    uint8_t code = data[i];

    if (code == RS_PAD_VALUE)
    {
      pad_seen = 1U;
      continue;
    }
    if (pad_seen != 0U)
    {
      *failure_index = i;
      *failure_code = code;
      text[0] = '\0';
      return MESSAGE_PAYLOAD_DATA_AFTER_PAD;
    }

    {
      char ch = Message_CodeToChar(code);
      if (ch == 0)
      {
        *failure_index = i;
        *failure_code = code;
        text[0] = '\0';
        return MESSAGE_PAYLOAD_INVALID_CODE;
      }
      text[(*text_len)++] = ch;
    }
  }
  text[*text_len] = '\0';
  if (*text_len == 0U)
  {
    return MESSAGE_PAYLOAD_EMPTY;
  }
  return MESSAGE_PAYLOAD_OK;
}

static uint32_t MessageStore_HashRecord(const MessageStoreRecord *record)
{
  const uint8_t *data = (const uint8_t *)&record->sequence;
  const uint16_t data_len = (uint16_t)((2U * sizeof(uint32_t)) + MESSAGE_MAX_LEN);
  uint32_t hash = 2166136261UL;

  for (uint16_t i = 0U; i < data_len; i++)
  {
    hash ^= data[i];
    hash *= 16777619UL;
  }
  return hash;
}

static uint8_t MessageStore_RecordLength(const MessageStoreRecord *record)
{
  return (uint8_t)(record->length & MESSAGE_STORE_LENGTH_MASK);
}

static uint8_t MessageStore_RecordSource(const MessageStoreRecord *record)
{
  return (uint8_t)((record->length >> MESSAGE_STORE_SOURCE_SHIFT) & 0x03U);
}

static uint8_t MessageStore_RecordDestination(const MessageStoreRecord *record)
{
  return (uint8_t)((record->length >> MESSAGE_STORE_DEST_SHIFT) & 0x03U);
}

static uint8_t MessageStore_RecordIsErased(uint32_t address)
{
  const uint32_t *words = (const uint32_t *)address;
  const uint16_t word_count = (uint16_t)(sizeof(MessageStoreRecord) / sizeof(uint32_t));

  for (uint16_t i = 0U; i < word_count; i++)
  {
    if (words[i] != 0xFFFFFFFFUL)
    {
      return 0U;
    }
  }
  return 1U;
}

static uint8_t MessageStore_RecordValid(const MessageStoreRecord *record)
{
  uint8_t len = MessageStore_RecordLength(record);
  uint8_t source = MessageStore_RecordSource(record);

  if ((record->magic != MESSAGE_STORE_MAGIC) ||
      (record->commit != MESSAGE_STORE_COMMIT) ||
      (len == 0U) || (len > MESSAGE_MAX_LEN) ||
      (source > 3U) ||
      ((record->length & ~(MESSAGE_STORE_LENGTH_MASK |
                           MESSAGE_STORE_ROUTE_MASK)) != 0U) ||
      (record->hash != MessageStore_HashRecord(record)))
  {
    return 0U;
  }

  for (uint8_t i = 0U; i < len; i++)
  {
    if (Message_CharToCode((char)record->text[i]) == MESSAGE_CODE_INVALID)
    {
      return 0U;
    }
  }
  return 1U;
}

static void MessageStore_CacheAppend(uint32_t sequence, const char *text, uint8_t len,
                                     uint8_t source, uint8_t destination)
{
  uint8_t index;

  if (message_store_count < MESSAGE_STORE_VISIBLE_COUNT)
  {
    index = message_store_count;
    message_store_count++;
  }
  else
  {
    for (uint8_t i = 1U; i < MESSAGE_STORE_VISIBLE_COUNT; i++)
    {
      message_store_cache[i - 1U] = message_store_cache[i];
    }
    index = MESSAGE_STORE_VISIBLE_COUNT - 1U;
  }

  message_store_cache[index].sequence = sequence;
  message_store_cache[index].len = len;
  message_store_cache[index].source = source;
  message_store_cache[index].destination = destination;
  memcpy(message_store_cache[index].text, text, len);
  message_store_cache[index].text[len] = '\0';
  message_store_view_index = message_store_count - 1U;
}

static void MessageStore_BuildRecord(MessageStoreRecord *record, uint32_t sequence,
                                     const char *text, uint8_t len,
                                     uint8_t source, uint8_t destination)
{
  memset(record, 0, sizeof(*record));
  record->magic = MESSAGE_STORE_MAGIC;
  record->sequence = sequence;
  record->length = (uint32_t)len |
                   ((uint32_t)(source & 0x03U) << MESSAGE_STORE_SOURCE_SHIFT) |
                   ((uint32_t)(destination & 0x03U) << MESSAGE_STORE_DEST_SHIFT);
  memcpy(record->text, text, len);
  record->hash = MessageStore_HashRecord(record);
  record->commit = MESSAGE_STORE_COMMIT;
}
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
int main(void)
{
  PowerKill_EarlyKeepAlive();

  HAL_Init();
  SystemClock_Config();

  MX_GPIO_Init();
  MX_DMA_Init();
  MX_ADC1_Init();
  MX_I2C3_Init();
  MX_SPI1_Init();
  MX_TIM2_Init();
  MX_TIM3_Init();
  MX_USART2_UART_Init();

  DAC_Write12(TX_DAC_MID_CODE);
  rx_pga_gain_code = RX_PGA_DEFAULT_GAIN_CODE;
  PGA_SetGain(rx_pga_gain_code);

  FSK_Init();
  RS_Init();
  MessageStore_Init();
  HAL_Delay(300U);
  if (OLED_Init() != 0U)
  {
    OLED_ShowStartupScreen();
    HAL_Delay(2000U);
  }
  OLED_PrintMode();

  printf("\r\nThree-mode 4-FSK RX/TX start\r\n");
  printf("SELECT MODE: A=STANDARD, B=MULTI-NODE (no calibration + PGA x2), C=HIDDEN (high-frequency + calibration)\r\n");
  printf("HALF DUPLEX: RX PC4 via MCP6S21, TX MCP4921 DAC; select mode first, then *=RX/TX\r\n");
  printf("CLOCK: 25MHz HSE -> 96MHz PLL, TIM2 ADC=16kHz NORMAL/20kHz HIDDEN, TIM3 DAC=32kHz\r\n");
  printf("SPI1 MODE0 6MHz: SCK PA5, MOSI PA7, DAC_CS PB0, PGA_CS PA6\r\n");
  printf("POWER: LTC2950 PB9=INT# active low, PC1=KILL; AMP_MUTE PB12 active high\r\n");
  printf("KEYPAD: 1 2 3 A / 4 5 6 B / 7 8 9 C / * 0 # D\r\n");
  printf("TX EDITOR: phone multi-tap, A=LEFT B=RIGHT C=DELETE D=CLEAR *=RX/TX; STANDARD/HIDDEN first #=CAL, MULTI #=SEND\r\n");
  printf("MULTI-NODE: no calibration, PGA fixed x2; in RX press 1/2/3=set local ID, D=cycle destination ALL/N1/N2/N3\r\n");
  printf("ROUTING: START0=source ID encoded as 00/01/10, START1=destination 00=ALL 01/10/11=N1/N2/N3\r\n");
  printf("RX PROFILES: STANDARD/MULTI=NORMAL, HIDDEN=HIGH; both communicating boards must select the same mode\r\n");
  printf("STANDARD/HIDDEN CAL PGA: automatic plus RX keys A=down/B=up manual override; auto down requires valid tone (HIGH %u, CLIP %u windows); pass1 auto up/down, pass2 auto down-only\r\n",
         RX_PGA_AGC_HIGH_WINDOWS, RX_PGA_AGC_CLIP_WINDOWS);
  printf("LED3 PB7 active low: on for calibration/message TX, off when idle\r\n");
  printf("RX MEMORY: A=OLDER B=NEWER C=LATEST, saved=%u/5; BLUE LED=RX COMPLETE\r\n",
         message_store_count);
  printf("ADC windows: NORMAL=%uHz/%u samples, HIDDEN=%uHz/%u samples, symbol=%ums\r\n",
         FSK_NORMAL_FS_HZ, FSK_NORMAL_SYMBOL_SAMPLES,
         FSK_HIDDEN_FS_HZ, FSK_HIDDEN_SYMBOL_SAMPLES, FSK_SYMBOL_MS);
  printf("FEC: %ux RS(%u,%u) GF(64), payload=%u chars + CRC12/%u symbols, parity=%u, t=%u per block/%u total\r\n",
         RS_BLOCK_COUNT, RS_CODEWORD_SYMBOLS, RS_DATA_SYMBOLS, MESSAGE_MAX_LEN,
         MESSAGE_CRC_SYMBOLS,
         RS_TOTAL_PARITY_SYMBOLS, RS_CORRECTABLE_SYMBOLS, RS_TOTAL_CORRECTABLE);
  printf("FEC erasures: known codeword positions retained; each block decodes 2*errors+erasures<=%u\r\n",
         RS_PARITY_SYMBOLS);
  printf("FEC GMD: failed blocks retry with least-reliable RS symbols, up to %u total erasures/block\r\n",
         RS_PARITY_SYMBOLS);
  printf("CRC12: 0x80F over source+destination+all %u padded text symbols; CRC guides GMD candidate selection\r\n",
         MESSAGE_MAX_LEN);
  printf("FSK whitening: ON, mask cycle=00/01/10/11\r\n");
  printf("FSK NORMAL: data=%u/%u/%u/%uHz sync=%uHz\r\n",
         fsk_normal_freqs_hz[0], fsk_normal_freqs_hz[1], fsk_normal_freqs_hz[2], fsk_normal_freqs_hz[3],
         fsk_normal_freqs_hz[FSK_SYNC_SYMBOL]);
  printf("FSK HIDDEN: data=%u/%u/%u/%uHz sync=%uHz\r\n",
         fsk_high_freqs_hz[0], fsk_high_freqs_hz[1], fsk_high_freqs_hz[2], fsk_high_freqs_hz[3],
         fsk_high_freqs_hz[FSK_SYNC_SYMBOL]);
  printf("RS framing marker: %uHz before every 6-bit RS symbol\r\n",
         fsk_tx_freqs_hz[FSK_SYNC_SYMBOL]);
  printf("TX timing: %u tones, %u+%u=%ums each, frame=%ums\r\n",
         TX_FRAME_MAX_SYMBOLS, TX_TONE_MS, TX_GAP_MS, TX_STEP_MS, TX_FRAME_DURATION_MS);
  printf("RS capture: all valid 20ms windows; slots=40..139/140..199/200..259ms\r\n");
  printf("RX adapt: timed PREAMBLE recovery + per-data-bin soft fallback + END soft/repeat guard\r\n");
  printf("RX scale: PREAMBLE top2 mean / qualified top1 fallback + bounded frame sqrt correction (0.5x..2.0x)\r\n");
  printf("STANDARD/HIDDEN CAL: first # sends 00/01/10/11 as %u+%ums bursts for %ums each\r\n",
         TX_TONE_MS, TX_GAP_MS, CALIBRATION_STAGE_MS);
  printf("CAL RX: profile-fixed %u/%u/%u/%uHz Goertzel, %u-window mean energy\r\n",
         fsk_tx_freqs_hz[0], fsk_tx_freqs_hz[1], fsk_tx_freqs_hz[2], fsk_tx_freqs_hz[3],
         CALIBRATION_ENERGY_WINDOWS);
  printf("RS errors+erasures+GMD self-test (5e, 10s, 3e+4s, 6e->2s): %s\r\n",
         (RS_SelfTest() != 0U) ? "PASS" : "FAIL");
  printf("CRC12 self-test (text=0x708, N1->N2 addressed=0x780): %s\r\n",
         (Message_CrcSelfTest() != 0U) ? "PASS" : "FAIL");

  if (HAL_TIM_Base_Start_IT(&htim3) != HAL_OK)
  {
    Error_Handler();
  }

  HAL_GPIO_WritePin(AMP_MUTE_GPIO_Port, AMP_MUTE_Pin, AMP_MUTE_ON);

  printf("receiver paused until mode selection\r\n");
  OLED_PrintMode();

  while (1)
  {
    StatusLed_Update();
    Keypad_Task();
    Editor_Task();
    PowerInt_Task();
    OLED_RetryInitTask();

    if ((symbol_ready != 0U) && (rx_sampling_active != 0U))
    {
      uint16_t start;

      __disable_irq();
      start = symbol_start_index;
      symbol_ready = 0U;
      __enable_irq();

      FSK_ProcessSymbol(&adc_dma_buf[start]);
    }

    MessageStore_Task();
    TX_UI_Task();
    HalfDuplex_Task();
  }
}

void SystemClock_Config(void)
{
  RCC_OscInitTypeDef RCC_OscInitStruct = {0};
  RCC_ClkInitTypeDef RCC_ClkInitStruct = {0};

  __HAL_RCC_PWR_CLK_ENABLE();
  __HAL_PWR_VOLTAGESCALING_CONFIG(PWR_REGULATOR_VOLTAGE_SCALE1);

  /* X5 is a 25 MHz crystal.  Run the core and both audio timers from the
     crystal-derived 96 MHz PLL so separate boards share a ppm-class timebase. */
  RCC_OscInitStruct.OscillatorType = RCC_OSCILLATORTYPE_HSE;
  RCC_OscInitStruct.HSEState = RCC_HSE_ON;
  RCC_OscInitStruct.PLL.PLLState = RCC_PLL_ON;
  RCC_OscInitStruct.PLL.PLLSource = RCC_PLLSOURCE_HSE;
  RCC_OscInitStruct.PLL.PLLM = 25U;
  RCC_OscInitStruct.PLL.PLLN = 192U;
  RCC_OscInitStruct.PLL.PLLP = RCC_PLLP_DIV2;
  RCC_OscInitStruct.PLL.PLLQ = 4U;
  if (HAL_RCC_OscConfig(&RCC_OscInitStruct) != HAL_OK)
  {
    Error_Handler();
  }

  RCC_ClkInitStruct.ClockType = RCC_CLOCKTYPE_HCLK | RCC_CLOCKTYPE_SYSCLK |
                                RCC_CLOCKTYPE_PCLK1 | RCC_CLOCKTYPE_PCLK2;
  RCC_ClkInitStruct.SYSCLKSource = RCC_SYSCLKSOURCE_PLLCLK;
  RCC_ClkInitStruct.AHBCLKDivider = RCC_SYSCLK_DIV1;
  RCC_ClkInitStruct.APB1CLKDivider = RCC_HCLK_DIV2;
  RCC_ClkInitStruct.APB2CLKDivider = RCC_HCLK_DIV1;

  if (HAL_RCC_ClockConfig(&RCC_ClkInitStruct, FLASH_LATENCY_3) != HAL_OK)
  {
    Error_Handler();
  }
}

static void MX_ADC1_Init(void)
{
  ADC_ChannelConfTypeDef sConfig = {0};

  hadc1.Instance = ADC1;
  hadc1.Init.ClockPrescaler = ADC_CLOCK_SYNC_PCLK_DIV4;
  hadc1.Init.Resolution = ADC_RESOLUTION_12B;
  hadc1.Init.ScanConvMode = DISABLE;
  hadc1.Init.ContinuousConvMode = DISABLE;
  hadc1.Init.DiscontinuousConvMode = DISABLE;
  hadc1.Init.ExternalTrigConvEdge = ADC_EXTERNALTRIGCONVEDGE_RISING;
  hadc1.Init.ExternalTrigConv = ADC_EXTERNALTRIGCONV_T2_TRGO;
  hadc1.Init.DataAlign = ADC_DATAALIGN_RIGHT;
  hadc1.Init.NbrOfConversion = 1;
  hadc1.Init.DMAContinuousRequests = ENABLE;
  hadc1.Init.EOCSelection = ADC_EOC_SINGLE_CONV;
  if (HAL_ADC_Init(&hadc1) != HAL_OK)
  {
    Error_Handler();
  }

  sConfig.Channel = ADC_CHANNEL_14; /* PC4 */
  sConfig.Rank = 1;
  sConfig.SamplingTime = ADC_SAMPLETIME_84CYCLES;
  if (HAL_ADC_ConfigChannel(&hadc1, &sConfig) != HAL_OK)
  {
    Error_Handler();
  }
}

static void MX_I2C3_Init(void)
{
  hi2c3.Instance = I2C3;
  hi2c3.Init.ClockSpeed = 100000;
  hi2c3.Init.DutyCycle = I2C_DUTYCYCLE_2;
  hi2c3.Init.OwnAddress1 = 0;
  hi2c3.Init.AddressingMode = I2C_ADDRESSINGMODE_7BIT;
  hi2c3.Init.DualAddressMode = I2C_DUALADDRESS_DISABLE;
  hi2c3.Init.OwnAddress2 = 0;
  hi2c3.Init.GeneralCallMode = I2C_GENERALCALL_DISABLE;
  hi2c3.Init.NoStretchMode = I2C_NOSTRETCH_DISABLE;
  if (HAL_I2C_Init(&hi2c3) != HAL_OK)
  {
    Error_Handler();
  }
}

static void MX_SPI1_Init(void)
{
  hspi1.Instance = SPI1;
  hspi1.Init.Mode = SPI_MODE_MASTER;
  hspi1.Init.Direction = SPI_DIRECTION_1LINE;
  hspi1.Init.DataSize = SPI_DATASIZE_8BIT;
  hspi1.Init.CLKPolarity = SPI_POLARITY_LOW;
  hspi1.Init.CLKPhase = SPI_PHASE_1EDGE;
  hspi1.Init.NSS = SPI_NSS_SOFT;
  hspi1.Init.BaudRatePrescaler = SPI_BAUDRATEPRESCALER_16;
  hspi1.Init.FirstBit = SPI_FIRSTBIT_MSB;
  hspi1.Init.TIMode = SPI_TIMODE_DISABLE;
  hspi1.Init.CRCCalculation = SPI_CRCCALCULATION_DISABLE;
  hspi1.Init.CRCPolynomial = 10U;
  if (HAL_SPI_Init(&hspi1) != HAL_OK)
  {
    Error_Handler();
  }
  SPI_1LINE_TX(&hspi1);
  __HAL_SPI_ENABLE(&hspi1);
}

static void MX_TIM2_Init(void)
{
  TIM_ClockConfigTypeDef sClockSourceConfig = {0};
  TIM_MasterConfigTypeDef sMasterConfig = {0};

  htim2.Instance = TIM2;
  htim2.Init.Prescaler = 5U;
  htim2.Init.CounterMode = TIM_COUNTERMODE_UP;
  htim2.Init.Period = 999;
  htim2.Init.ClockDivision = TIM_CLOCKDIVISION_DIV1;
  htim2.Init.AutoReloadPreload = TIM_AUTORELOAD_PRELOAD_DISABLE;
  if (HAL_TIM_Base_Init(&htim2) != HAL_OK)
  {
    Error_Handler();
  }

  sClockSourceConfig.ClockSource = TIM_CLOCKSOURCE_INTERNAL;
  if (HAL_TIM_ConfigClockSource(&htim2, &sClockSourceConfig) != HAL_OK)
  {
    Error_Handler();
  }

  sMasterConfig.MasterOutputTrigger = TIM_TRGO_UPDATE;
  sMasterConfig.MasterSlaveMode = TIM_MASTERSLAVEMODE_DISABLE;
  if (HAL_TIMEx_MasterConfigSynchronization(&htim2, &sMasterConfig) != HAL_OK)
  {
    Error_Handler();
  }
}

static void MX_TIM3_Init(void)
{
  htim3.Instance = TIM3;
  htim3.Init.Prescaler = 5U;
  htim3.Init.CounterMode = TIM_COUNTERMODE_UP;
  htim3.Init.Period = 499U;
  htim3.Init.ClockDivision = TIM_CLOCKDIVISION_DIV1;
  htim3.Init.AutoReloadPreload = TIM_AUTORELOAD_PRELOAD_DISABLE;
  if (HAL_TIM_Base_Init(&htim3) != HAL_OK)
  {
    Error_Handler();
  }
}

static void MX_USART2_UART_Init(void)
{
  huart2.Instance = USART2;
  huart2.Init.BaudRate = 115200;
  huart2.Init.WordLength = UART_WORDLENGTH_8B;
  huart2.Init.StopBits = UART_STOPBITS_1;
  huart2.Init.Parity = UART_PARITY_NONE;
  huart2.Init.Mode = UART_MODE_TX_RX;
  huart2.Init.HwFlowCtl = UART_HWCONTROL_NONE;
  huart2.Init.OverSampling = UART_OVERSAMPLING_16;
  if (HAL_UART_Init(&huart2) != HAL_OK)
  {
    Error_Handler();
  }
}

static void MX_DMA_Init(void)
{
  __HAL_RCC_DMA2_CLK_ENABLE();

  HAL_NVIC_SetPriority(DMA2_Stream0_IRQn, 0, 0);
  HAL_NVIC_EnableIRQ(DMA2_Stream0_IRQn);
}

static void MX_GPIO_Init(void)
{
  GPIO_InitTypeDef GPIO_InitStruct = {0};

  __HAL_RCC_GPIOH_CLK_ENABLE();
  __HAL_RCC_GPIOA_CLK_ENABLE();
  __HAL_RCC_GPIOB_CLK_ENABLE();
  __HAL_RCC_GPIOC_CLK_ENABLE();
  __HAL_RCC_GPIOD_CLK_ENABLE();

  HAL_GPIO_WritePin(BOARD_LED_GPIO_Port, BOARD_LED_Pin, BOARD_LED_OFF);
  HAL_GPIO_WritePin(TX_LED_GPIO_Port, TX_LED_Pin, TX_LED_OFF);
  HAL_GPIO_WritePin(AMP_MUTE_GPIO_Port, AMP_MUTE_Pin, AMP_MUTE_ON);
  HAL_GPIO_WritePin(POWER_KILL_GPIO_Port, POWER_KILL_Pin, POWER_KILL_KEEP_ON);
  HAL_GPIO_WritePin(DAC_CS_GPIO_Port, DAC_CS_Pin, DAC_CS_INACTIVE);
  HAL_GPIO_WritePin(PGA_CS_GPIO_Port, PGA_CS_Pin, PGA_CS_INACTIVE);
  HAL_GPIO_WritePin(GPIOB, GPIO_PIN_3 | GPIO_PIN_4 | GPIO_PIN_5, GPIO_PIN_SET);
  HAL_GPIO_WritePin(GPIOD, GPIO_PIN_2, GPIO_PIN_SET);

  GPIO_InitStruct.Pin = BOARD_LED_Pin;
  GPIO_InitStruct.Mode = GPIO_MODE_OUTPUT_PP;
  GPIO_InitStruct.Pull = GPIO_NOPULL;
  GPIO_InitStruct.Speed = GPIO_SPEED_FREQ_LOW;
  HAL_GPIO_Init(BOARD_LED_GPIO_Port, &GPIO_InitStruct);

  GPIO_InitStruct.Pin = TX_LED_Pin;
  HAL_GPIO_Init(TX_LED_GPIO_Port, &GPIO_InitStruct);

  GPIO_InitStruct.Pin = AMP_MUTE_Pin;
  GPIO_InitStruct.Mode = GPIO_MODE_OUTPUT_PP;
  GPIO_InitStruct.Pull = GPIO_NOPULL;
  GPIO_InitStruct.Speed = GPIO_SPEED_FREQ_LOW;
  HAL_GPIO_Init(AMP_MUTE_GPIO_Port, &GPIO_InitStruct);

  GPIO_InitStruct.Pin = DAC_CS_Pin;
  GPIO_InitStruct.Mode = GPIO_MODE_OUTPUT_PP;
  GPIO_InitStruct.Pull = GPIO_NOPULL;
  GPIO_InitStruct.Speed = GPIO_SPEED_FREQ_VERY_HIGH;
  HAL_GPIO_Init(DAC_CS_GPIO_Port, &GPIO_InitStruct);

  GPIO_InitStruct.Pin = PGA_CS_Pin;
  HAL_GPIO_Init(PGA_CS_GPIO_Port, &GPIO_InitStruct);

  GPIO_InitStruct.Pin = POWER_KILL_Pin;
  GPIO_InitStruct.Mode = GPIO_MODE_OUTPUT_PP;
  GPIO_InitStruct.Pull = GPIO_NOPULL;
  GPIO_InitStruct.Speed = GPIO_SPEED_FREQ_LOW;
  HAL_GPIO_Init(POWER_KILL_GPIO_Port, &GPIO_InitStruct);

  GPIO_InitStruct.Pin = POWER_INT_Pin;
  GPIO_InitStruct.Mode = GPIO_MODE_INPUT;
  GPIO_InitStruct.Pull = GPIO_NOPULL;
  HAL_GPIO_Init(POWER_INT_GPIO_Port, &GPIO_InitStruct);

  GPIO_InitStruct.Pin = GPIO_PIN_3 | GPIO_PIN_4 | GPIO_PIN_5;
  GPIO_InitStruct.Mode = GPIO_MODE_OUTPUT_OD;
  GPIO_InitStruct.Pull = GPIO_PULLUP;
  GPIO_InitStruct.Speed = GPIO_SPEED_FREQ_LOW;
  HAL_GPIO_Init(GPIOB, &GPIO_InitStruct);

  GPIO_InitStruct.Pin = GPIO_PIN_2;
  HAL_GPIO_Init(GPIOD, &GPIO_InitStruct);

  GPIO_InitStruct.Pin = GPIO_PIN_15;
  GPIO_InitStruct.Mode = GPIO_MODE_INPUT;
  GPIO_InitStruct.Pull = GPIO_PULLUP;
  HAL_GPIO_Init(GPIOA, &GPIO_InitStruct);

  GPIO_InitStruct.Pin = GPIO_PIN_10 | GPIO_PIN_11 | GPIO_PIN_12;
  HAL_GPIO_Init(GPIOC, &GPIO_InitStruct);
}

void Error_Handler(void)
{
  __disable_irq();
  while (1)
  {
    HAL_GPIO_TogglePin(BOARD_LED_GPIO_Port, BOARD_LED_Pin);
    HAL_Delay(100);
  }
}

#ifdef USE_FULL_ASSERT
void assert_failed(uint8_t *file, uint32_t line)
{
  (void)file;
  (void)line;
}
#endif
