epidimobife96-rgb/shengyu-xinshi/software/stm32_second_board/Core/Inc/main.h

#define BOARD_LED_Pin GPIO_PIN_13
#define BOARD_LED_GPIO_Port GPIOC
#define BOARD_LED_ON GPIO_PIN_RESET
#define BOARD_LED_OFF GPIO_PIN_SET
#define TX_LED_Pin GPIO_PIN_7
#define TX_LED_GPIO_Port GPIOB
#define TX_LED_ON GPIO_PIN_RESET
#define TX_LED_OFF GPIO_PIN_SET
#define AMP_MUTE_Pin GPIO_PIN_12
#define AMP_MUTE_GPIO_Port GPIOB
#define AMP_ENABLE GPIO_PIN_RESET
#define AMP_MUTE_ON GPIO_PIN_SET
#define DAC_CS_Pin GPIO_PIN_0
#define DAC_CS_GPIO_Port GPIOB
#define DAC_CS_ACTIVE GPIO_PIN_RESET
#define DAC_CS_INACTIVE GPIO_PIN_SET
#define PGA_CS_Pin GPIO_PIN_6
#define PGA_CS_GPIO_Port GPIOA
#define PGA_CS_ACTIVE GPIO_PIN_RESET
#define PGA_CS_INACTIVE GPIO_PIN_SET
#define POWER_KILL_Pin GPIO_PIN_1
#define POWER_KILL_GPIO_Port GPIOC
#define POWER_KILL_KEEP_ON GPIO_PIN_SET
#define POWER_KILL_POWER_OFF GPIO_PIN_RESET
#define POWER_INT_Pin GPIO_PIN_9
#define POWER_INT_GPIO_Port GPIOB
#define POWER_INT_ASSERTED GPIO_PIN_RESET
#define POWER_INT_RELEASED GPIO_PIN_SET
