epidimobife96-rgb/shengyu-xinshi/software/stm32_receive/Core/Src/main.c

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
/* Includes ------------------------------------------------------------------*/
#include "main.h"

/* USER CODE BEGIN Includes */
#include <stdio.h>
#include <string.h>
#include <math.h>
#if defined(__ARMCC_VERSION)
#include <rt_sys.h>
#endif
/* USER CODE END Includes */

/* USER CODE BEGIN Semihosting */
extern UART_HandleTypeDef huart2;

#if defined(__ARMCC_VERSION) && !defined(__CC_ARM)
__asm(".global __use_no_semihosting\n");
#endif

#if defined(__CC_ARM)
#pragma import(__use_no_semihosting)
#endif

#if defined(__CC_ARM) || defined(__ARMCC_VERSION)
void _ttywrch(int ch)
{
  (void)ch;
}

void _sys_exit(int status)
{
  (void)status;
  while (1)
  {
  }
}

FILEHANDLE _sys_open(const char *name, int openmode)
{
  (void)name;
  (void)openmode;
  return 1;
}

int _sys_close(FILEHANDLE fh)
{
  (void)fh;
  return 0;
}

int _sys_write(FILEHANDLE fh, const unsigned char *buf, unsigned len, int mode)
{
  (void)fh;
  (void)mode;
  HAL_UART_Transmit(&huart2, (uint8_t *)buf, (uint16_t)len, HAL_MAX_DELAY);
  return 0;
}

int _sys_read(FILEHANDLE fh, unsigned char *buf, unsigned len, int mode)
{
  (void)fh;
  (void)buf;
  (void)len;
  (void)mode;
  return 0;
}

int _sys_istty(FILEHANDLE fh)
{
  (void)fh;
  return 1;
}

int _sys_seek(FILEHANDLE fh, long pos)
{
  (void)fh;
  (void)pos;
  return -1;
}

long _sys_flen(FILEHANDLE fh)
{
  (void)fh;
  return -1;
}

int ferror(FILE *f)
{
  (void)f;
  return 0;
}
#endif
/* USER CODE END Semihosting */

/* USER CODE BEGIN PTD */
typedef struct
{
  uint8_t valid;
  uint16_t freq_hz;
  uint8_t bits;
  float max_energy;
  float second_energy;
} FSK_DetectResult;

typedef struct
{
  uint16_t peak_freq_hz;
  uint16_t second_freq_hz;
  float peak_energy;
  float second_energy;
} FSK_ScanResult;

typedef enum
{
  DIGIT_RX_SEARCH = 0,
  DIGIT_RX_START_0,
  DIGIT_RX_START_1,
  DIGIT_RX_DATA_0,
  DIGIT_RX_DATA_1,
  DIGIT_RX_CHECK_0,
  DIGIT_RX_CHECK_1,
  DIGIT_RX_END_0,
  DIGIT_RX_END_1
} DigitRxState;
/* USER CODE END PTD */

/* USER CODE BEGIN PD */
#define FSK_FS_HZ                 16000U
#define FSK_SYMBOL_MS             20U
#define FSK_SYMBOL_SAMPLES        ((FSK_FS_HZ * FSK_SYMBOL_MS) / 1000U)
#define ADC_DMA_BUFFER_SAMPLES    (FSK_SYMBOL_SAMPLES * 2U)

#define FSK_FREQ_COUNT            4U
#define FSK_RX_FREQ_00_HZ         1500U
#define FSK_RX_FREQ_01_HZ         2500U
#define FSK_RX_FREQ_10_HZ         3500U
#define FSK_RX_FREQ_11_HZ         4500U
#define FSK_ENERGY_THRESHOLD      5000000.0f
#define FSK_RATIO_THRESHOLD       1.3f
#define FSK_NOISE_MULTIPLIER      3.0f
#define FSK_NOISE_MIN_FLOOR       3000000.0f
#define OLED_IDLE_UPDATE_MS       1000U
#define DEBUG_UART_ENABLE         1U
#define UART_IDLE_LOG_MS          1000U
#define FSK_SCAN_DEBUG_ENABLE     0U
#define FSK_SCAN_MIN_HZ           800U
#define FSK_SCAN_MAX_HZ           6000U
#define FSK_SCAN_STEP_HZ          25U
#define FSK_SCAN_LOG_MS           500U
#define FSK_SCAN_BIN_COUNT        (((FSK_SCAN_MAX_HZ - FSK_SCAN_MIN_HZ) / FSK_SCAN_STEP_HZ) + 1U)
#define FSK_PI                    3.14159265358979323846f
#define DIGIT_STABLE_WINDOWS      2U
#define DIGIT_GAP_INVALID_WINDOWS 2U
#define DIGIT_FRAME_TIMEOUT_MS    5000U
#define DIGIT_NO_SYMBOL           0xFFU
#define DIGIT_PREAMBLE_LEN        4U
#define DIGIT_START_LEN           2U
#define DIGIT_END_LEN             2U

#define OLED_I2C_ADDR_3C          (0x3CU << 1)
#define OLED_I2C_ADDR_3D          (0x3DU << 1)
#define OLED_WIDTH                128U
#define OLED_HEIGHT               64U
#define OLED_PAGES                (OLED_HEIGHT / 8U)
/* USER CODE END PD */

ADC_HandleTypeDef hadc1;
DMA_HandleTypeDef hdma_adc1;
I2C_HandleTypeDef hi2c3;
TIM_HandleTypeDef htim2;
UART_HandleTypeDef huart2;

/* USER CODE BEGIN PV */
static uint16_t adc_dma_buf[ADC_DMA_BUFFER_SAMPLES];
static volatile uint8_t symbol_ready = 0U;
static volatile uint16_t symbol_start_index = 0U;

static const uint16_t fsk_freqs_hz[FSK_FREQ_COUNT] = {
  FSK_RX_FREQ_00_HZ,
  FSK_RX_FREQ_01_HZ,
  FSK_RX_FREQ_10_HZ,
  FSK_RX_FREQ_11_HZ
};
static const uint8_t fsk_bits[FSK_FREQ_COUNT] = {0x00U, 0x01U, 0x02U, 0x03U};
static const uint8_t digit_codebook[10][2] = {
  {0x00U, 0x01U}, /* 0 */
  {0x00U, 0x02U}, /* 1 */
  {0x00U, 0x03U}, /* 2 */
  {0x01U, 0x00U}, /* 3 */
  {0x01U, 0x02U}, /* 4 */
  {0x01U, 0x03U}, /* 5 */
  {0x02U, 0x00U}, /* 6 */
  {0x02U, 0x01U}, /* 7 */
  {0x02U, 0x03U}, /* 8 */
  {0x03U, 0x00U}  /* 9 */
};
static const uint8_t digit_preamble[DIGIT_PREAMBLE_LEN] = {0x00U, 0x01U, 0x02U, 0x03U};
static const uint8_t digit_start[DIGIT_START_LEN] = {0x01U, 0x02U};
static const uint8_t digit_end[DIGIT_END_LEN] = {0x02U, 0x03U};
static float fsk_goertzel_coeffs[FSK_FREQ_COUNT];
#if FSK_SCAN_DEBUG_ENABLE
static uint16_t fsk_scan_freqs_hz[FSK_SCAN_BIN_COUNT];
static float fsk_scan_coeffs[FSK_SCAN_BIN_COUNT];
static FSK_ScanResult fsk_last_scan = {0};
#endif
static uint16_t oled_i2c_addr = OLED_I2C_ADDR_3C;
static uint8_t oled_ready = 0U;
static float fsk_noise_floor[FSK_FREQ_COUNT] = {
  FSK_NOISE_MIN_FLOOR,
  FSK_NOISE_MIN_FLOOR,
  FSK_NOISE_MIN_FLOOR,
  FSK_NOISE_MIN_FLOOR
};
static uint8_t digit_candidate_bits = DIGIT_NO_SYMBOL;
static uint8_t digit_candidate_count = 0U;
static uint8_t digit_invalid_count = 0U;
static uint8_t digit_run_active = 0U;
static uint8_t digit_run_bits = DIGIT_NO_SYMBOL;
static DigitRxState digit_rx_state = DIGIT_RX_SEARCH;
static uint8_t digit_preamble_index = 0U;
static uint8_t digit_data_bits[2] = {DIGIT_NO_SYMBOL, DIGIT_NO_SYMBOL};
static uint8_t digit_frame_error = 0U;
static uint32_t digit_frame_tick = 0U;
static uint8_t digit_last_valid = 0U;
static uint8_t digit_last_value = 0U;
static uint32_t digit_display_seq = 0U;
static uint8_t uart_log_event = 0U;
static const char *uart_log_text = "";
static uint8_t uart_log_digit_valid = 0U;
static uint8_t uart_log_digit_value = 0U;
static uint8_t uart_log_expected_bits = DIGIT_NO_SYMBOL;
static uint8_t uart_log_got_bits = DIGIT_NO_SYMBOL;
static uint8_t uart_log_data_bits[2] = {DIGIT_NO_SYMBOL, DIGIT_NO_SYMBOL};
/* USER CODE END PV */

void SystemClock_Config(void);
static void MX_GPIO_Init(void);
static void MX_DMA_Init(void);
static void MX_ADC1_Init(void);
static void MX_I2C3_Init(void);
static void MX_TIM2_Init(void);
static void MX_USART2_UART_Init(void);
/* USER CODE BEGIN PFP */
static void FSK_Init(void);
static float FSK_WindowMean(const uint16_t *samples, uint16_t len);
static float Goertzel_EnergyWithMean(const uint16_t *samples, uint16_t len, float coeff, float mean);
static float Goertzel_Energy(const uint16_t *samples, uint16_t len, float coeff);
static FSK_DetectResult FSK_DetectSymbol(const uint16_t *samples, uint16_t len);
#if FSK_SCAN_DEBUG_ENABLE
static FSK_ScanResult FSK_ScanPeak(const uint16_t *samples, uint16_t len);
#endif
static void FSK_ProcessSymbol(const uint16_t *samples);
static const char *FSK_BitsToString(uint8_t bits);
static void DigitRx_Process(const FSK_DetectResult *result, uint32_t now);
static void DigitRx_AcceptSymbol(uint8_t bits, uint32_t now);
static int8_t DigitRx_DecodePair(uint8_t first_bits, uint8_t second_bits);
static void DigitRx_ResetFrame(void);
static void DigitRx_LogEvent(const char *text);
static void DigitRx_LogFailure(const char *text, uint8_t got_bits, uint8_t expected_bits);
static void DigitRx_LogDigit(uint8_t digit);

static uint8_t OLED_Init(void);
static void OLED_Clear(void);
static void OLED_WriteCommand(uint8_t command);
static void OLED_WriteData(const uint8_t *data, uint16_t len);
static void OLED_SetCursor(uint8_t col, uint8_t page);
static void OLED_PrintAt(uint8_t col, uint8_t page, const char *text);
static void OLED_PrintChar(char ch);
static const uint8_t *OLED_Font5x7(char ch);
static void OLED_PrintDetected(const FSK_DetectResult *result);
static void StatusLed_Update(void);
/* USER CODE END PFP */

/* USER CODE BEGIN 0 */
static void FSK_Init(void)
{
  for (uint8_t i = 0U; i < FSK_FREQ_COUNT; i++)
  {
    fsk_goertzel_coeffs[i] = 2.0f * cosf((2.0f * FSK_PI * (float)fsk_freqs_hz[i]) / (float)FSK_FS_HZ);
  }

#if FSK_SCAN_DEBUG_ENABLE
  for (uint16_t i = 0U; i < FSK_SCAN_BIN_COUNT; i++)
  {
    uint16_t freq = (uint16_t)(FSK_SCAN_MIN_HZ + (i * FSK_SCAN_STEP_HZ));
    fsk_scan_freqs_hz[i] = freq;
    fsk_scan_coeffs[i] = 2.0f * cosf((2.0f * FSK_PI * (float)freq) / (float)FSK_FS_HZ);
  }
#endif
}

static float FSK_WindowMean(const uint16_t *samples, uint16_t len)
{
  uint32_t sum = 0U;

  for (uint16_t i = 0U; i < len; i++)
  {
    sum += samples[i];
  }

  return (float)sum / (float)len;
}

static float Goertzel_EnergyWithMean(const uint16_t *samples, uint16_t len, float coeff, float mean)
{
  float s0 = 0.0f;
  float s1 = 0.0f;
  float s2 = 0.0f;

  for (uint16_t i = 0U; i < len; i++)
  {
    float x = (float)samples[i] - mean;
    s0 = x + coeff * s1 - s2;
    s2 = s1;
    s1 = s0;
  }

  return (s1 * s1) + (s2 * s2) - (coeff * s1 * s2);
}

static float Goertzel_Energy(const uint16_t *samples, uint16_t len, float coeff)
{
  return Goertzel_EnergyWithMean(samples, len, coeff, FSK_WindowMean(samples, len));
}

static FSK_DetectResult FSK_DetectSymbol(const uint16_t *samples, uint16_t len)
{
  FSK_DetectResult result = {0};
  float energies[FSK_FREQ_COUNT];
  uint8_t max_index = 0U;
  uint8_t second_index = 1U;

  for (uint8_t i = 0U; i < FSK_FREQ_COUNT; i++)
  {
    energies[i] = Goertzel_Energy(samples, len, fsk_goertzel_coeffs[i]);
  }

  if (energies[second_index] > energies[max_index])
  {
    max_index = 1U;
    second_index = 0U;
  }

  for (uint8_t i = 2U; i < FSK_FREQ_COUNT; i++)
  {
    if (energies[i] > energies[max_index])
    {
      second_index = max_index;
      max_index = i;
    }
    else if (energies[i] > energies[second_index])
    {
      second_index = i;
    }
  }

  result.max_energy = energies[max_index];
  result.second_energy = energies[second_index];
  result.freq_hz = fsk_freqs_hz[max_index];
  result.bits = fsk_bits[max_index];

  for (uint8_t i = 0U; i < FSK_FREQ_COUNT; i++)
  {
    float floor = fsk_noise_floor[i];

    if (energies[i] > floor)
    {
      floor = (0.995f * floor) + (0.005f * energies[i]);
    }
    else
    {
      floor = (0.95f * floor) + (0.05f * energies[i]);
    }

    if (floor < FSK_NOISE_MIN_FLOOR)
    {
      floor = FSK_NOISE_MIN_FLOOR;
    }

    fsk_noise_floor[i] = floor;
  }

  if ((result.max_energy > FSK_ENERGY_THRESHOLD) &&
      (result.max_energy > (result.second_energy * FSK_RATIO_THRESHOLD)) &&
      (result.max_energy > (fsk_noise_floor[max_index] * FSK_NOISE_MULTIPLIER)))
  {
    result.valid = 1U;
  }

  return result;
}

#if FSK_SCAN_DEBUG_ENABLE
static FSK_ScanResult FSK_ScanPeak(const uint16_t *samples, uint16_t len)
{
  FSK_ScanResult result = {0};
  float mean = FSK_WindowMean(samples, len);

  for (uint16_t i = 0U; i < FSK_SCAN_BIN_COUNT; i++)
  {
    float energy = Goertzel_EnergyWithMean(samples, len, fsk_scan_coeffs[i], mean);

    if (energy > result.peak_energy)
    {
      result.second_energy = result.peak_energy;
      result.second_freq_hz = result.peak_freq_hz;
      result.peak_energy = energy;
      result.peak_freq_hz = fsk_scan_freqs_hz[i];
    }
    else if (energy > result.second_energy)
    {
      result.second_energy = energy;
      result.second_freq_hz = fsk_scan_freqs_hz[i];
    }
  }

  return result;
}
#endif

static void FSK_ProcessSymbol(const uint16_t *samples)
{
  FSK_DetectResult result = FSK_DetectSymbol(samples, FSK_SYMBOL_SAMPLES);
#if FSK_SCAN_DEBUG_ENABLE
  static uint32_t last_scan_log = 0U;
#else
  static uint32_t last_idle_log = 0U;
#endif
  static uint32_t last_oled_digit_seq = 0U;
  uint32_t now = HAL_GetTick();

#if FSK_SCAN_DEBUG_ENABLE
  fsk_last_scan = FSK_ScanPeak(samples, FSK_SYMBOL_SAMPLES);
#endif

  DigitRx_Process(&result, now);

#if DEBUG_UART_ENABLE
  if (uart_log_event != 0U)
  {
    if (uart_log_digit_valid != 0U)
    {
      printf("%s: DIGIT=%u, DATA=%s %s, Emax=%u, E2=%u, N=%u\r\n",
             uart_log_text,
             uart_log_digit_value,
             FSK_BitsToString(uart_log_data_bits[0]),
             FSK_BitsToString(uart_log_data_bits[1]),
             (unsigned int)result.max_energy,
             (unsigned int)result.second_energy,
             (unsigned int)fsk_noise_floor[result.bits]);
    }
    else if (uart_log_expected_bits != DIGIT_NO_SYMBOL)
    {
      printf("%s: got=%s expected=%s, DATA=%s %s, Emax=%u, E2=%u, N=%u\r\n",
             uart_log_text,
             FSK_BitsToString(uart_log_got_bits),
             FSK_BitsToString(uart_log_expected_bits),
             FSK_BitsToString(uart_log_data_bits[0]),
             FSK_BitsToString(uart_log_data_bits[1]),
             (unsigned int)result.max_energy,
             (unsigned int)result.second_energy,
             (unsigned int)fsk_noise_floor[result.bits]);
    }
    else
    {
      printf("%s: %uHz -> %s, DATA=%s %s, Emax=%u, E2=%u, N=%u\r\n",
             uart_log_text,
             result.freq_hz,
             FSK_BitsToString(result.bits),
             FSK_BitsToString(uart_log_data_bits[0]),
             FSK_BitsToString(uart_log_data_bits[1]),
             (unsigned int)result.max_energy,
             (unsigned int)result.second_energy,
             (unsigned int)fsk_noise_floor[result.bits]);
    }
    uart_log_event = 0U;
    uart_log_digit_valid = 0U;
    uart_log_expected_bits = DIGIT_NO_SYMBOL;
    uart_log_got_bits = DIGIT_NO_SYMBOL;
  }
#if FSK_SCAN_DEBUG_ENABLE
  if ((now - last_scan_log) >= FSK_SCAN_LOG_MS)
  {
    uint32_t peak_k = (uint32_t)(fsk_last_scan.peak_energy / 1000.0f);
    uint32_t second_k = (uint32_t)(fsk_last_scan.second_energy / 1000.0f);
    uint32_t cand_k = (uint32_t)(result.max_energy / 1000.0f);

    last_scan_log = now;
    printf("scan: PK=%uHz E=%luK, S=%uHz E2=%luK, cand=%uHz->%s %s C=%luK\r\n",
           fsk_last_scan.peak_freq_hz,
           (unsigned long)peak_k,
           fsk_last_scan.second_freq_hz,
           (unsigned long)second_k,
           result.freq_hz,
           FSK_BitsToString(result.bits),
           (result.valid != 0U) ? "valid" : "invalid",
           (unsigned long)cand_k);
  }
#else
  else if ((result.valid == 0U) && ((now - last_idle_log) >= UART_IDLE_LOG_MS))
  {
    last_idle_log = now;
    printf("idle: Emax=%u, E2=%u\r\n",
           (unsigned int)result.max_energy,
           (unsigned int)result.second_energy);
  }
#endif
#endif

  if (digit_display_seq != last_oled_digit_seq)
  {
    last_oled_digit_seq = digit_display_seq;
    OLED_PrintDetected(&result);
  }
}

static const char *FSK_BitsToString(uint8_t bits)
{
  static const char *bit_text[FSK_FREQ_COUNT] = {"00", "01", "10", "11"};
  return bit_text[bits & 0x03U];
}

static void DigitRx_LogEvent(const char *text)
{
  uart_log_event = 1U;
  uart_log_text = text;
  uart_log_digit_valid = 0U;
  uart_log_expected_bits = DIGIT_NO_SYMBOL;
  uart_log_got_bits = DIGIT_NO_SYMBOL;
  uart_log_data_bits[0] = digit_data_bits[0];
  uart_log_data_bits[1] = digit_data_bits[1];
}

static void DigitRx_LogFailure(const char *text, uint8_t got_bits, uint8_t expected_bits)
{
  DigitRx_LogEvent(text);
  uart_log_got_bits = got_bits;
  uart_log_expected_bits = expected_bits;
}

static void DigitRx_LogDigit(uint8_t digit)
{
  DigitRx_LogEvent("digit_ok");
  uart_log_digit_valid = 1U;
  uart_log_digit_value = digit;
  digit_display_seq++;
}

static void DigitRx_Process(const FSK_DetectResult *result, uint32_t now)
{
  if ((digit_rx_state != DIGIT_RX_SEARCH) && ((now - digit_frame_tick) > DIGIT_FRAME_TIMEOUT_MS))
  {
    DigitRx_ResetFrame();
  }

  if (result->valid == 0U)
  {
    if (digit_invalid_count < 255U)
    {
      digit_invalid_count++;
    }

    if (digit_invalid_count >= DIGIT_GAP_INVALID_WINDOWS)
    {
      digit_candidate_bits = DIGIT_NO_SYMBOL;
      digit_candidate_count = 0U;
      digit_run_active = 0U;
    }

    return;
  }

  digit_invalid_count = 0U;

  if (digit_candidate_bits == result->bits)
  {
    if (digit_candidate_count < 255U)
    {
      digit_candidate_count++;
    }
  }
  else
  {
    digit_candidate_bits = result->bits;
    digit_candidate_count = 1U;
  }

  if (digit_candidate_count < DIGIT_STABLE_WINDOWS)
  {
    return;
  }

  if ((digit_run_active != 0U) && (digit_run_bits == result->bits))
  {
    return;
  }

  digit_run_active = 1U;
  digit_run_bits = result->bits;
  DigitRx_AcceptSymbol(result->bits, now);
}

static void DigitRx_AcceptSymbol(uint8_t bits, uint32_t now)
{
  digit_frame_tick = now;

  switch (digit_rx_state)
  {
    case DIGIT_RX_SEARCH:
      if (bits == digit_preamble[digit_preamble_index])
      {
        digit_preamble_index++;

        if (digit_preamble_index >= DIGIT_PREAMBLE_LEN)
        {
          digit_preamble_index = 0U;
          digit_rx_state = DIGIT_RX_START_0;
          digit_frame_error = 0U;
          digit_last_valid = 0U;
          DigitRx_LogEvent("preamble");
        }
      }
      else
      {
        digit_preamble_index = (bits == digit_preamble[0]) ? 1U : 0U;
      }
      break;

    case DIGIT_RX_START_0:
      digit_rx_state = (bits == digit_start[0]) ? DIGIT_RX_START_1 : DIGIT_RX_SEARCH;
      if (digit_rx_state == DIGIT_RX_START_1)
      {
        DigitRx_LogEvent("start0");
      }
      else
      {
        DigitRx_LogFailure("start_fail", bits, digit_start[0]);
      }
      break;

    case DIGIT_RX_START_1:
      digit_rx_state = (bits == digit_start[1]) ? DIGIT_RX_DATA_0 : DIGIT_RX_SEARCH;
      if (digit_rx_state == DIGIT_RX_DATA_0)
      {
        DigitRx_LogEvent("start_ok");
      }
      else
      {
        DigitRx_LogFailure("start_fail", bits, digit_start[1]);
      }
      break;

    case DIGIT_RX_DATA_0:
      digit_data_bits[0] = bits;
      digit_rx_state = DIGIT_RX_DATA_1;
      DigitRx_LogEvent("data0");
      break;

    case DIGIT_RX_DATA_1:
      digit_data_bits[1] = bits;
      digit_rx_state = DIGIT_RX_CHECK_0;
      DigitRx_LogEvent("data1");
      break;

    case DIGIT_RX_CHECK_0:
      if (bits == (uint8_t)(digit_data_bits[0] ^ 0x03U))
      {
        digit_rx_state = DIGIT_RX_CHECK_1;
        DigitRx_LogEvent("check0");
      }
      else
      {
        digit_frame_error = 1U;
        DigitRx_LogFailure("check_fail0", bits, (uint8_t)(digit_data_bits[0] ^ 0x03U));
        DigitRx_ResetFrame();
      }
      break;

    case DIGIT_RX_CHECK_1:
      if (bits == (uint8_t)(digit_data_bits[1] ^ 0x03U))
      {
        digit_rx_state = DIGIT_RX_END_0;
        DigitRx_LogEvent("check_ok");
      }
      else
      {
        digit_frame_error = 1U;
        DigitRx_LogFailure("check_fail1", bits, (uint8_t)(digit_data_bits[1] ^ 0x03U));
        DigitRx_ResetFrame();
      }
      break;

    case DIGIT_RX_END_0:
      if (bits == digit_end[0])
      {
        digit_rx_state = DIGIT_RX_END_1;
        DigitRx_LogEvent("end0");
      }
      else
      {
        digit_frame_error = 1U;
        DigitRx_LogFailure("end_fail0", bits, digit_end[0]);
        DigitRx_ResetFrame();
      }
      break;

    case DIGIT_RX_END_1:
      if (bits == digit_end[1])
      {
        int8_t digit = DigitRx_DecodePair(digit_data_bits[0], digit_data_bits[1]);
        if (digit >= 0)
        {
          digit_last_valid = 1U;
          digit_last_value = (uint8_t)digit;
          digit_frame_error = 0U;
          DigitRx_LogDigit((uint8_t)digit);
        }
        else
        {
          digit_frame_error = 1U;
          DigitRx_LogEvent("digit_bad");
        }
      }
      else
      {
        digit_frame_error = 1U;
        DigitRx_LogFailure("end_fail1", bits, digit_end[1]);
      }
      DigitRx_ResetFrame();
      break;

    default:
      DigitRx_ResetFrame();
      break;
  }
}

static int8_t DigitRx_DecodePair(uint8_t first_bits, uint8_t second_bits)
{
  for (uint8_t digit = 0U; digit < 10U; digit++)
  {
    if ((digit_codebook[digit][0] == first_bits) &&
        (digit_codebook[digit][1] == second_bits))
    {
      return (int8_t)digit;
    }
  }

  return -1;
}

static void DigitRx_ResetFrame(void)
{
  digit_rx_state = DIGIT_RX_SEARCH;
  digit_preamble_index = 0U;
  digit_data_bits[0] = DIGIT_NO_SYMBOL;
  digit_data_bits[1] = DIGIT_NO_SYMBOL;
  digit_frame_tick = 0U;
}

void HAL_ADC_ConvHalfCpltCallback(ADC_HandleTypeDef *hadc)
{
  if (hadc->Instance == ADC1)
  {
    symbol_start_index = 0U;
    symbol_ready = 1U;
  }
}

void HAL_ADC_ConvCpltCallback(ADC_HandleTypeDef *hadc)
{
  if (hadc->Instance == ADC1)
  {
    symbol_start_index = FSK_SYMBOL_SAMPLES;
    symbol_ready = 1U;
  }
}

int _write(int file, char *ptr, int len)
{
  (void)file;
  HAL_UART_Transmit(&huart2, (uint8_t *)ptr, (uint16_t)len, HAL_MAX_DELAY);
  return len;
}

int fputc(int ch, FILE *f)
{
  (void)f;
  HAL_UART_Transmit(&huart2, (uint8_t *)&ch, 1U, HAL_MAX_DELAY);
  return ch;
}

static uint8_t OLED_Init(void)
{
  HAL_Delay(100U);

  if (HAL_I2C_IsDeviceReady(&hi2c3, OLED_I2C_ADDR_3C, 3U, 50U) == HAL_OK)
  {
    oled_i2c_addr = OLED_I2C_ADDR_3C;
  }
  else if (HAL_I2C_IsDeviceReady(&hi2c3, OLED_I2C_ADDR_3D, 3U, 50U) == HAL_OK)
  {
    oled_i2c_addr = OLED_I2C_ADDR_3D;
  }
  else
  {
    oled_ready = 0U;
    return 0U;
  }

  oled_ready = 1U;
  OLED_WriteCommand(0xAEU); /* display off */
  OLED_WriteCommand(0x20U); /* memory mode */
  OLED_WriteCommand(0x00U); /* horizontal addressing */
  OLED_WriteCommand(0xB0U);
  OLED_WriteCommand(0xC8U);
  OLED_WriteCommand(0x00U);
  OLED_WriteCommand(0x10U);
  OLED_WriteCommand(0x40U);
  OLED_WriteCommand(0x81U);
  OLED_WriteCommand(0x7FU);
  OLED_WriteCommand(0xA1U);
  OLED_WriteCommand(0xA6U);
  OLED_WriteCommand(0xA8U);
  OLED_WriteCommand(0x3FU);
  OLED_WriteCommand(0xA4U);
  OLED_WriteCommand(0xD3U);
  OLED_WriteCommand(0x00U);
  OLED_WriteCommand(0xD5U);
  OLED_WriteCommand(0x80U);
  OLED_WriteCommand(0xD9U);
  OLED_WriteCommand(0xF1U);
  OLED_WriteCommand(0xDAU);
  OLED_WriteCommand(0x12U);
  OLED_WriteCommand(0xDBU);
  OLED_WriteCommand(0x40U);
  OLED_WriteCommand(0x8DU);
  OLED_WriteCommand(0x14U);
  OLED_WriteCommand(0xAFU); /* display on */
  OLED_Clear();
  OLED_PrintAt(0U, 0U, "DIGIT RX");
  OLED_PrintAt(0U, 2U, "WAIT FRAME");
  return 1U;
}

static void OLED_Clear(void)
{
  uint8_t blank[OLED_WIDTH];
  memset(blank, 0, sizeof(blank));

  for (uint8_t page = 0U; page < OLED_PAGES; page++)
  {
    OLED_SetCursor(0U, page);
    OLED_WriteData(blank, OLED_WIDTH);
  }
}

static void OLED_WriteCommand(uint8_t command)
{
  uint8_t data[2] = {0x00U, command};
  if (oled_ready != 0U)
  {
    (void)HAL_I2C_Master_Transmit(&hi2c3, oled_i2c_addr, data, sizeof(data), 100U);
  }
}

static void OLED_WriteData(const uint8_t *data, uint16_t len)
{
  uint8_t buffer[17];
  buffer[0] = 0x40U;

  if (oled_ready == 0U)
  {
    return;
  }

  while (len > 0U)
  {
    uint16_t chunk = (len > 16U) ? 16U : len;
    memcpy(&buffer[1], data, chunk);
    (void)HAL_I2C_Master_Transmit(&hi2c3, oled_i2c_addr, buffer, (uint16_t)(chunk + 1U), 100U);
    data += chunk;
    len -= chunk;
  }
}

static void OLED_SetCursor(uint8_t col, uint8_t page)
{
  OLED_WriteCommand((uint8_t)(0xB0U + page));
  OLED_WriteCommand((uint8_t)(0x00U + (col & 0x0FU)));
  OLED_WriteCommand((uint8_t)(0x10U + ((col >> 4U) & 0x0FU)));
}

static void OLED_PrintAt(uint8_t col, uint8_t page, const char *text)
{
  OLED_SetCursor(col, page);
  while (*text != '\0')
  {
    OLED_PrintChar(*text++);
  }
}

static void OLED_PrintChar(char ch)
{
  uint8_t glyph[6];
  const uint8_t *font = OLED_Font5x7(ch);

  memcpy(glyph, font, 5U);
  glyph[5] = 0x00U;
  OLED_WriteData(glyph, sizeof(glyph));
}

static const uint8_t *OLED_Font5x7(char ch)
{
  static const uint8_t blank[5] = {0x00U, 0x00U, 0x00U, 0x00U, 0x00U};
  static const uint8_t dash[5] = {0x08U, 0x08U, 0x08U, 0x08U, 0x08U};
  static const uint8_t slash[5] = {0x20U, 0x10U, 0x08U, 0x04U, 0x02U};
  static const uint8_t greater[5] = {0x00U, 0x41U, 0x22U, 0x14U, 0x08U};
  static const uint8_t num0[5] = {0x3EU, 0x51U, 0x49U, 0x45U, 0x3EU};
  static const uint8_t num1[5] = {0x00U, 0x42U, 0x7FU, 0x40U, 0x00U};
  static const uint8_t num2[5] = {0x42U, 0x61U, 0x51U, 0x49U, 0x46U};
  static const uint8_t num3[5] = {0x21U, 0x41U, 0x45U, 0x4BU, 0x31U};
  static const uint8_t num4[5] = {0x18U, 0x14U, 0x12U, 0x7FU, 0x10U};
  static const uint8_t num5[5] = {0x27U, 0x45U, 0x45U, 0x45U, 0x39U};
  static const uint8_t num6[5] = {0x3CU, 0x4AU, 0x49U, 0x49U, 0x30U};
  static const uint8_t num7[5] = {0x01U, 0x71U, 0x09U, 0x05U, 0x03U};
  static const uint8_t num8[5] = {0x36U, 0x49U, 0x49U, 0x49U, 0x36U};
  static const uint8_t num9[5] = {0x06U, 0x49U, 0x49U, 0x29U, 0x1EU};
  static const uint8_t A[5] = {0x7EU, 0x11U, 0x11U, 0x11U, 0x7EU};
  static const uint8_t C[5] = {0x3EU, 0x41U, 0x41U, 0x41U, 0x22U};
  static const uint8_t D[5] = {0x7FU, 0x41U, 0x41U, 0x22U, 0x1CU};
  static const uint8_t E[5] = {0x7FU, 0x49U, 0x49U, 0x49U, 0x41U};
  static const uint8_t F[5] = {0x7FU, 0x09U, 0x09U, 0x09U, 0x01U};
  static const uint8_t G[5] = {0x3EU, 0x41U, 0x49U, 0x49U, 0x7AU};
  static const uint8_t H[5] = {0x7FU, 0x08U, 0x08U, 0x08U, 0x7FU};
  static const uint8_t I[5] = {0x00U, 0x41U, 0x7FU, 0x41U, 0x00U};
  static const uint8_t K[5] = {0x7FU, 0x08U, 0x14U, 0x22U, 0x41U};
  static const uint8_t L[5] = {0x7FU, 0x40U, 0x40U, 0x40U, 0x40U};
  static const uint8_t M[5] = {0x7FU, 0x02U, 0x0CU, 0x02U, 0x7FU};
  static const uint8_t N[5] = {0x7FU, 0x02U, 0x04U, 0x08U, 0x7FU};
  static const uint8_t O[5] = {0x3EU, 0x41U, 0x41U, 0x41U, 0x3EU};
  static const uint8_t R[5] = {0x7FU, 0x09U, 0x19U, 0x29U, 0x46U};
  static const uint8_t S[5] = {0x46U, 0x49U, 0x49U, 0x49U, 0x31U};
  static const uint8_t T[5] = {0x01U, 0x01U, 0x7FU, 0x01U, 0x01U};
  static const uint8_t U[5] = {0x3FU, 0x40U, 0x40U, 0x40U, 0x3FU};
  static const uint8_t V[5] = {0x1FU, 0x20U, 0x40U, 0x20U, 0x1FU};
  static const uint8_t W[5] = {0x7FU, 0x20U, 0x18U, 0x20U, 0x7FU};
  static const uint8_t X[5] = {0x63U, 0x14U, 0x08U, 0x14U, 0x63U};
  static const uint8_t Z[5] = {0x61U, 0x51U, 0x49U, 0x45U, 0x43U};

  switch (ch)
  {
    case ' ': return blank;
    case '-': return dash;
    case '/': return slash;
    case '>': return greater;
    case '0': return num0;
    case '1': return num1;
    case '2': return num2;
    case '3': return num3;
    case '4': return num4;
    case '5': return num5;
    case '6': return num6;
    case '7': return num7;
    case '8': return num8;
    case '9': return num9;
    case 'A': return A;
    case 'C': return C;
    case 'D': return D;
    case 'E': return E;
    case 'F': return F;
    case 'G': return G;
    case 'H': return H;
    case 'I': return I;
    case 'K': return K;
    case 'L': return L;
    case 'M': return M;
    case 'N': return N;
    case 'O': return O;
    case 'R': return R;
    case 'S': return S;
    case 'T': return T;
    case 'U': return U;
    case 'V': return V;
    case 'W': return W;
    case 'X': return X;
    case 'Z': return Z;
    default: return blank;
  }
}

static void OLED_PrintDetected(const FSK_DetectResult *result)
{
  char line[22];

#if FSK_SCAN_DEBUG_ENABLE
  uint32_t peak_k = (uint32_t)(fsk_last_scan.peak_energy / 1000.0f);

  OLED_Clear();
  OLED_PrintAt(0U, 0U, "FSK SCAN");

  (void)snprintf(line, sizeof(line), "PK %uHz", fsk_last_scan.peak_freq_hz);
  OLED_PrintAt(0U, 2U, line);

  (void)snprintf(line, sizeof(line), "E %luK", (unsigned long)peak_k);
  OLED_PrintAt(0U, 4U, line);

  (void)snprintf(line, sizeof(line), "C %uHz %s %c",
                 result->freq_hz,
                 FSK_BitsToString(result->bits),
                 (result->valid != 0U) ? 'V' : '-');
  OLED_PrintAt(0U, 6U, line);
#else
  uint32_t max_k = (uint32_t)(result->max_energy / 1000.0f);
  uint32_t second_k = (uint32_t)(result->second_energy / 1000.0f);

  OLED_Clear();
  OLED_PrintAt(0U, 0U, "DIGIT RX");

  if (digit_last_valid != 0U)
  {
    (void)snprintf(line, sizeof(line), "DIGIT %u", digit_last_value);
    OLED_PrintAt(0U, 2U, line);
  }
  else if (digit_frame_error != 0U)
  {
    OLED_PrintAt(0U, 2U, "CHECK FAIL");
  }
  else if (digit_rx_state != DIGIT_RX_SEARCH)
  {
    if (result->valid != 0U)
    {
      (void)snprintf(line, sizeof(line), "F%u S%s", (uint8_t)digit_rx_state, FSK_BitsToString(result->bits));
    }
    else
    {
      (void)snprintf(line, sizeof(line), "FRAME %u", (uint8_t)digit_rx_state);
    }
    OLED_PrintAt(0U, 2U, line);
  }
  else if (result->valid != 0U)
  {
    (void)snprintf(line, sizeof(line), "SYM %s", FSK_BitsToString(result->bits));
    OLED_PrintAt(0U, 2U, line);
  }
  else
  {
    OLED_PrintAt(0U, 2U, "WAIT");
  }

  (void)snprintf(line, sizeof(line), "MAX %uK", (unsigned int)max_k);
  OLED_PrintAt(0U, 4U, line);

  (void)snprintf(line, sizeof(line), "SEC %uK", (unsigned int)second_k);
  OLED_PrintAt(0U, 6U, line);
#endif
}

static void StatusLed_Update(void)
{
  static uint32_t last_toggle = 0U;
  uint32_t now = HAL_GetTick();
  uint32_t interval = (oled_ready != 0U) ? 500U : 100U;

  if ((now - last_toggle) >= interval)
  {
    last_toggle = now;
    HAL_GPIO_TogglePin(STATUS_LED_GPIO_Port, STATUS_LED_Pin);
  }
}
/* USER CODE END 0 */

/**
  * @brief  The application entry point.
  * @retval int
  */
int main(void)
{

  /* MCU Configuration--------------------------------------------------------*/

  /* Reset of all peripherals, Initializes the Flash interface and the Systick. */
  HAL_Init();

  /* Configure the system clock */
  SystemClock_Config();

  /* Initialize all configured peripherals */
  MX_GPIO_Init();
  MX_DMA_Init();
  MX_ADC1_Init();
  MX_I2C3_Init();
  MX_TIM2_Init();
  MX_USART2_UART_Init();
  /* USER CODE BEGIN 2 */
  FSK_Init();
  (void)OLED_Init();

#if DEBUG_UART_ENABLE
  printf("\r\n4-FSK receiver start\r\n");
  printf("ADC1_IN1 PA1, Fs=%uHz, symbol=%ums, samples=%u\r\n",
         FSK_FS_HZ, FSK_SYMBOL_MS, FSK_SYMBOL_SAMPLES);
  printf("freq: 00=%uHz 01=%uHz 10=%uHz 11=%uHz, frame: preamble/start/data/check/end\r\n",
         FSK_RX_FREQ_00_HZ, FSK_RX_FREQ_01_HZ, FSK_RX_FREQ_10_HZ, FSK_RX_FREQ_11_HZ);
#endif

  if (HAL_ADC_Start_DMA(&hadc1, (uint32_t *)adc_dma_buf, ADC_DMA_BUFFER_SAMPLES) != HAL_OK)
  {
    Error_Handler();
  }

  if (HAL_TIM_Base_Start(&htim2) != HAL_OK)
  {
    Error_Handler();
  }
  /* USER CODE END 2 */

  /* Infinite loop */
  /* USER CODE BEGIN WHILE */
  while (1)
  {
    StatusLed_Update();

    if (symbol_ready != 0U)
    {
      uint16_t start;

      __disable_irq();
      start = symbol_start_index;
      symbol_ready = 0U;
      __enable_irq();

      FSK_ProcessSymbol(&adc_dma_buf[start]);
    }
    /* USER CODE END WHILE */

    /* USER CODE BEGIN 3 */
  }
  /* USER CODE END 3 */
}

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
