epidimobife96-rgb/shengyu-xinshi/(commit log)

2026-06-17 整理声语信使项目资料
    [滤波器设计.ms14]
2026-07-03 Rename 单片机开发.pdf to 短信息编辑器.pdf
    第一版的短信息编辑器，可以正常输出
2026-07-03 更新项目说明和调试文档
2026-07-03 补充整板原理图和发送滤波资料
2026-07-03 更新收发端软件和测试脚本
2026-07-03 补充串口调试原始记录
2026-07-03 补充喇叭滤波器设计文件
    [喇叭滤波器设计.ms14]
2026-07-03 修复接收端滤波器网表
2026-07-03 删除滤波器目录说明文件
2026-07-05 更新短信息编辑器工作日志照片
2026-07-05 第二次工作日志
2026-07-09 添加声语信使板卡第二版工程
2026-07-15 补充声语信使前期设计报告
2026-07-15 更新声语信使第二版硬件和PCB资料
    [Schematic1_1核心板.schdoc]
2026-07-15 更新收发端软件和板卡测试工程
2026-07-15 补充前导码与同步问题总结报告
2026-07-19 Update second-board three-mode firmware
2026-07-19 整理7月13日起非代码工作日志
2026-07-19 标注文档用途与历史状态
2026-07-19 标注当前硬件与实物调整
2026-07-19 标注当前主工程与历史测试工程
2026-07-19 完善仓库首页与版本导航
2026-07-19 保留答辩HEX原始字节与校验值
2026-07-19 更新嘉立创EDA final硬件工程
2026-07-19 第三次工作日志
