epidimobife96-rgb/shengyu-xinshi/(notices)

Notices in the files:
software/stm32_send/Core/Src/main.c:
Copyright (c) 2026 STMicroelectronics.
All rights reserved.
This software is licensed under terms that can be found in the LICENSE file
